Quphoria/Electronics-Project/5- Circuit Design/Pictures/IMG_9014.JPG

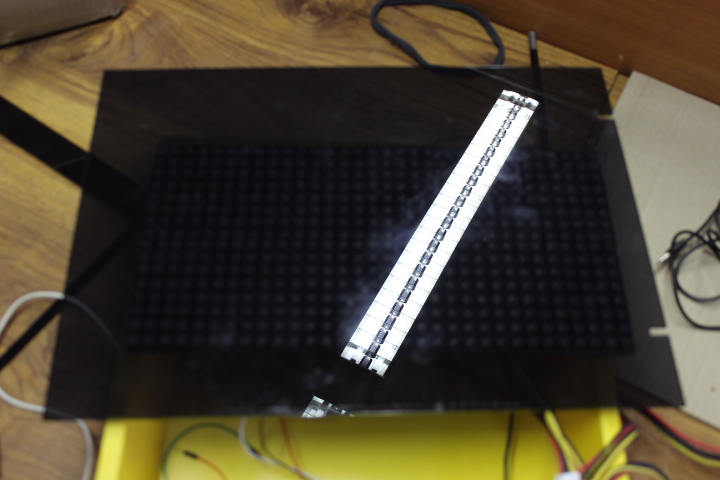
5- Circuit Design/Pictures/IMG_9014.JPG
