Quphoria/Electronics-Project/README.md

# Electronics-Project
Repo of my Project for my GCSE Electronics

The examiners will only see the powerpoint as that is what you submit along with the finished product
