Quphoria/Electronics-Project/5- Circuit Design/Electronics Project Connectors.docx

# Connectors

## Panel Mount

- IEC Power Connector
- DMX Input 3 Pin
- DMX Output 3 Pin

## PCB

- HT3.96mm 3P Glediator Port (5v, Rx, GND)
- 5v USB output for charging devices
- Audio Input 3.5mm Stereo Jack
- Audio Output 3.5mm Stereo Jack
- 3 Pole Mode Selector Switch
- SD Card Slot
