Quphoria/Electronics-Project/Slide Structure.docx

- Title Page - EXAM INFO
- Agenda
- Chosen Brief
- Research/ROI
- Functionalities
  - Overview
    - Functions
  - Control Interfaces
  - APIs
- Hardware
  - External
    - IO
  - Internal
    - PCB
      - Components
      - Circuit
      - IO
      - Programming Connectors
    - Components
    - Mounting Structures
- Software
  - Chosen Languages
  - External libraries
  - Firmware
    - Varieties
  - Software
    - APIs
- Documentation
  - IKEA Manual

Slide Structure
