Quphoria/Electronics-Project/0- Research/Other Electronics Stuff.docx

Other Electronics Stuff

WS2812b led panels, cheapest option available, easy to drive only 1 io pin required (in addition to power and ground) as they are chainable

32x16 led panel size as it is large enough to display enough detail without looking too blocky
