Quphoria/Electronics-Project/2- 3D Modelling/doc03636820170926103018.pdf

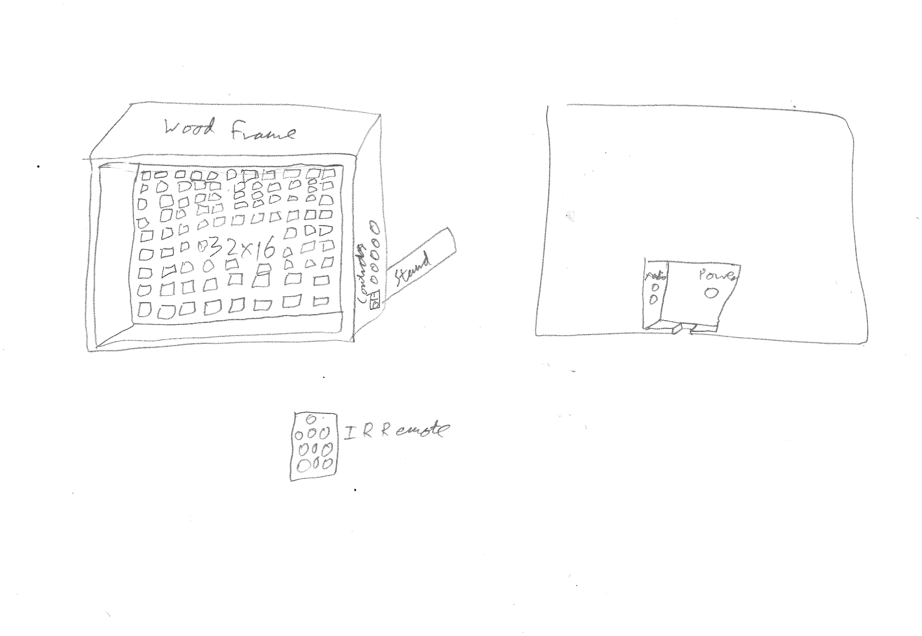
[picture p3: page 1]
