Quphoria/Electronics-Project/0- Research/5v-to-9v-converter.png

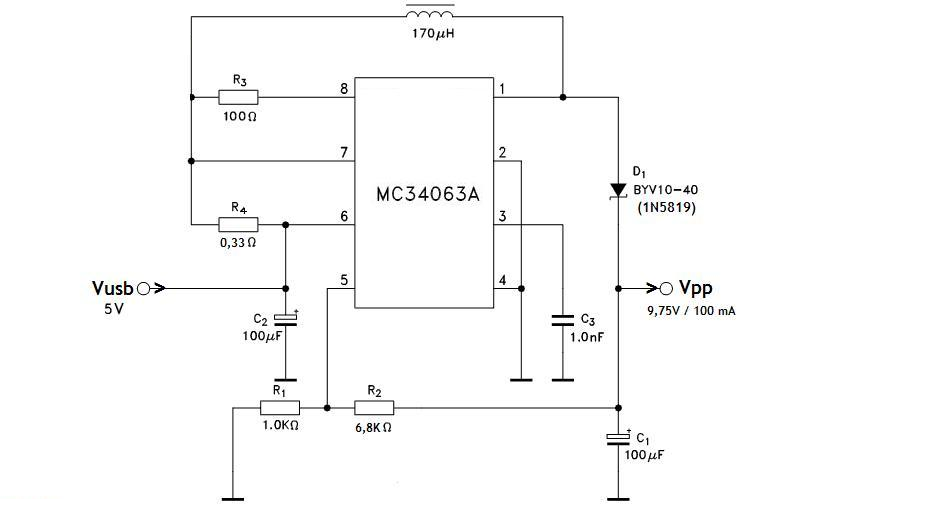
0- Research/5v-to-9v-converter.png
