Quphoria/Electronics-Project/0- Research/ADC mic pre-amp.png

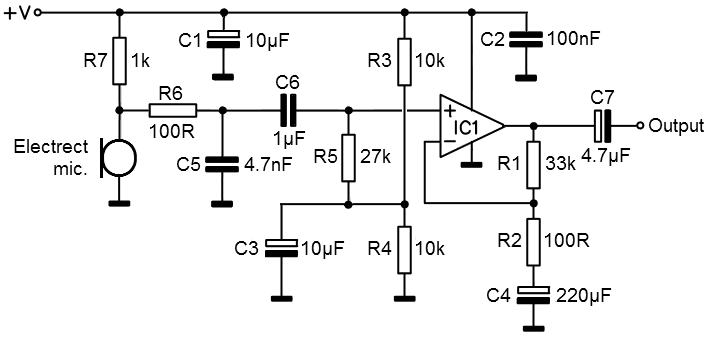
0- Research/ADC mic pre-amp.png
