Quphoria/Electronics-Project/0- Research/ALC.jpg

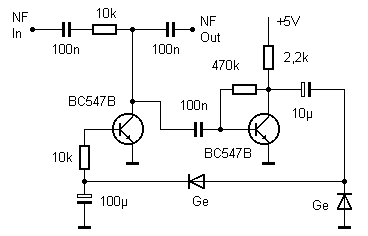
0- Research/ALC.jpg
