Quphoria/Electronics-Project/0- Research/arduino-control-relay-schematic.png

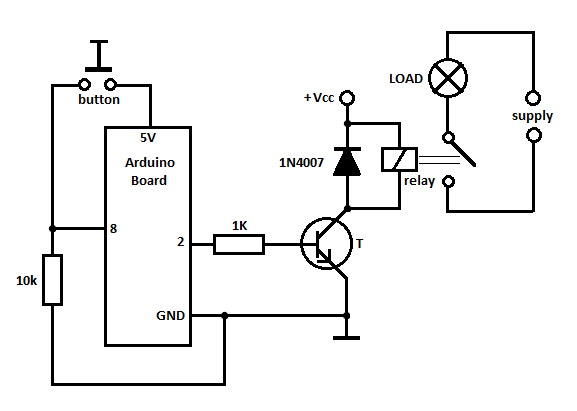
0- Research/arduino-control-relay-schematic.png
