Quphoria/Electronics-Project/0- Research/atmega1284_mighty_pinout.png

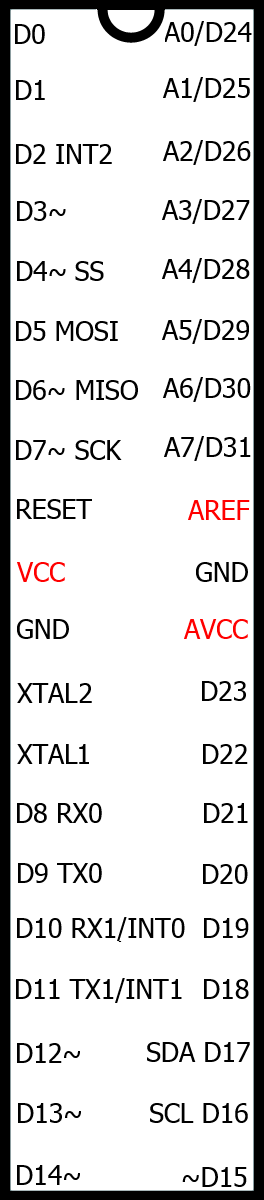
0- Research/atmega1284_mighty_pinout.png
