Quphoria/Electronics-Project/0- Research/atmega1284pins.gif

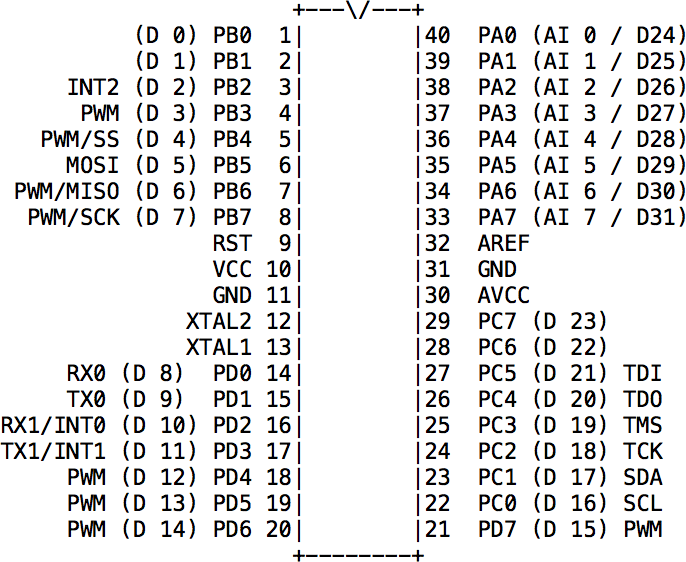
0- Research/atmega1284pins.gif
