Quphoria/Electronics-Project/0- Research/audio-input-amplifier-better.png

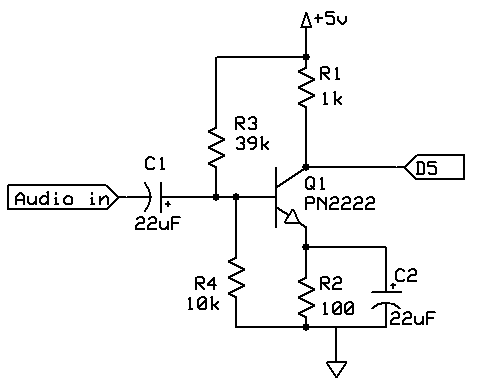
0- Research/audio-input-amplifier-better.png
