Quphoria/Electronics-Project/0- Research/audio_premini_opamp-rev01.png

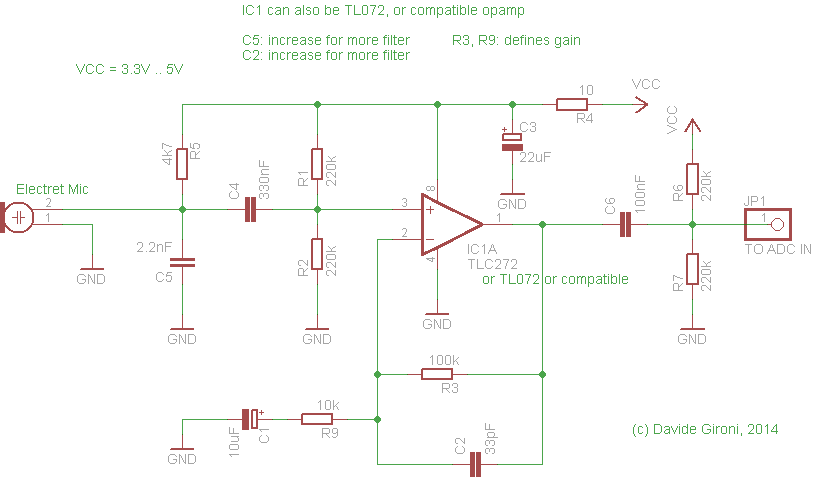
0- Research/audio_premini_opamp-rev01.png
