Quphoria/Electronics-Project/0- Research/buffer-envelope.jpg

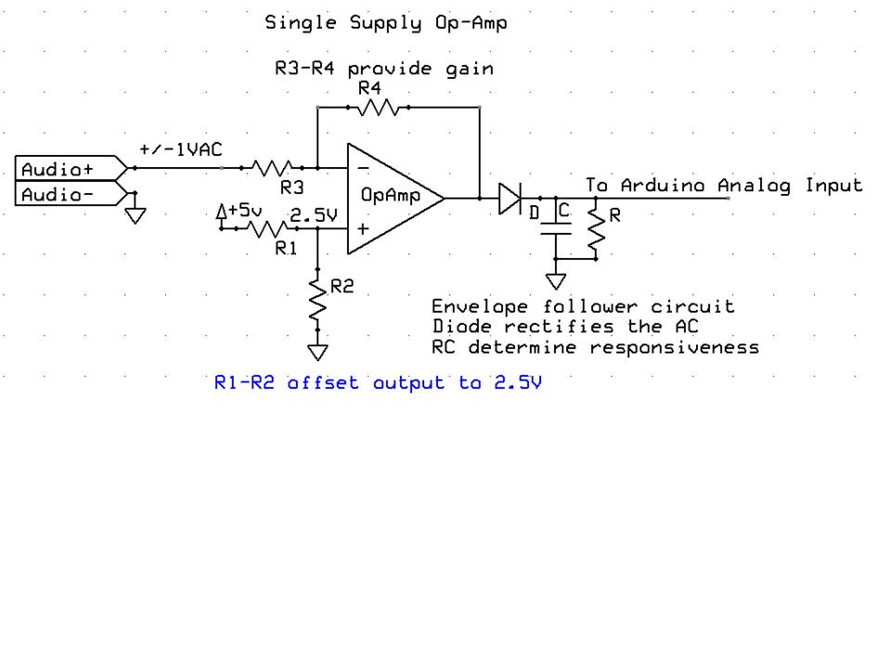
0- Research/buffer-envelope.jpg
