Quphoria/Electronics-Project/0- Research/Electret mic preamp.PNG

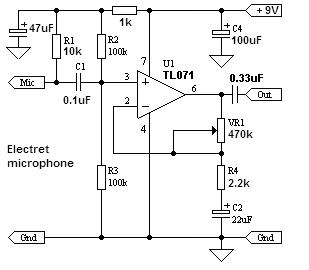
0- Research/Electret mic preamp.PNG
