Quphoria/Electronics-Project/0- Research/Mono-to-stereo.gif

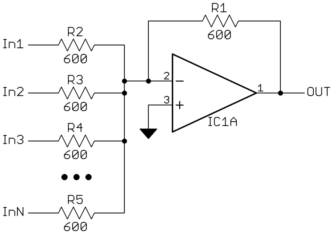
0- Research/Mono-to-stereo.gif
