Quphoria/Electronics-Project/0- Research/preamp_circuit.png

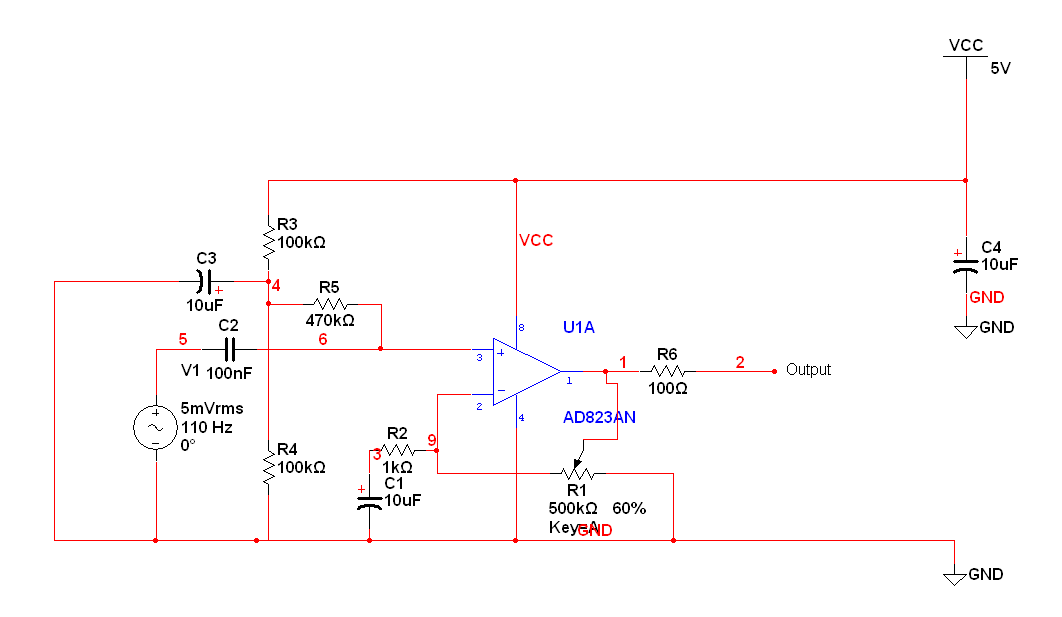
0- Research/preamp_circuit.png
