Quphoria/Electronics-Project/0- Research/ScreenShot_20180316131631.png

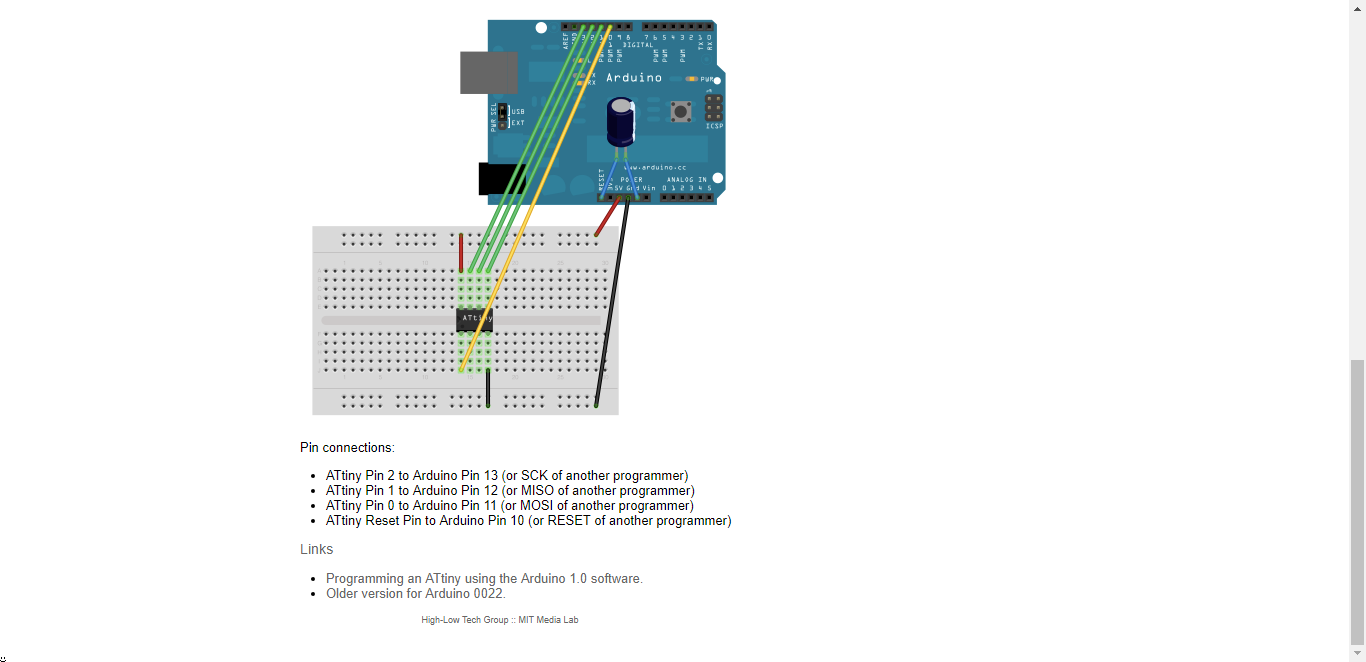
0- Research/ScreenShot_20180316131631.png
