Quphoria/Electronics-Project/0- Research/zofzJ.png

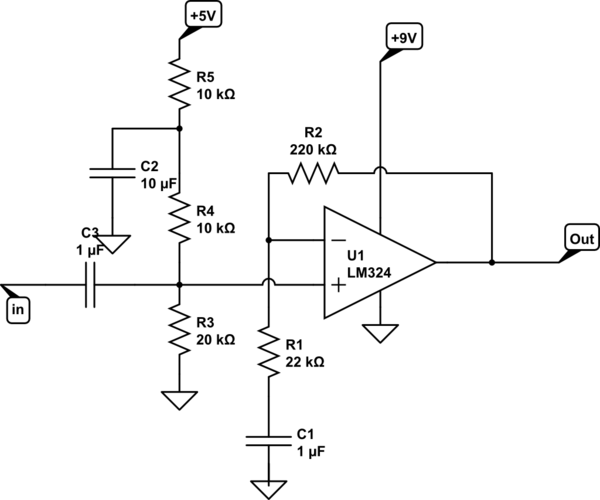
0- Research/zofzJ.png
