Quphoria/Electronics-Project/2- 3D Modelling/Pictures/20180205_141921.jpg

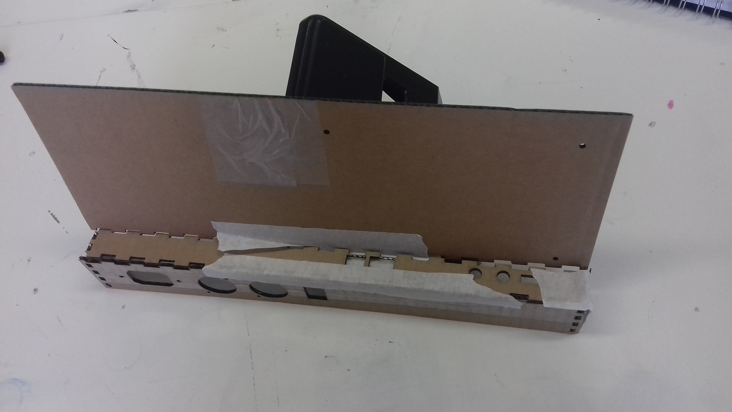
2- 3D Modelling/Pictures/20180205_141921.jpg
