Quphoria/Electronics-Project/3- Renders/V47/Design v47 _ Back Panel.png

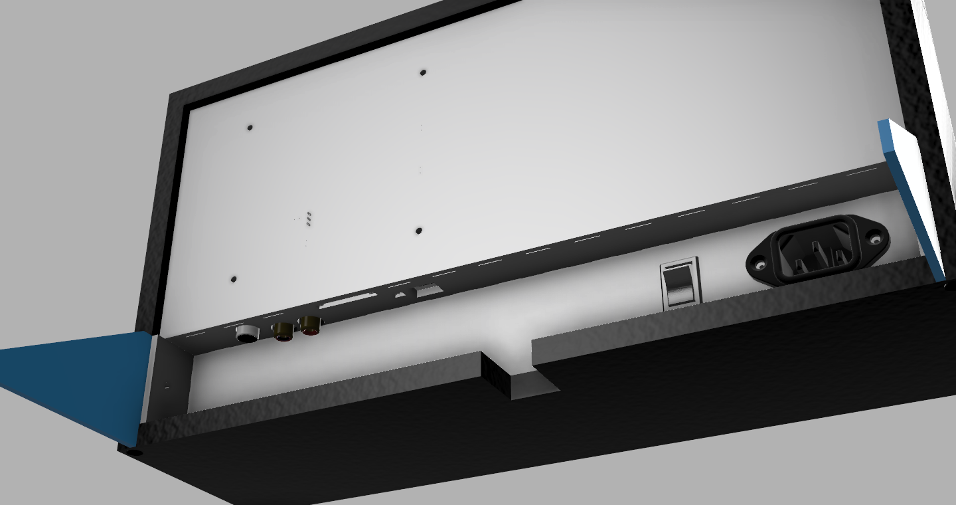
3- Renders/V47/Design v47 _ Back Panel.png
