Quphoria/Electronics-Project/3- Renders/V47/Design v47 _ IO.png

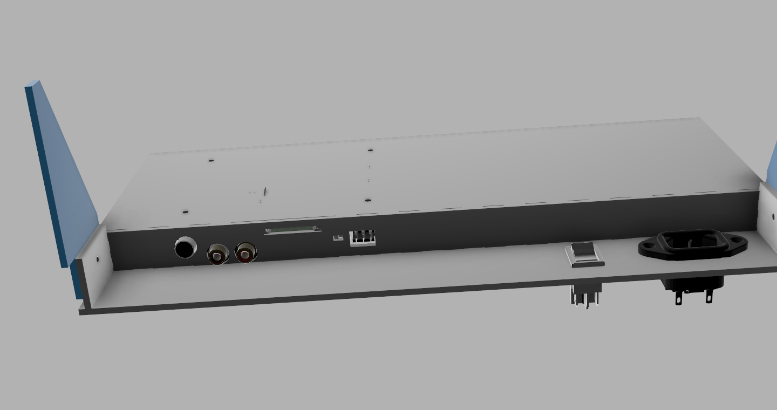
3- Renders/V47/Design v47 _ IO.png
