Quphoria/Electronics-Project/3- Renders/V47/Design v47 _ Side Inside.png

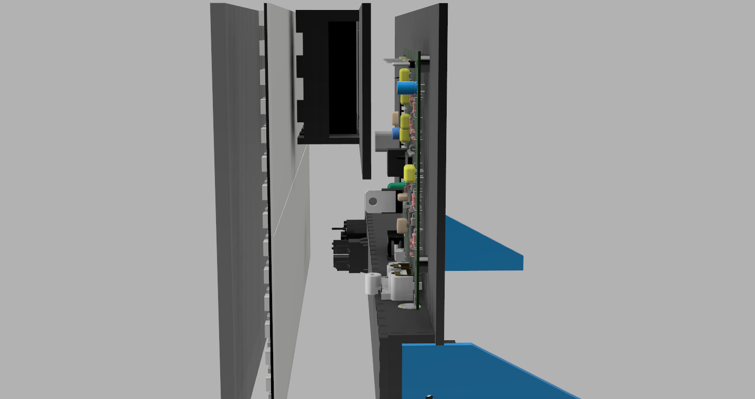
3- Renders/V47/Design v47 _ Side Inside.png
