Quphoria/Electronics-Project/4- 2D Exports/Photos (2)/20171108_210314.jpg

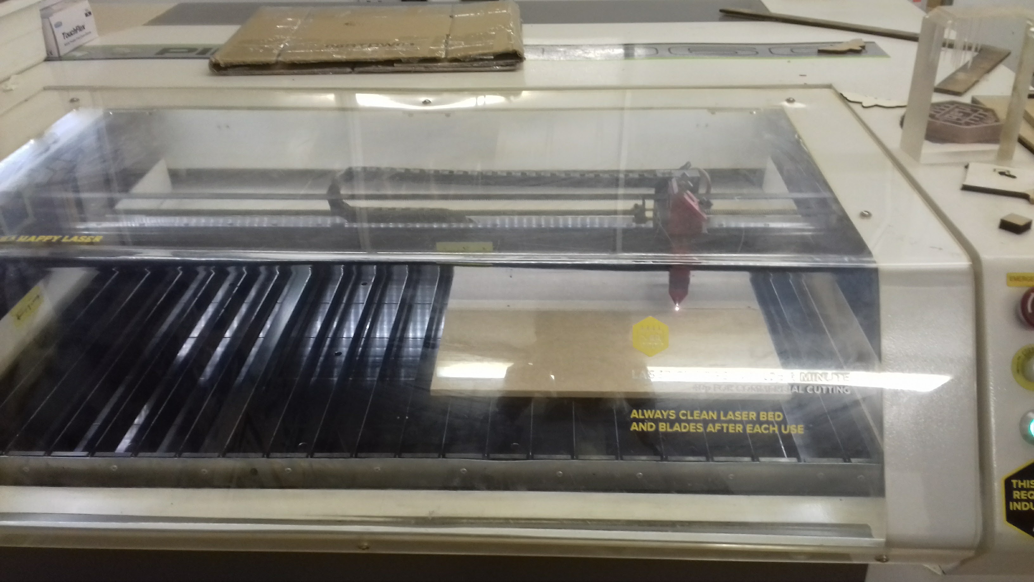
4- 2D Exports/Photos (2)/20171108_210314.jpg
