Quphoria/Electronics-Project/4- 2D Exports/Photos (2)/20171109_074142.jpg

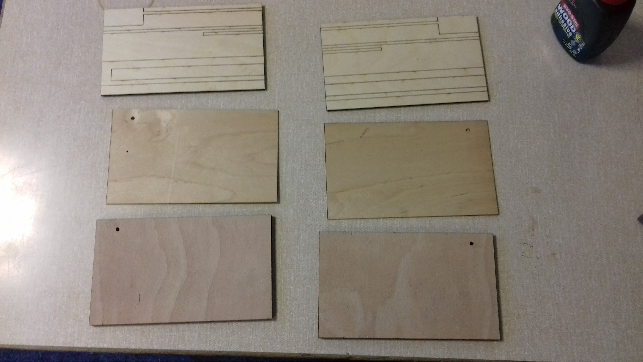
4- 2D Exports/Photos (2)/20171109_074142.jpg
