Quphoria/Electronics-Project/4- 2D Exports/Photos (2)/20171109_153801.jpg

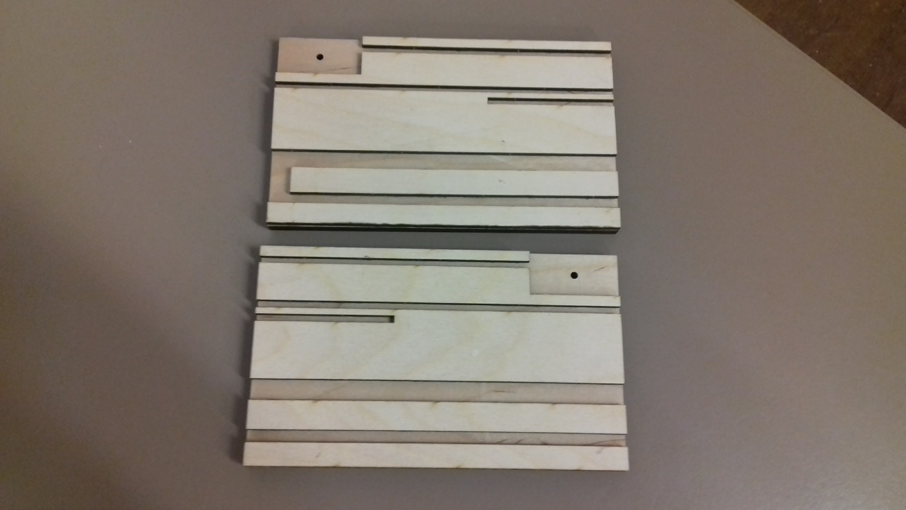
4- 2D Exports/Photos (2)/20171109_153801.jpg
