Quphoria/Electronics-Project/4- 2D Exports/Photos (2)/20171112_120552.jpg

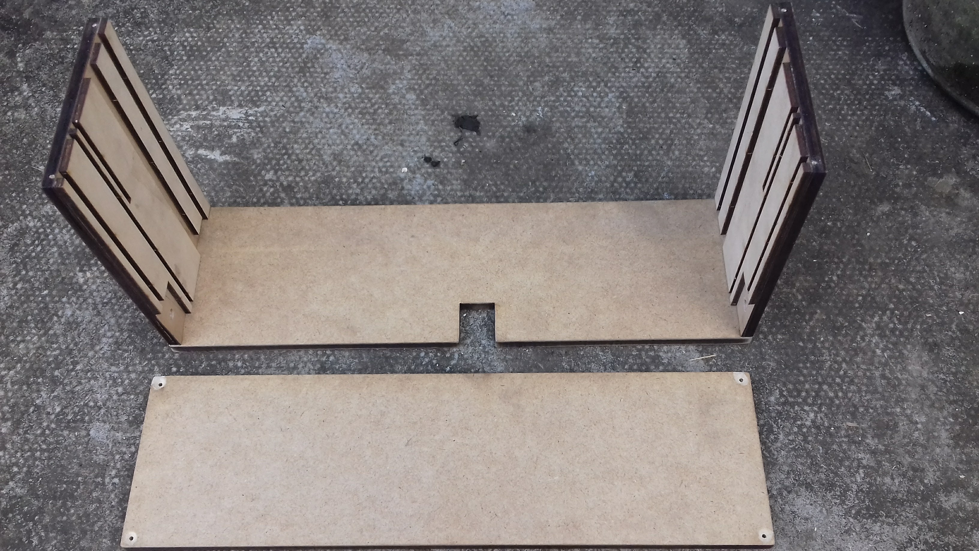
4- 2D Exports/Photos (2)/20171112_120552.jpg
