Quphoria/Electronics-Project/4- 2D Exports/Photos (2)/20180123_092703.jpg

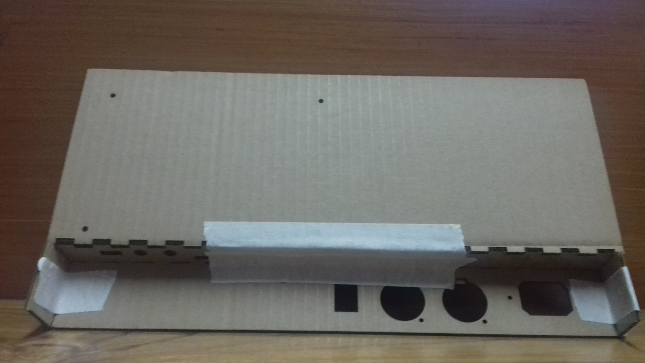
4- 2D Exports/Photos (2)/20180123_092703.jpg
