Quphoria/Electronics-Project/4- 2D Exports/Photos (2)/20180227_095030.jpg

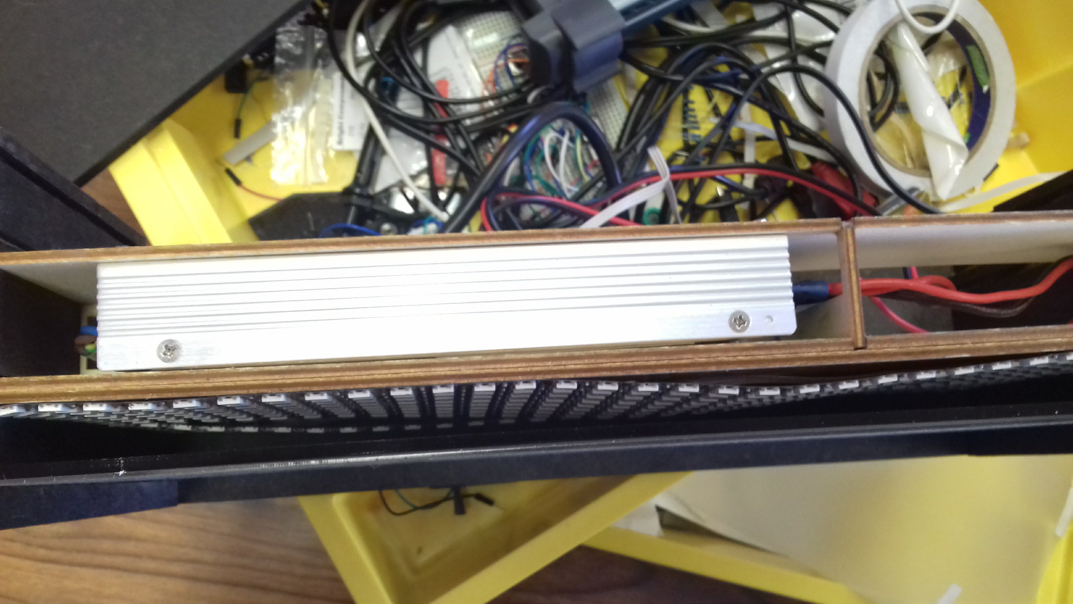
4- 2D Exports/Photos (2)/20180227_095030.jpg
