Quphoria/Electronics-Project/4- 2D Exports/Photos (2)/20180228_175823.jpg

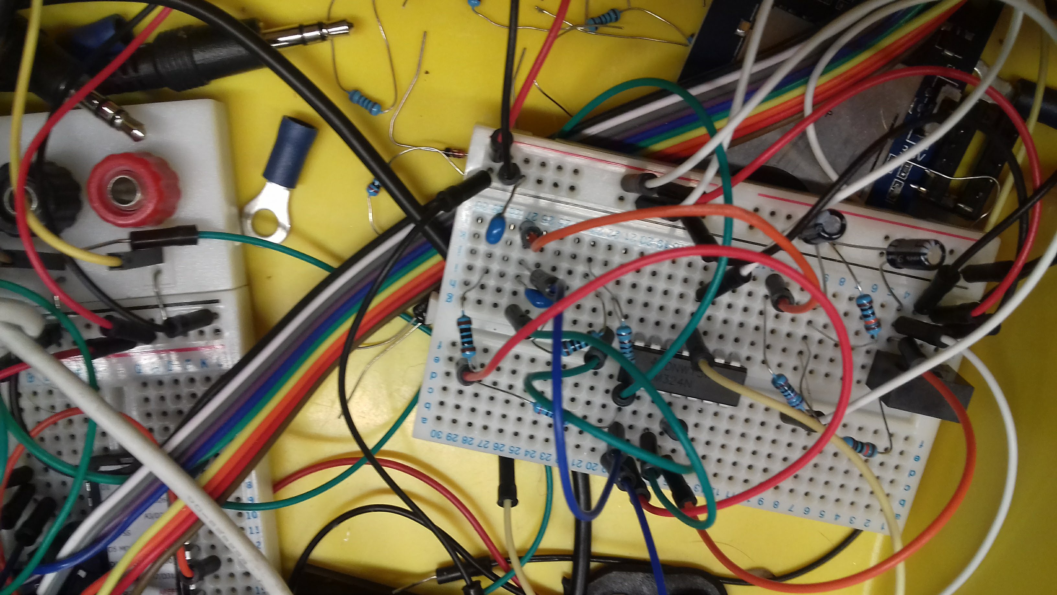
4- 2D Exports/Photos (2)/20180228_175823.jpg
