Quphoria/Electronics-Project/4- 2D Exports/Photos (2)/20180306_091829(0).jpg

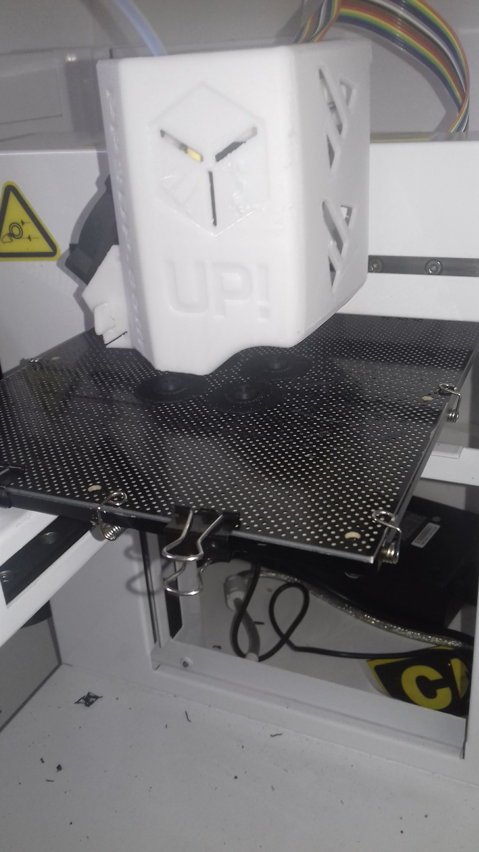
4- 2D Exports/Photos (2)/20180306_091829(0).jpg
