Quphoria/Electronics-Project/4- 2D Exports/Photos (2)/20180312_135606.jpg

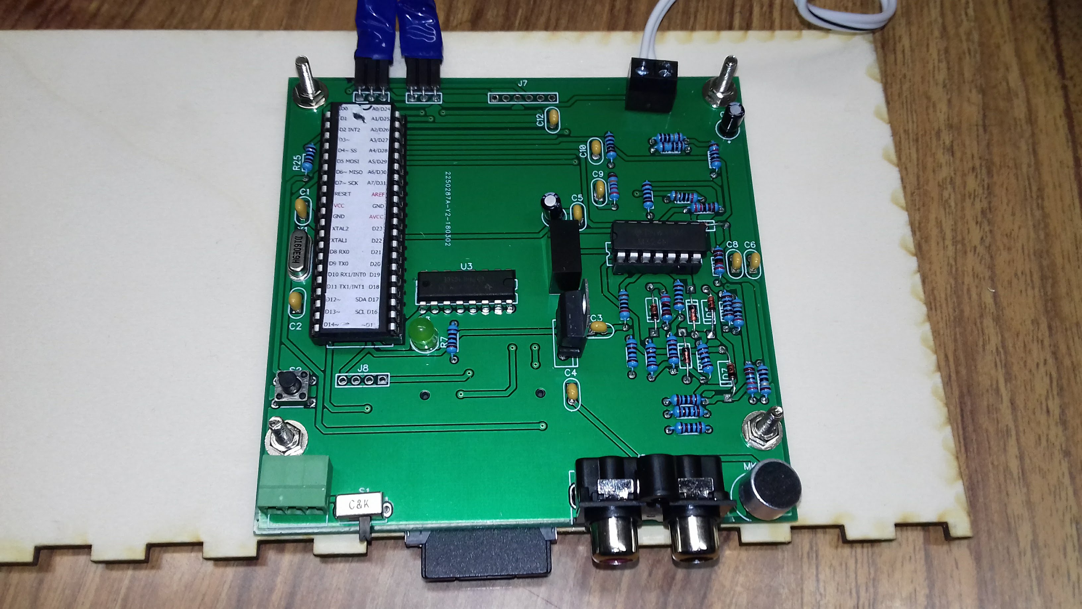
4- 2D Exports/Photos (2)/20180312_135606.jpg
