Quphoria/Electronics-Project/4- 2D Exports/Photos (2)/20180314_144740.jpg

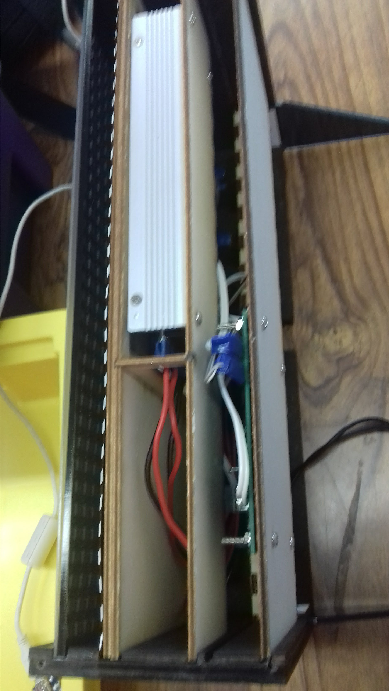
4- 2D Exports/Photos (2)/20180314_144740.jpg
