Quphoria/Electronics-Project/4- 2D Exports/Photos (2)/20180321_145808.jpg

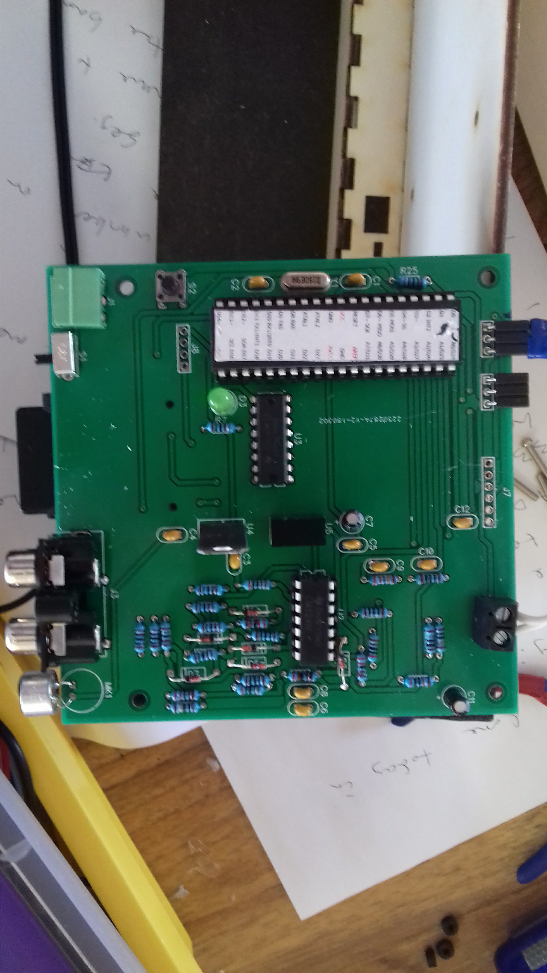
4- 2D Exports/Photos (2)/20180321_145808.jpg
