Quphoria/Electronics-Project/4- 2D Exports/Photos (2)/20180321_153848.jpg

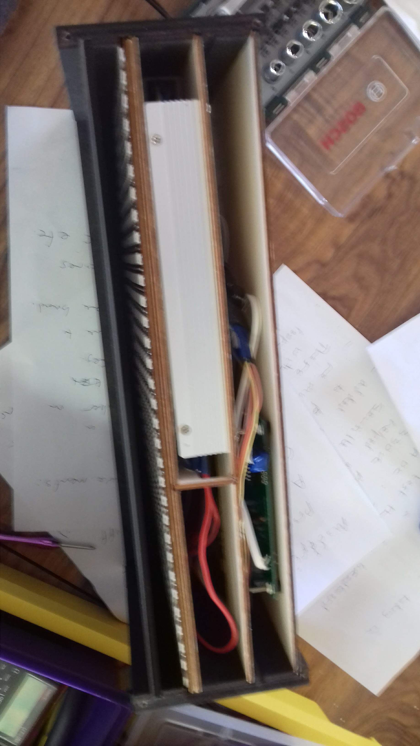
4- 2D Exports/Photos (2)/20180321_153848.jpg
