Quphoria/Electronics-Project/4- 2D Exports/Photos (2)/20180322_100650.jpg

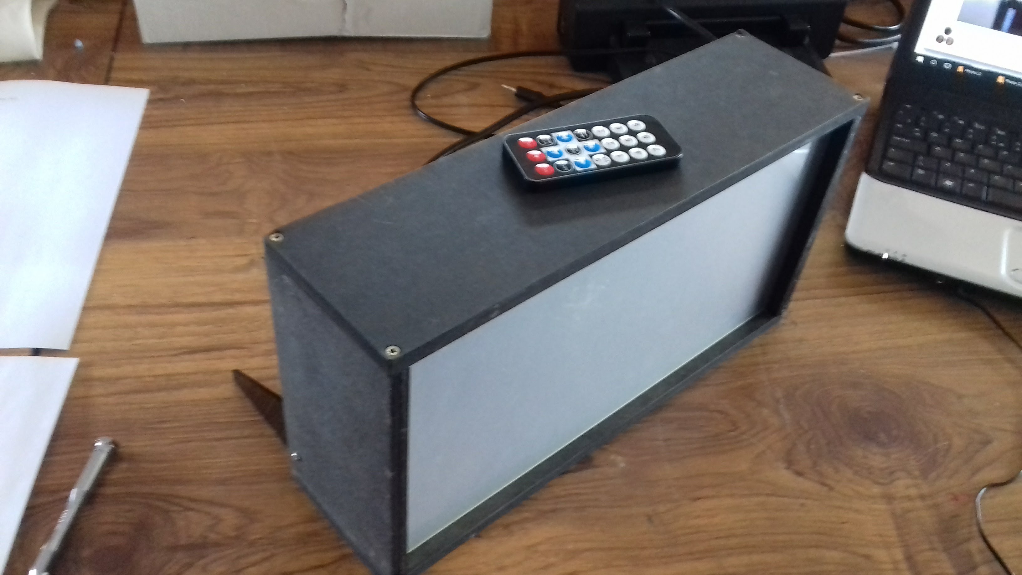
4- 2D Exports/Photos (2)/20180322_100650.jpg
