Quphoria/Electronics-Project/5- Circuit Design/Pictures/20171003_100548.jpg

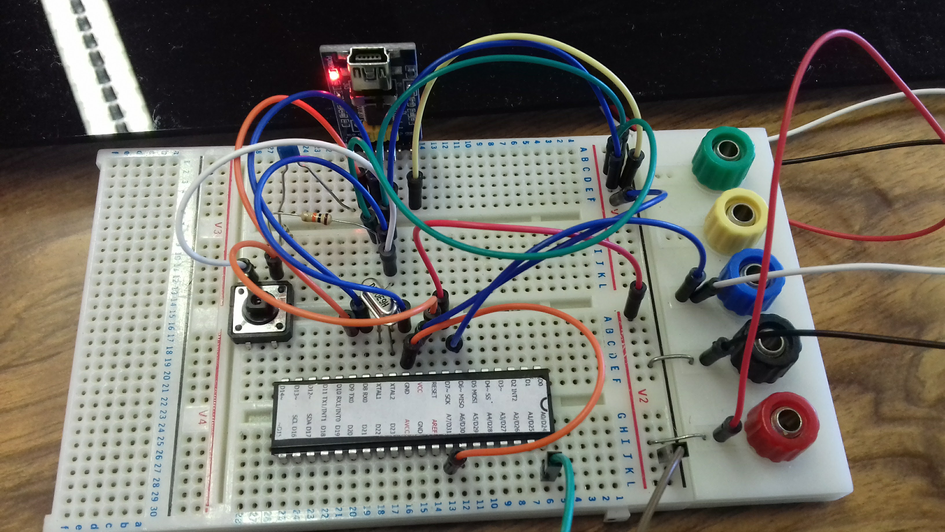
5- Circuit Design/Pictures/20171003_100548.jpg
