Quphoria/Electronics-Project/5- Circuit Design/Pictures/20171003_100621.jpg

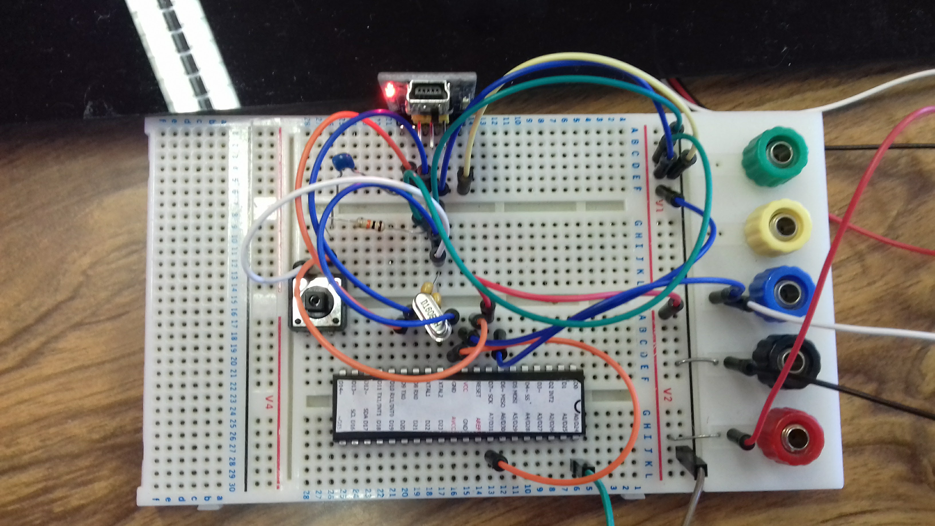
5- Circuit Design/Pictures/20171003_100621.jpg
