Quphoria/Electronics-Project/5- Circuit Design/Pictures/IMG_9013.JPG

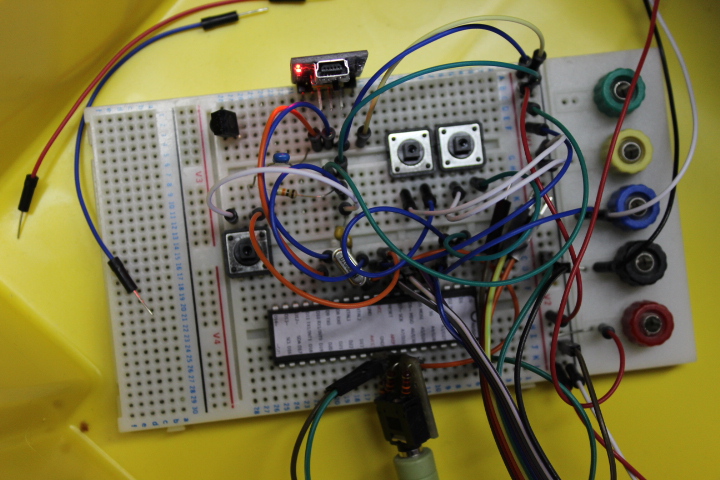
5- Circuit Design/Pictures/IMG_9013.JPG
