Quphoria/Electronics-Project/5- Circuit Design/Pictures/IMG_9015.JPG

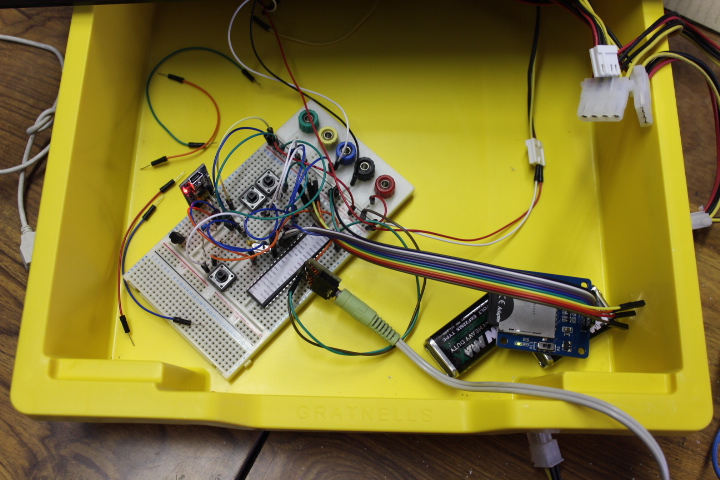
5- Circuit Design/Pictures/IMG_9015.JPG
