Quphoria/Electronics-Project/5- Circuit Design/Pictures/IMG_9018.JPG

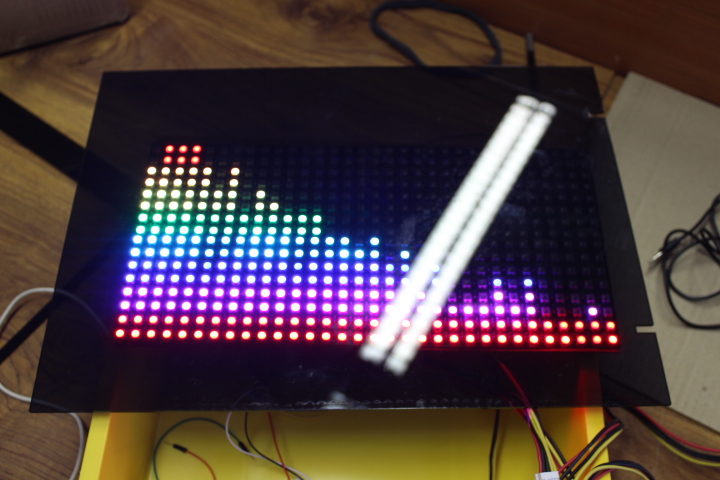
5- Circuit Design/Pictures/IMG_9018.JPG
