Quphoria/Electronics-Project/5- Circuit Design/Pictures/IMG_9019.JPG

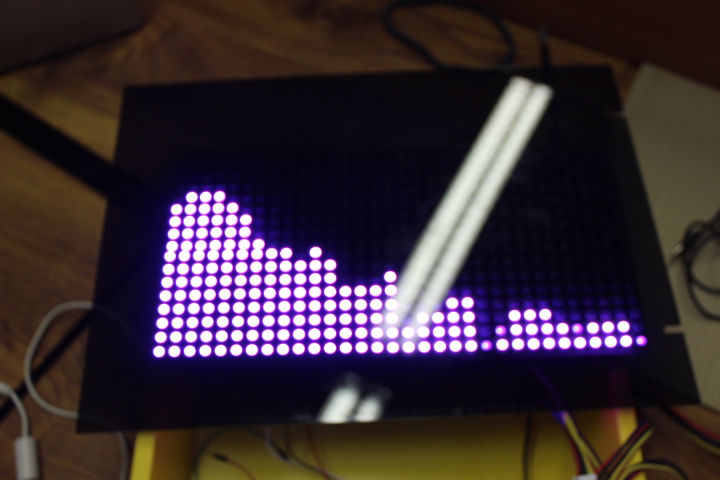
5- Circuit Design/Pictures/IMG_9019.JPG
