Quphoria/Electronics-Project/5- Circuit Design/Pictures/IMG_9020.JPG

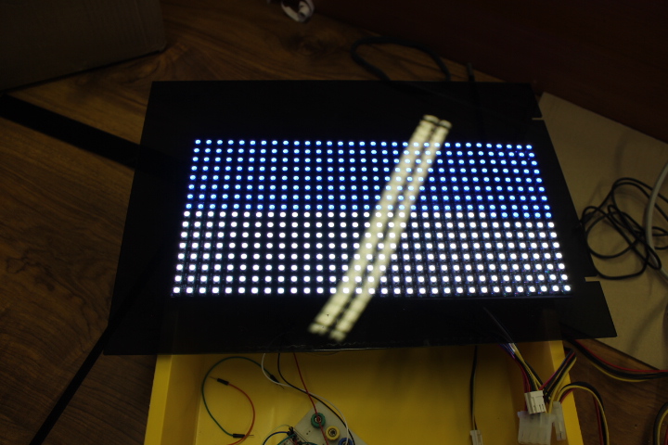
5- Circuit Design/Pictures/IMG_9020.JPG
