Quphoria/Electronics-Project/5- Circuit Design/Pictures/IMG_9021.JPG

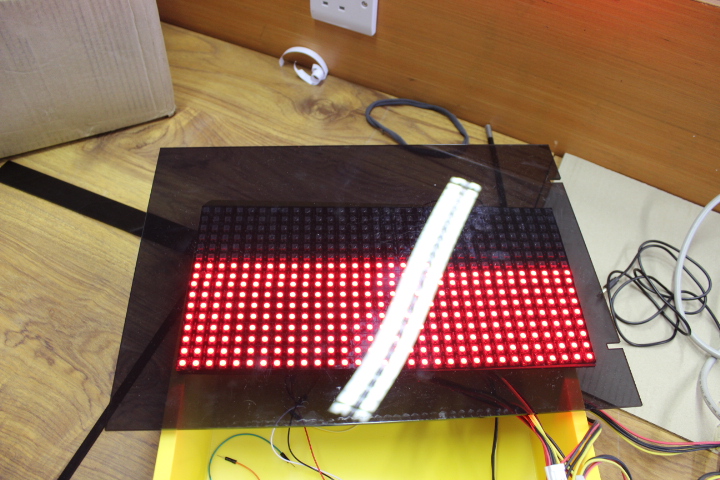
5- Circuit Design/Pictures/IMG_9021.JPG
