Quphoria/Electronics-Project/5- Circuit Design/Pictures/IMG_9022.JPG

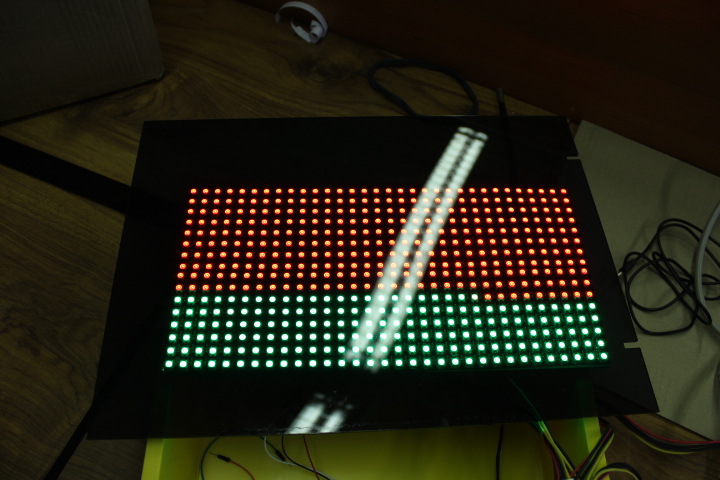
5- Circuit Design/Pictures/IMG_9022.JPG
