Quphoria/Electronics-Project/5- Circuit Design/Pictures/IR_Board_Schem.png

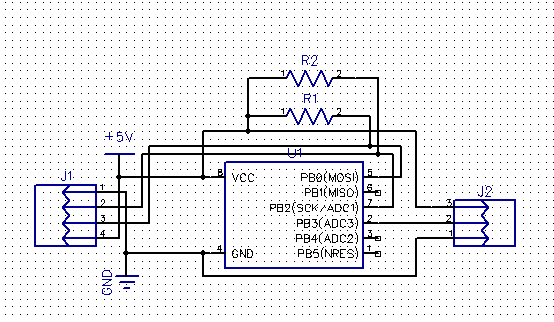
5- Circuit Design/Pictures/IR_Board_Schem.png
