Quphoria/Electronics-Project/5- Circuit Design/Pictures/PCBBottom.png

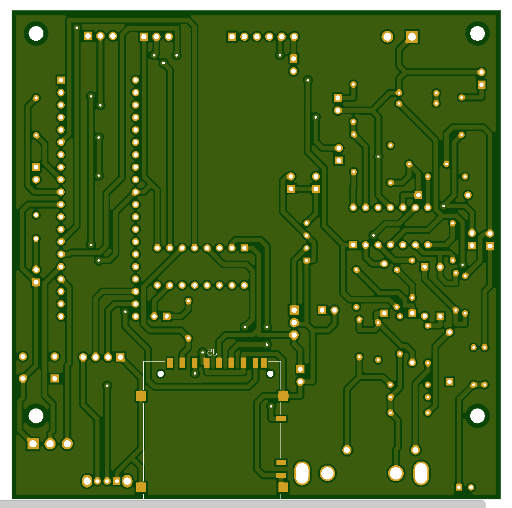
5- Circuit Design/Pictures/PCBBottom.png
