Quphoria/Electronics-Project/5- Circuit Design/Pictures/PCBTop.png

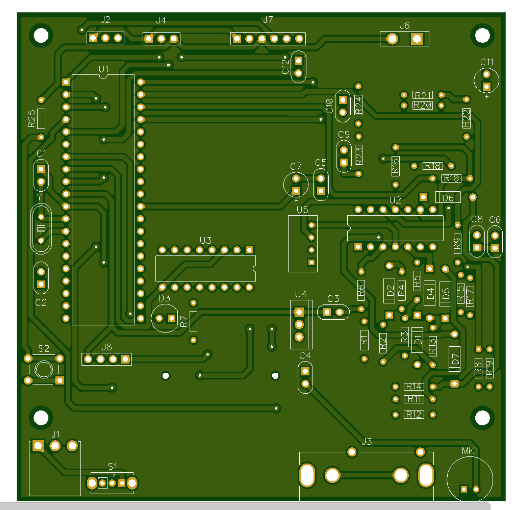
5- Circuit Design/Pictures/PCBTop.png
