Quphoria/Electronics-Project/5- Circuit Design/Pictures/Schematic.png

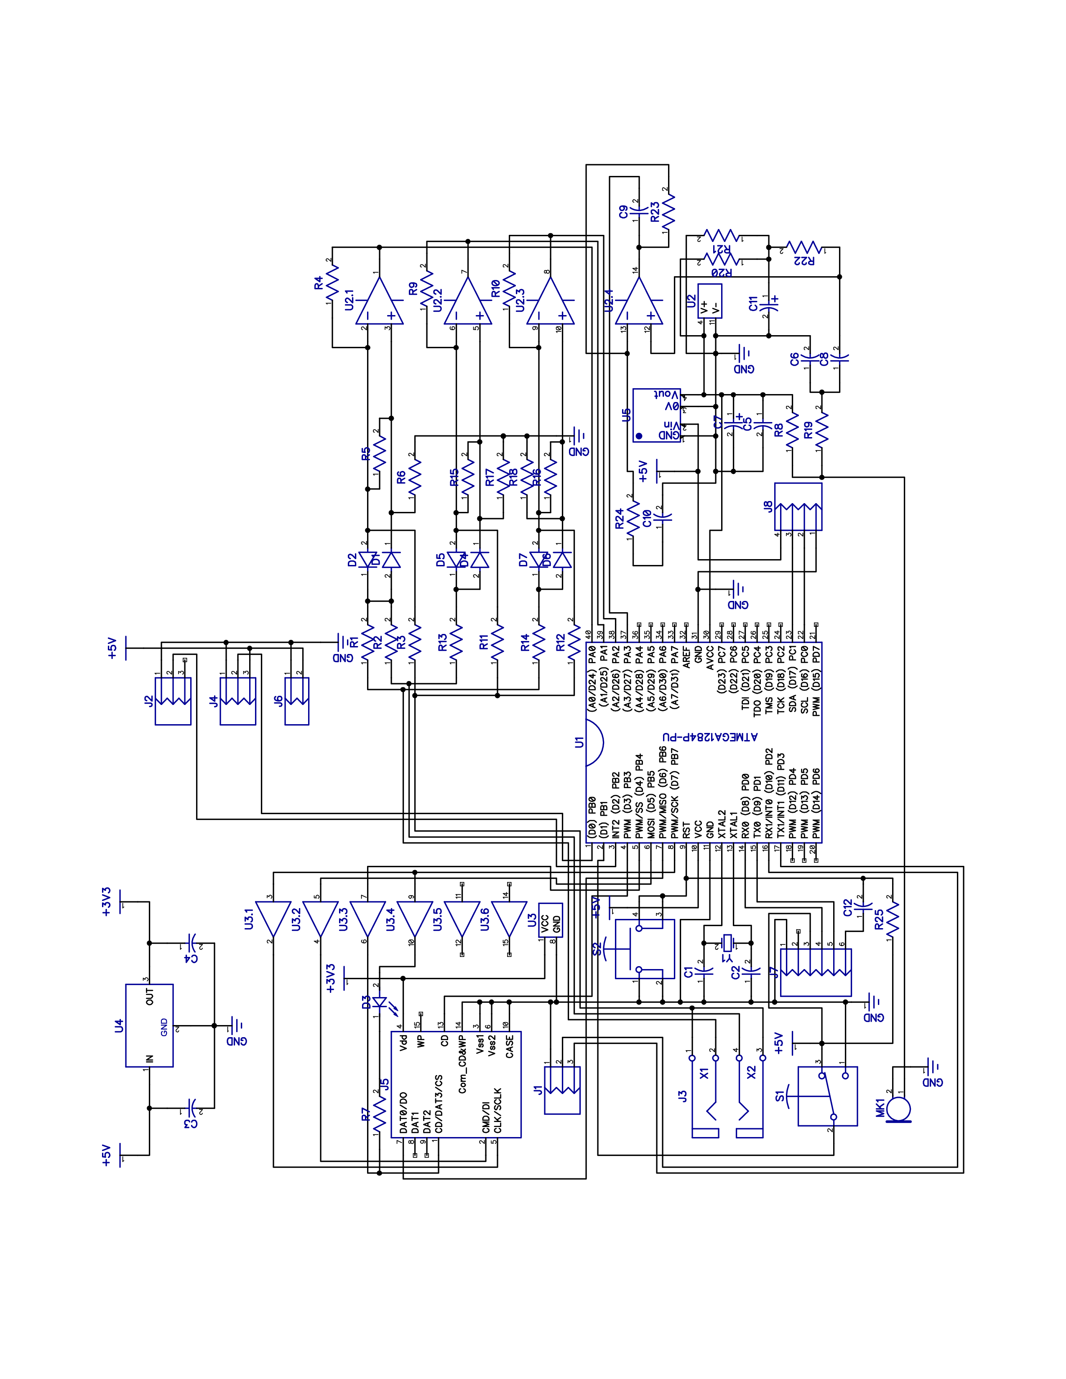
5- Circuit Design/Pictures/Schematic.png
