Quphoria/Electronics-Project/5- Circuit Design/Pictures/ScreenShot_20180125225506.png

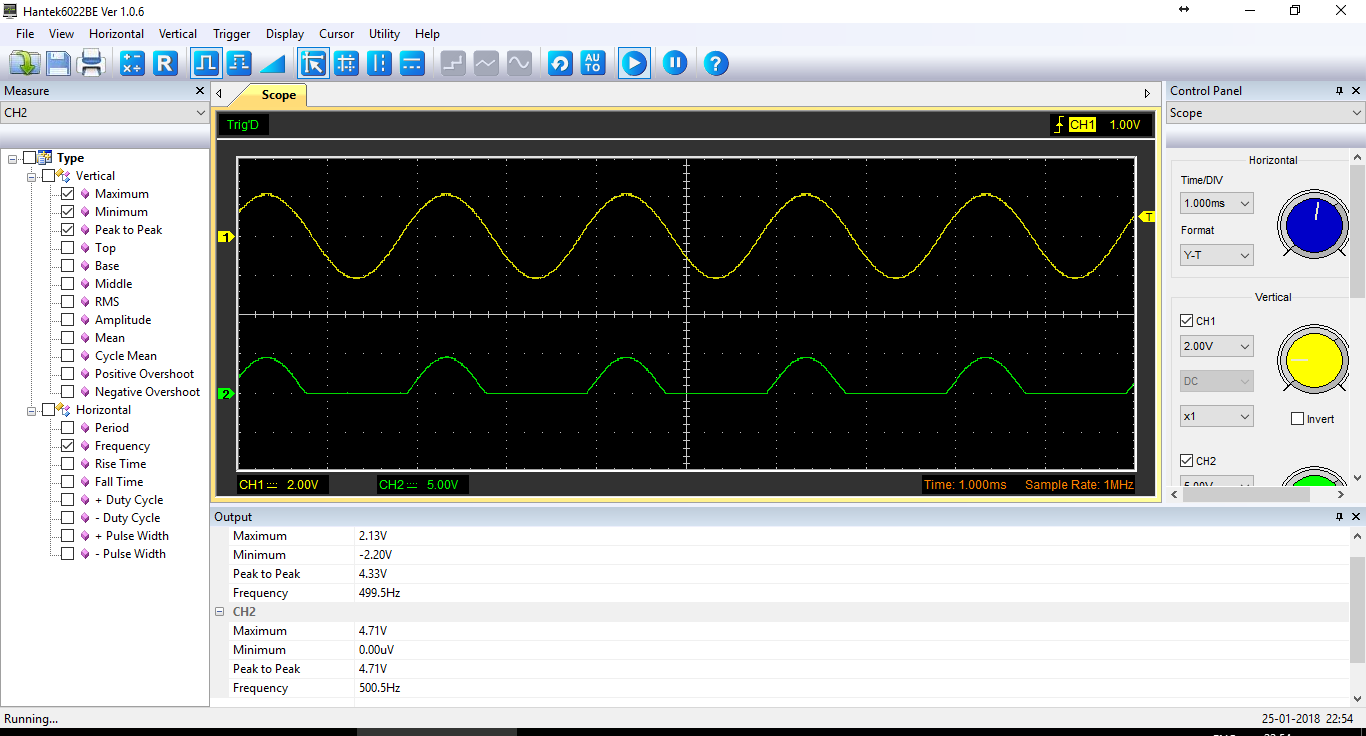
5- Circuit Design/Pictures/ScreenShot_20180125225506.png
