Quphoria/Electronics-Project/5- Circuit Design/Pictures/ScreenShot_20180126074123.png

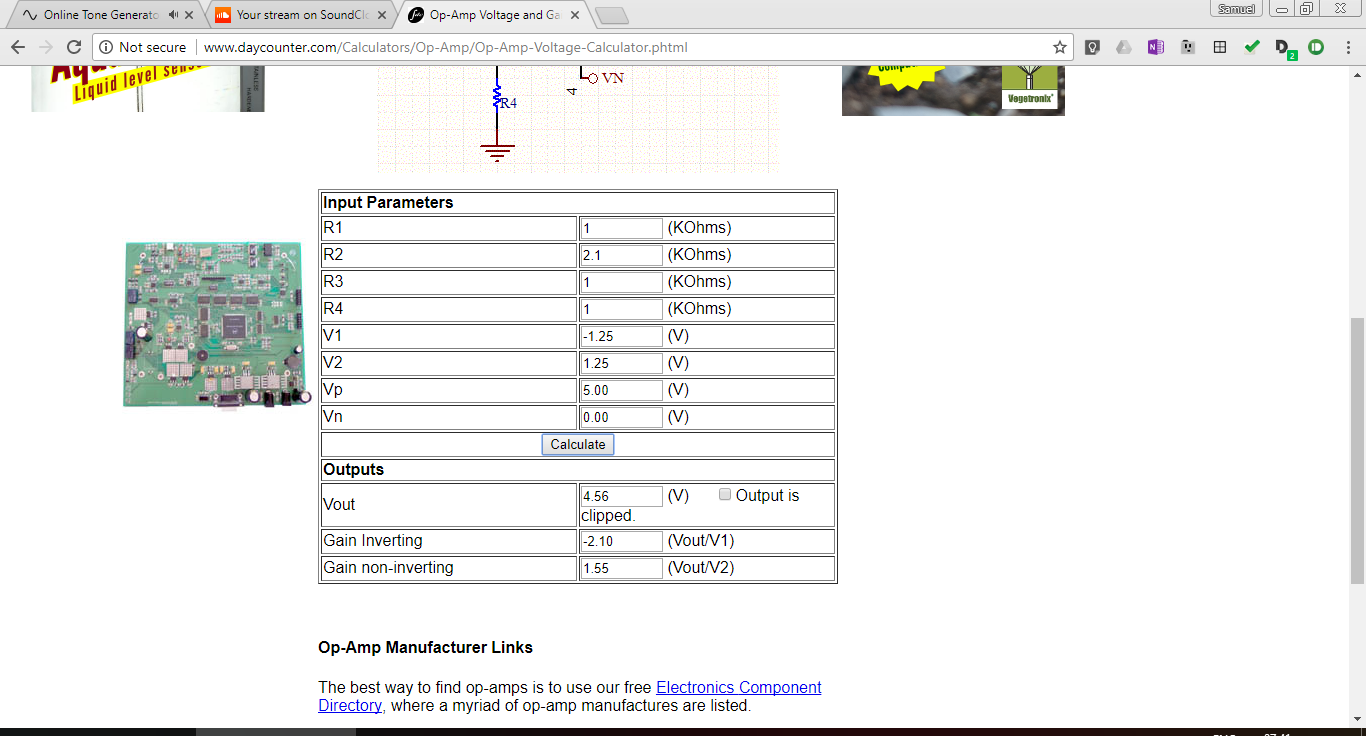
5- Circuit Design/Pictures/ScreenShot_20180126074123.png
