Quphoria/Electronics-Project/5- Circuit Design/Pictures/ScreenShot_20180301112355 - Mic.png

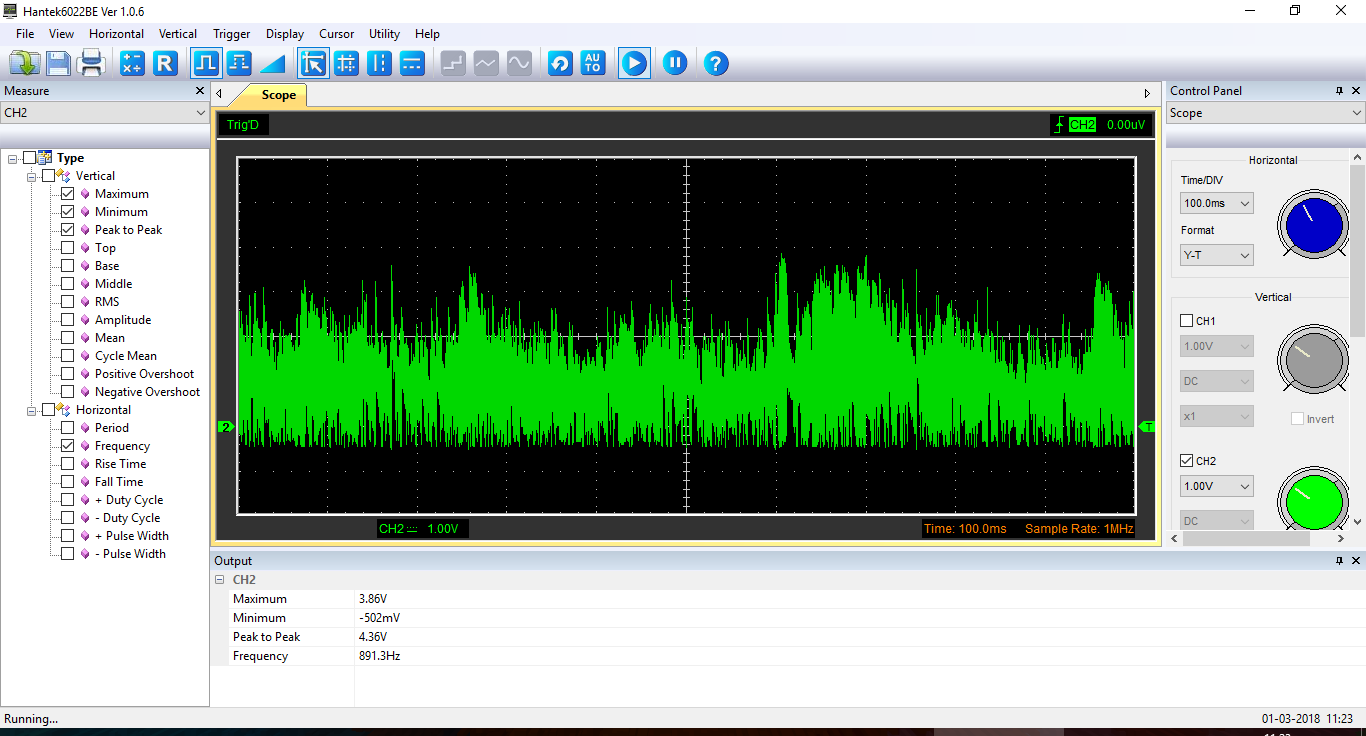
5- Circuit Design/Pictures/ScreenShot_20180301112355 - Mic.png
