Quphoria/Electronics-Project/5- Circuit Design/Pictures/ScreenShot_20180303102331 _ 3D PCB Back.png

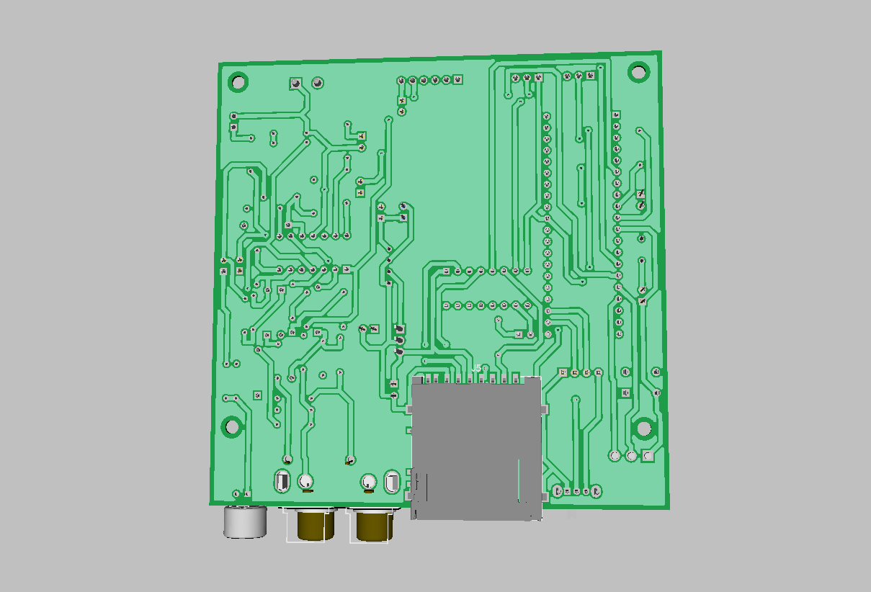
5- Circuit Design/Pictures/ScreenShot_20180303102331 _ 3D PCB Back.png
