Quphoria/Electronics-Project/5- Circuit Design/Pictures/ScreenShot_20180303102408 _ 3D PCB Front.png

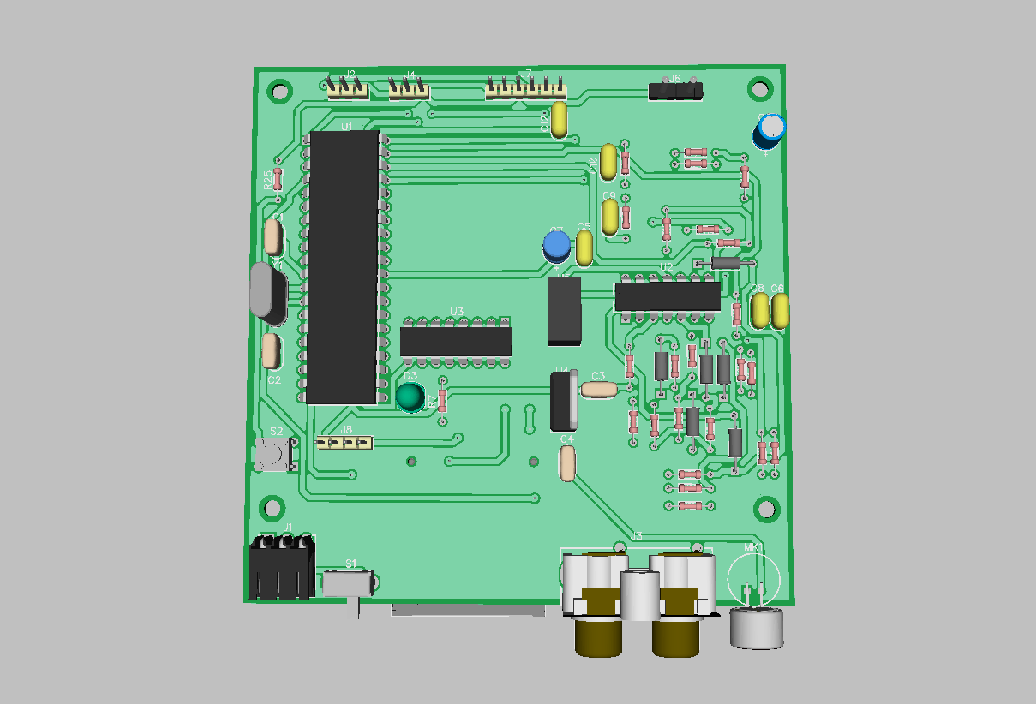
5- Circuit Design/Pictures/ScreenShot_20180303102408 _ 3D PCB Front.png
