Quphoria/Electronics-Project/5- Circuit Design/Pictures/ScreenShot_20180303102440 _ 3D PCB Side.png

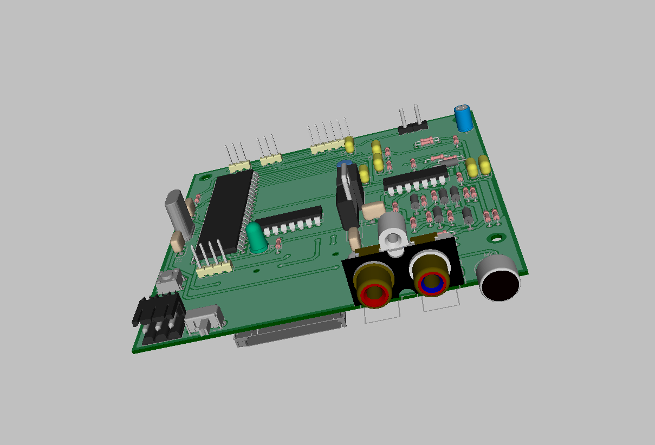
5- Circuit Design/Pictures/ScreenShot_20180303102440 _ 3D PCB Side.png
