Quphoria/Electronics-Project/5- Circuit Design/Pictures/ScreenShot_20180303102508 _ 3D PCB Side 2.png

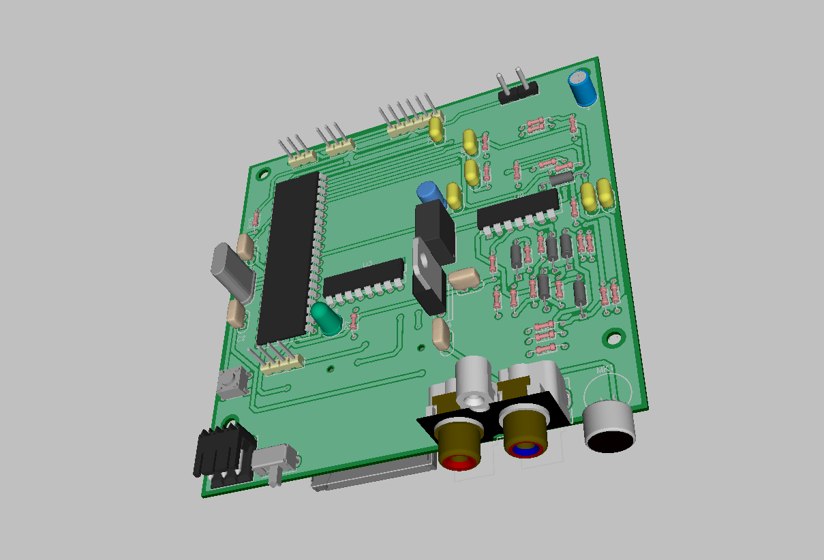
5- Circuit Design/Pictures/ScreenShot_20180303102508 _ 3D PCB Side 2.png
