Quphoria/Electronics-Project/5- Circuit Design/Pictures/ScreenShot_20180303102555 _ PCB Status 77.png

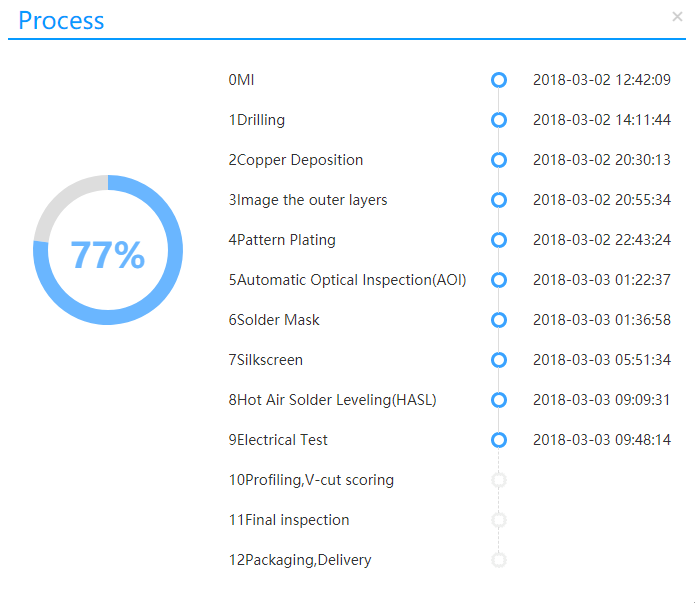
5- Circuit Design/Pictures/ScreenShot_20180303102555 _ PCB Status 77.png
