Quphoria/Electronics-Project/6- Programming/0- Image Converter/SCAN0001.JPG

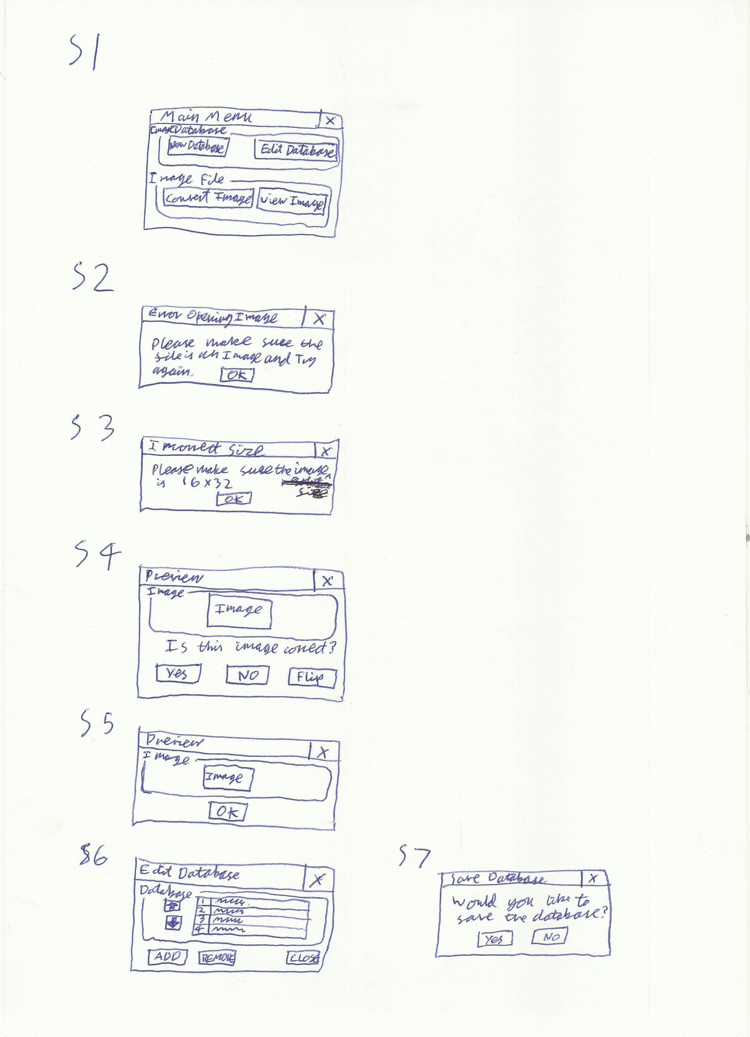
6- Programming/0- Image Converter/SCAN0001.JPG
