Quphoria/Electronics-Project/6- Programming/0- Image Converter/Screenshots/ScreenShot_20180325222139.png

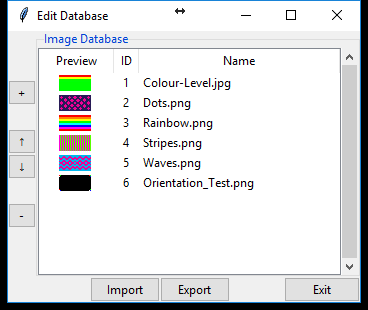
6- Programming/0- Image Converter/Screenshots/ScreenShot_20180325222139.png
