Quphoria/Electronics-Project/6- Programming/ScreenShot_20180302112759 _ Program Start.png

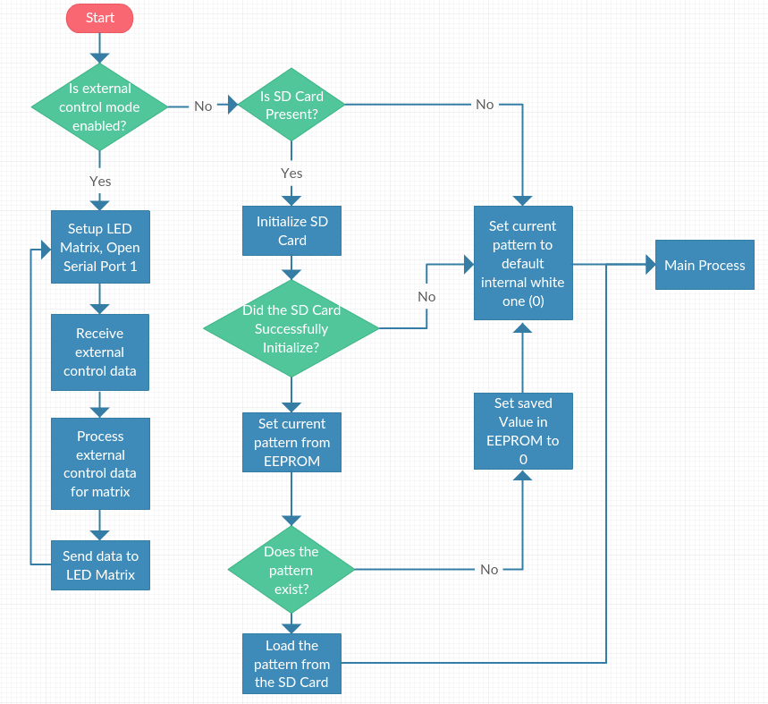
6- Programming/ScreenShot_20180302112759 _ Program Start.png
