Quphoria/Electronics-Project/6- Programming/ScreenShot_20180302112841 _ Main Process.png

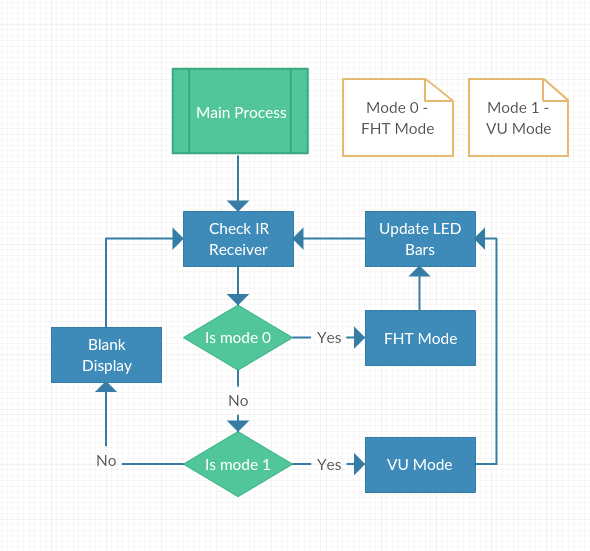
6- Programming/ScreenShot_20180302112841 _ Main Process.png
