Quphoria/Electronics-Project/6- Programming/ScreenShot_20180302112857 _ Display Functions.png

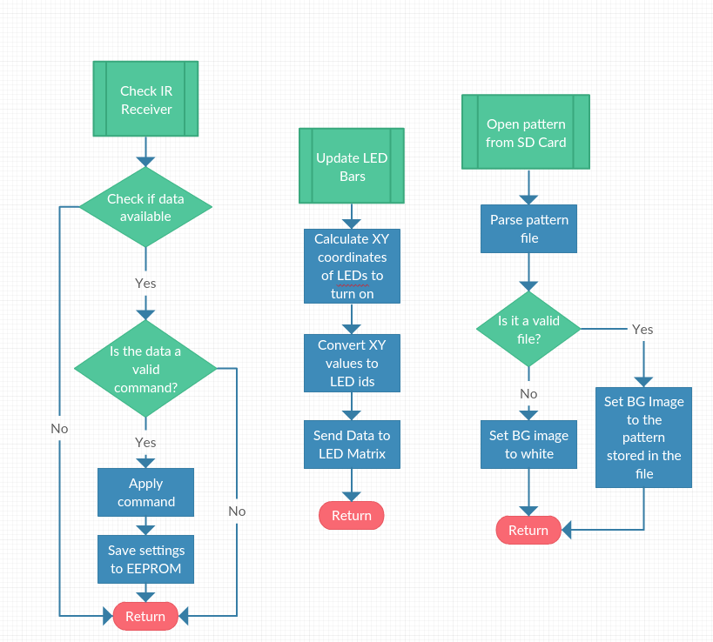
6- Programming/ScreenShot_20180302112857 _ Display Functions.png
