Quphoria/Electronics-Project/6- Programming/ScreenShot_20180302112916 _ Process Functions.png

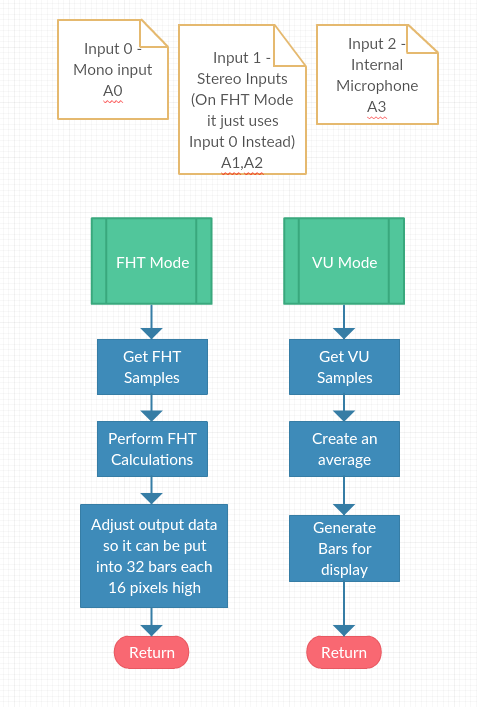
6- Programming/ScreenShot_20180302112916 _ Process Functions.png
