Quphoria/Electronics-Project/7- Analysis/Photos/20180322_161521.jpg

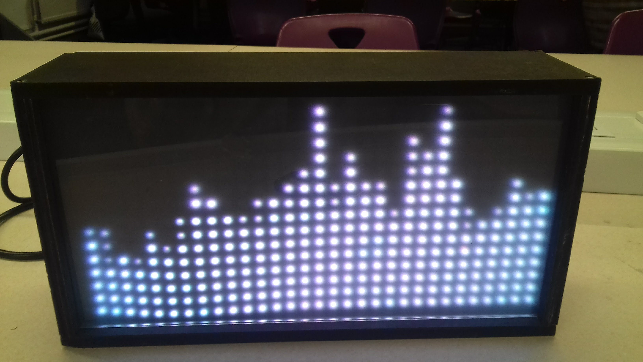
7- Analysis/Photos/20180322_161521.jpg
