Quphoria/Electronics-Project/7- Analysis/Photos/20180322_161544.jpg

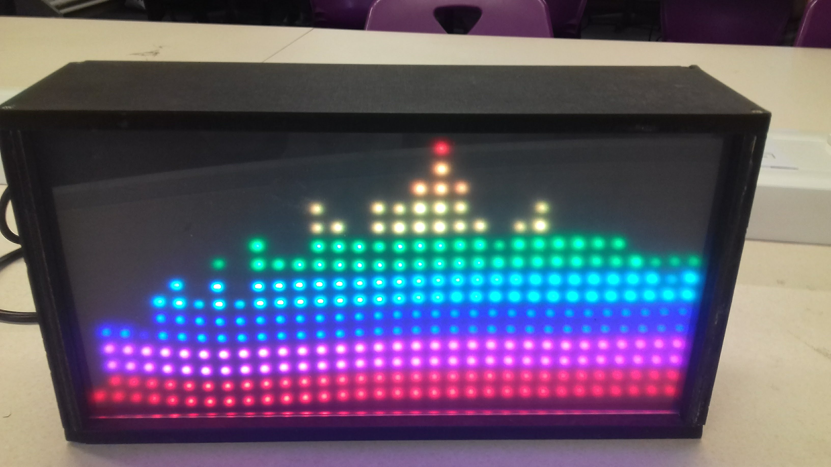
7- Analysis/Photos/20180322_161544.jpg
