Quphoria/Electronics-Project/7- Analysis/Photos/20180322_161549.jpg

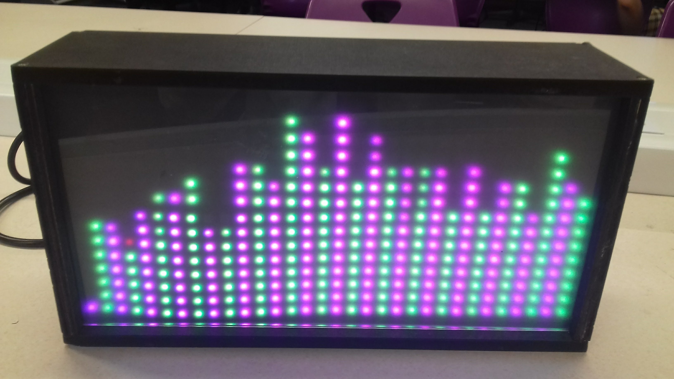
7- Analysis/Photos/20180322_161549.jpg
