Quphoria/Electronics-Project/4- 2D Exports/Back Power Supply Holder.dxf

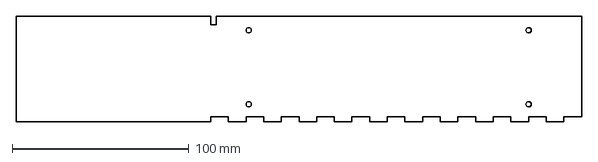
[picture p84: CAD file, 2019-01-07]
4- 2D Exports/Back Power Supply Holder.dxf
320.0 x 60.0 mm
