Quphoria/Electronics-Project/4- 2D Exports/Back cover inside.dxf

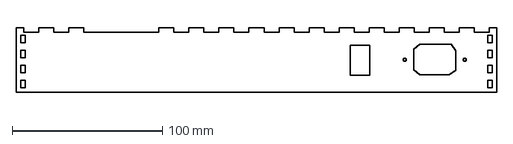
[picture p85: CAD file, 2019-01-07]
4- 2D Exports/Back cover inside.dxf
320.0 x 43.0 mm
