Quphoria/Electronics-Project/5- Circuit Design/3D Models/User Library-RCA-1.STEP

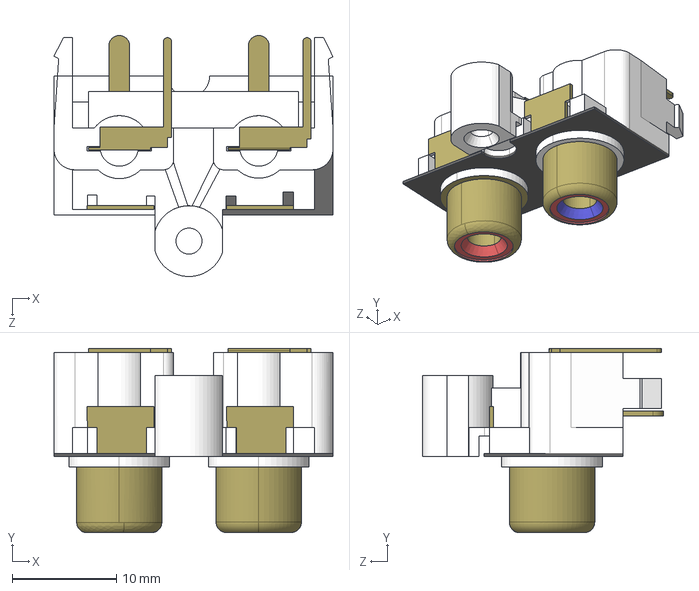
[picture p86: CAD file, 2019-01-07]
5- Circuit Design/3D Models/User Library-RCA-1.STEP
26.8 x 17.7 x 23.1 mm
