Quphoria/Electronics-Project/4- 2D Exports/PCB Spacer.stl

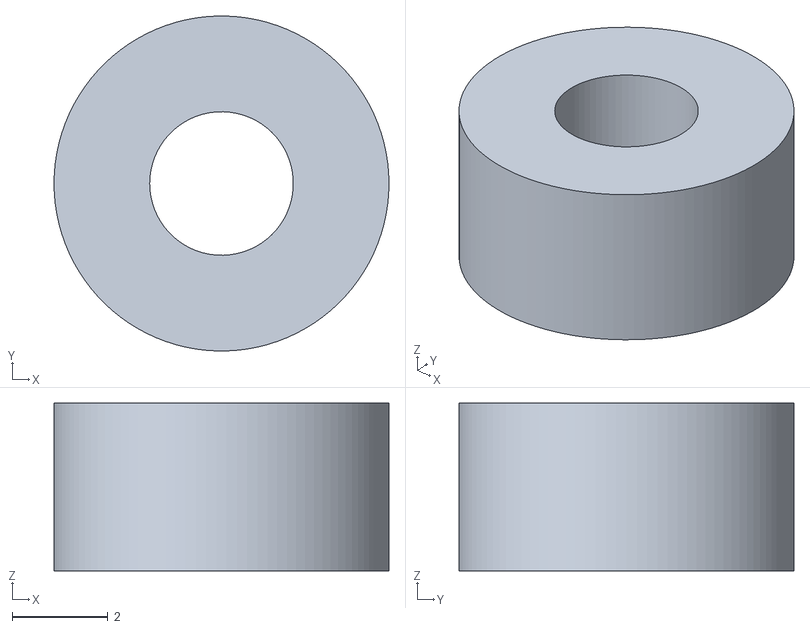
[picture p87: CAD file, 2019-01-07]
4- 2D Exports/PCB Spacer.stl
7.00 x 7.00 x 3.50
