Quphoria/Electronics-Project/5- Circuit Design/3D Models/c-292303-4-f-3d.stp

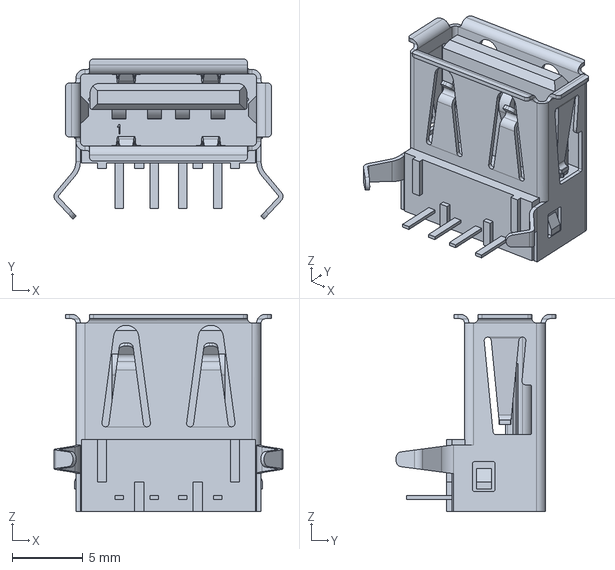
[picture p88: CAD file, 2017-10-03]
5- Circuit Design/3D Models/c-292303-4-f-3d.stp
16.2 x 11.4 x 14.0 mm
