Quphoria/Electronics-Project/4- 2D Exports/Back cover top.dxf

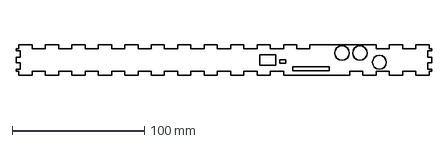
[picture p89: CAD file, 2019-01-07]
4- 2D Exports/Back cover top.dxf
314.0 x 23.0 mm
