Quphoria/Electronics-Project/5- Circuit Design/3D Models/sj1-3515.stp

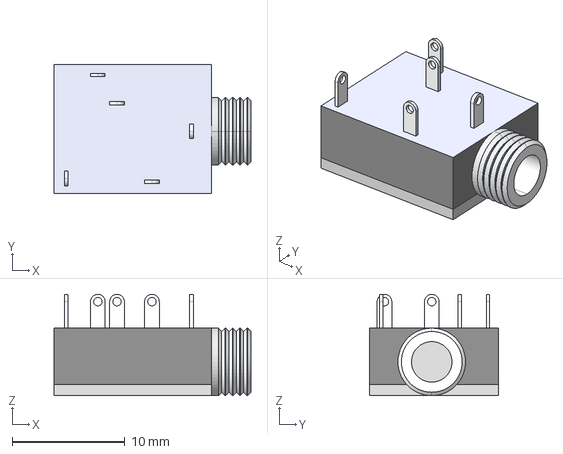
[picture p90: CAD file, 2017-10-03]
5- Circuit Design/3D Models/sj1-3515.stp
17.5 x 11.5 x 9.00 mm
