Quphoria/Electronics-Project/4- 2D Exports/Back cover.dxf

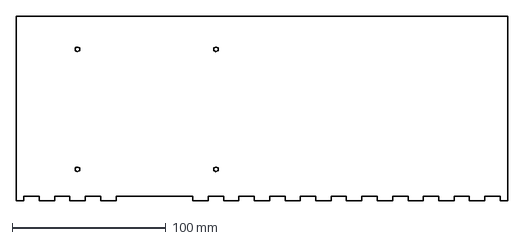
[picture p91: CAD file, 2019-01-07]
4- 2D Exports/Back cover.dxf
320.0 x 120.0 mm
