Quphoria/Electronics-Project/5- Circuit Design/3D Models/c-1825118-01-a-3d.stp

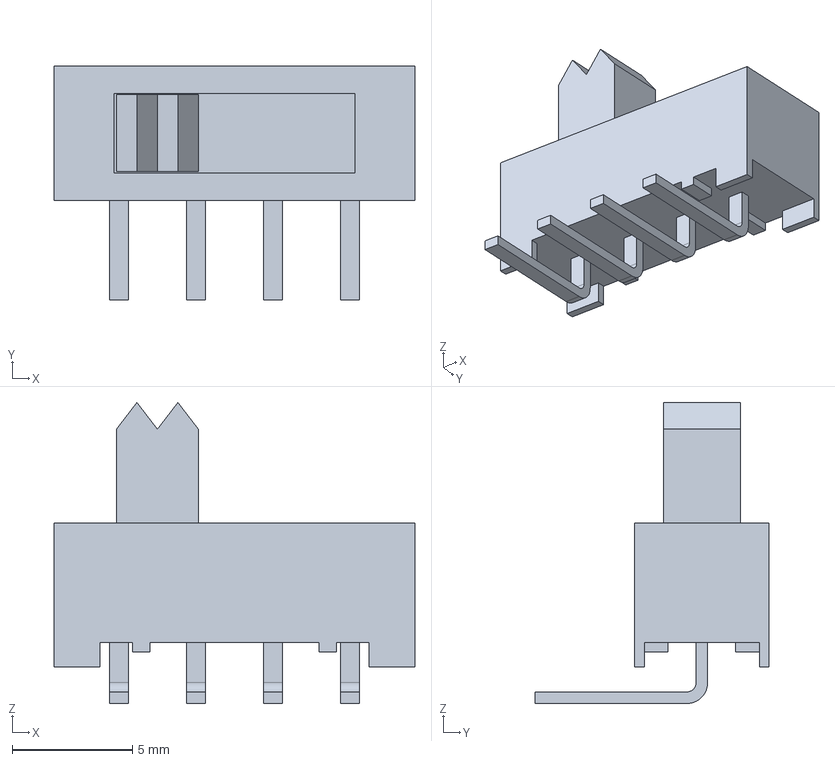
[picture p92: CAD file, 2017-10-03]
5- Circuit Design/3D Models/c-1825118-01-a-3d.stp
15.0 x 9.73 x 12.5 mm
