Quphoria/Electronics-Project/5- Circuit Design/3D Models/DM1AA-SF-PEJ.stp

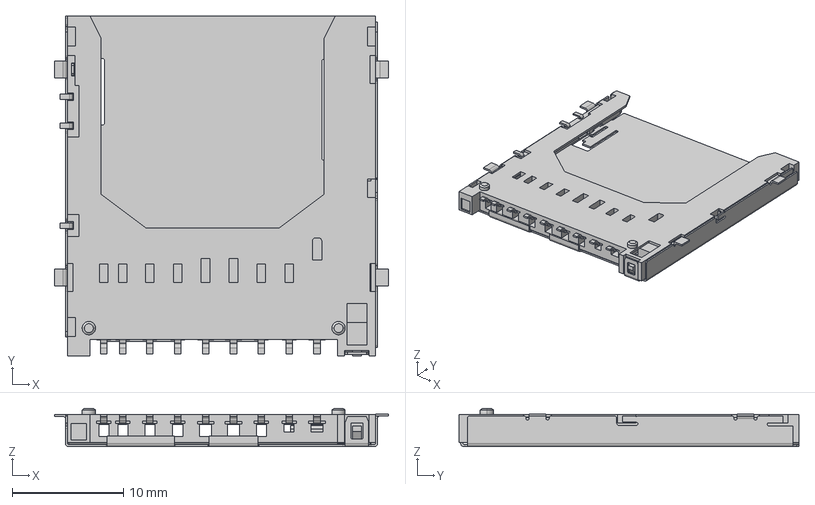
[picture p94: CAD file, 2017-10-03]
5- Circuit Design/3D Models/DM1AA-SF-PEJ.stp
30.0 x 30.5 x 3.45 mm
