Quphoria/Electronics-Project/4- 2D Exports/10MM MDF CUT.dxf

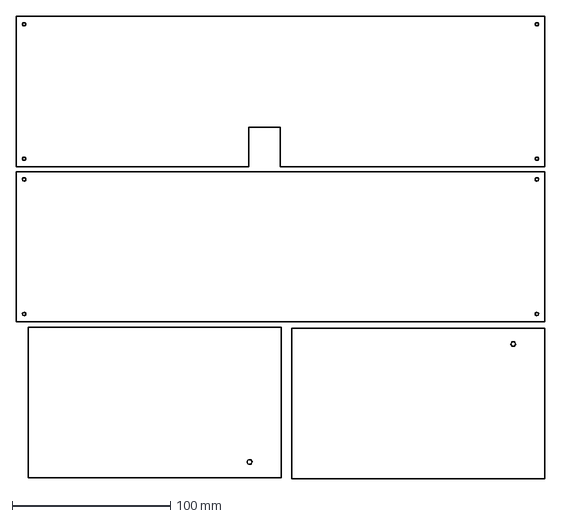
[picture p95: CAD file, 2017-11-06]
4- 2D Exports/10MM MDF CUT.dxf
334.0 x 292.0 mm
