Quphoria/Electronics-Project/4- 2D Exports/Top Cover.dxf

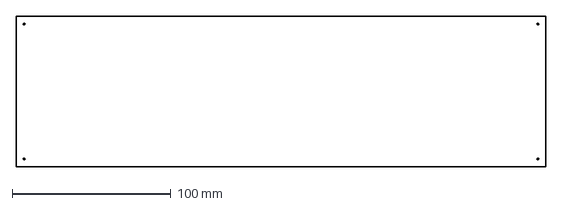
[picture p96: CAD file, 2017-11-06]
4- 2D Exports/Top Cover.dxf
334.0 x 95.0 mm
