Quphoria/Electronics-Project/4- 2D Exports/Bottom Power Supply Holder.dxf

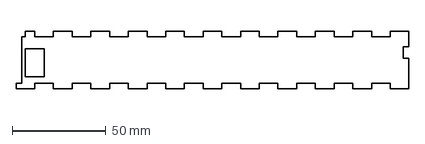
[picture p97: CAD file, 2017-11-06]
4- 2D Exports/Bottom Power Supply Holder.dxf
210.0 x 31.0 mm
