Quphoria/Electronics-Project/4- 2D Exports/Rear LED Cover Panel.dxf

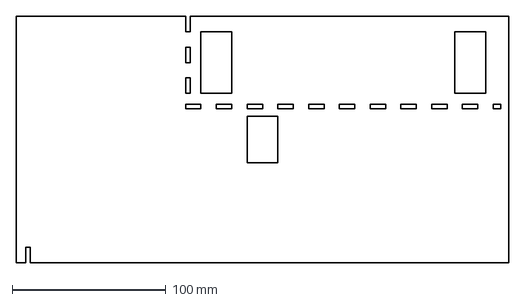
[picture p98: CAD file, 2017-10-30]
4- 2D Exports/Rear LED Cover Panel.dxf
320.0 x 160.0 mm
