Quphoria/Electronics-Project/4- 2D Exports/Front LED Cover Panel.dxf

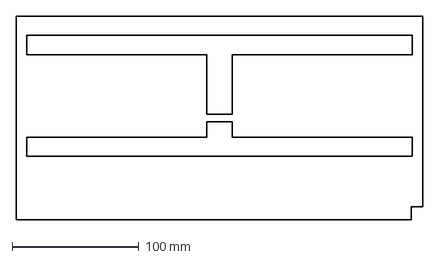
[picture p99: CAD file, 2017-10-04]
4- 2D Exports/Front LED Cover Panel.dxf
320.0 x 160.0 mm
