Quphoria/Electronics-Project/4- 2D Exports/Rear Back Panel.dxf

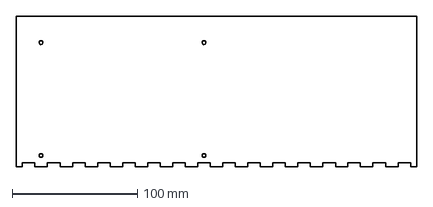
[picture p100: CAD file, 2017-10-03]
4- 2D Exports/Rear Back Panel.dxf
320.0 x 120.0 mm
