Quphoria/Electronics-Project/4- 2D Exports/Rear Stand Cover.dxf

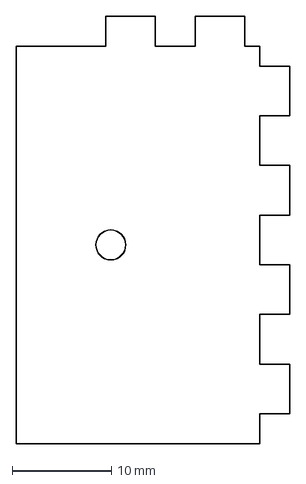
[picture p101: CAD file, 2017-10-03]
4- 2D Exports/Rear Stand Cover.dxf
27.5 x 43.0 mm
