Quphoria/Electronics-Project/4- 2D Exports/Side Power Supply Holder.dxf

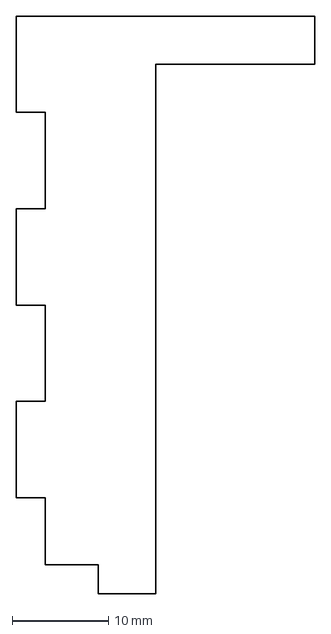
[picture p102: CAD file, 2017-10-03]
4- 2D Exports/Side Power Supply Holder.dxf
31.0 x 60.0 mm
