Quphoria/Electronics-Project/4- 2D Exports/Rear Stand.dxf

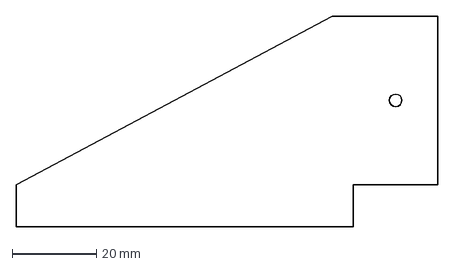
[picture p103: CAD file, 2017-10-03]
4- 2D Exports/Rear Stand.dxf
100.0 x 50.0 mm
