Quphoria/Electronics-Project/4- 2D Exports/Rear PCB IO Panel.dxf

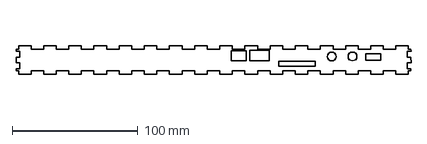
[picture p104: CAD file, 2017-10-03]
4- 2D Exports/Rear PCB IO Panel.dxf
314.0 x 23.0 mm
