Quphoria/Electronics-Project/4- 2D Exports/Left Side Cover.dxf

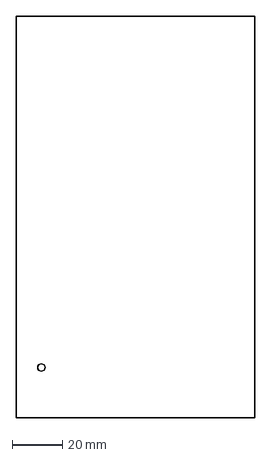
[picture p106: CAD file, 2017-10-03]
4- 2D Exports/Left Side Cover.dxf
95.0 x 160.0 mm
