Quphoria/Electronics-Project/4- 2D Exports/Rear IO Panel.dxf

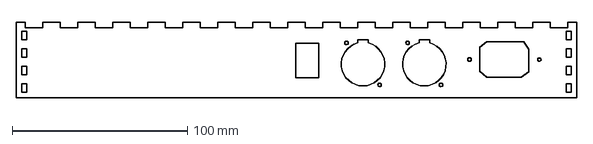
[picture p107: CAD file, 2017-10-03]
4- 2D Exports/Rear IO Panel.dxf
320.0 x 43.0 mm
