Quphoria/Electronics-Project/4- 2D Exports/Screen Protector.dxf

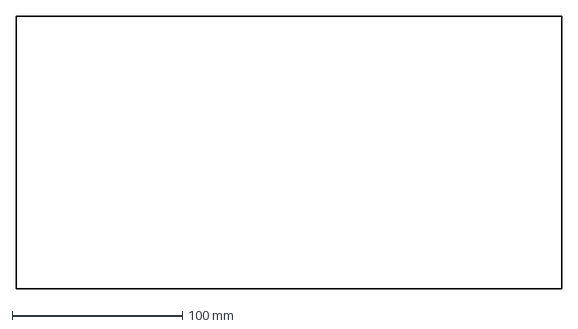
[picture p108: CAD file, 2017-10-03]
4- 2D Exports/Screen Protector.dxf
320.0 x 160.0 mm
