Quphoria/Electronics-Project/(list of files, cad)

Other CAD files:
2- 3D Modelling/Previous Designs/design.dwg
5- Circuit Design/3D Models/OS102011MA1QN1.stp
