Quphoria/Electronics-Project/1- Survey/Survey Results_V2.0.xlsx

Sheet: Multiple Choice
What is your age?
Under 10 | 1
10-17 | 50
18-24 | 3
25-34 | 4
35-54 | 8
55+ | 7
What is your gender?
Male | 34
Female | 39
Which of the following would describe your familiarity with audio spectrum analysers
I have not heard of this product | 50
I have heard of this product | 19
I have researched into this type of product | 2
I have tested a product similar to this | 1
I regularly use a product like this | 1
If you already own, or regularly use this product, then pleast state how long for.
Less than 1 month | 0
1 - 6 months | 1
6 months to 1 year | 0
1 - 2 years | 1
Over 2 years | 3
N/A | 68
How often would you use this type of product?
Daily | 3
At least once a week | 8
Several times a month | 2
Every 2 - 6 months | 3
Once a year | 4
N/A | 53
Which one would you most likely buy?
1 | 25
2 | 17
3 | 15
4 | 10
5 | 6

Sheet: Open ended
What do you like most about this product?
Size | 15
Multiple Colours | 28
Digital | 1
Price | 20
Finished Product | 12
Resolution | 9
Attractive | 18
Simplicity | 5
What don't you like about this product?
Expensive | 20
No Remote Control | 1
Sharp Edges | 2
Too strong colours | 1
Too big | 3
Could break easily | 2
Too simple/Boring | 4
Too small | 5
Not enough colours | 6
Not enough resolution | 2
If I was to make one what would you want it to have?
Cheap | 5
Multi Coloured | 36
Look nice | 8
Smooth Case | 6
Easy to Use | 6
Expensive Hardware | 1
Large | 4
Great Quality | 5
Portable | 3
Wooden Case | 10
Multiple Audio Inputs | 13
What would you expect to have to pay for this product?
 | £25.00
 | £15.00
 | £49.00
 | £22.50
 | £17.50
 | £20.00
 | £35.00
 | £19.00
 | £99.00
 | £20.00
 | £20.00
 | £30.00
 | £30.00
 | £45.00
 | £40.00
 | £35.00
 | £30.00
 | £11.30
 | £45.99
 | £7.50
 | £40.00
 | £20.00
 | £50.00
 | £75.00
 | £27.50
 | £23.00
 | £19.99
 | £15.00
 | £30.00
 | £50.00
 | £30.00
 | £29.99
 | £25.00
 | £60.00
 | £80.00
 | £50.00
 | £35.00
 | £45.99
 | £50.00
 | £40.00
 | £10.00
 | £15.00
 | £50.00
 | £39.99
 | £15.00
 | £15.99
 | £30.00
 | £12.00
 | £17.00
 | £15.00
 | £40.00
 | £16.00
 | £10.00
 | £60.00
 | £50.00
 | £100.00
Average | £34.09
