Quphoria/Electronics-Project/1- Survey/Survey Results_V1.0.xlsx

Sheet: Multiple Choice
What is your age?
Under 10 | 0
10-17 | 28
18-24 | 2
25-34 | 1
35-54 | 5
55+ | 3
What is your gender?
Male | 18
Female | 21
Which of the following would describe your familiarity with audio spectrum analysers
I have not heard of this product | 27
I have heard of this product | 11
I have researched into this type of product | 0
I have tested a product similar to this | 1
I regularly use a product like this | 0
If you already own, or regularly use this product, then please state how long for.
Less than 1 month | 0
1 - 6 months | 0
6 months to 1 year | 0
1 - 2 years | 0
Over 2 years | 1
N/A | 38
How often would you use this type of product?
Daily | 2
At lease once a week | 4
Several times a month | 0
Every 2 - 6 months | 1
Once a year | 2
N/A | 30
Which one would you most likely buy?
1 | 13
2 | 9
3 | 7
4 | 7
5 | 3

Sheet: Open ended
What do you like most about this product?
Size | 10
Multiple Colours | 16
Digital | 1
Price | 11
Finished Product | 10
Resolution | 5
Looks Cool | 9
Simplicity | 3
What don't you like about this product?
Expensive | 10
No Remote Control | 1
Sharp Edges | 1
Too strong colours | 1
Too big | 3
Could break easily | 2
Too simple/Boring | 3
Too small | 1
Not enough colours | 2
Not enough resolution | 1
If I was to make one what would you want it to have?
Cheap | 5
Multi Coloured | 19
Look nice | 4
Smooth Case | 1
Easy to Use | 3
Expensive Hardware | 1
Large | 2
Great Quality | 3
Portable | 2
What would you expect to have to pay for this product?
 | £25
 | £15
 | £49
 | £22.50
 | £17.5
 | £20
 | £35
 | £19
 | £99
 | £20
 | £20
 | £30
 | £30
 | £45
 | £40
 | £35
 | £30
 | £11.30
 | £45.99
 | £7.50
 | £40
 | £20
 | £50
 | £75
 | £27.50
 | £23
 | £19.99
 | £15
 | £30
Average | £31.63034483
