Quphoria/Electronics-Project/6- Programming/CYCLE Test Program.png

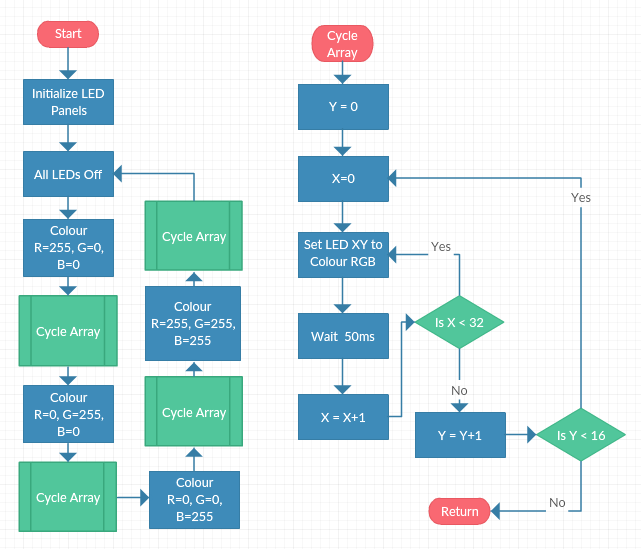
6- Programming/CYCLE Test Program.png
