Quphoria/Electronics-Project/5- Circuit Design/Pictures/Schematic.pdf

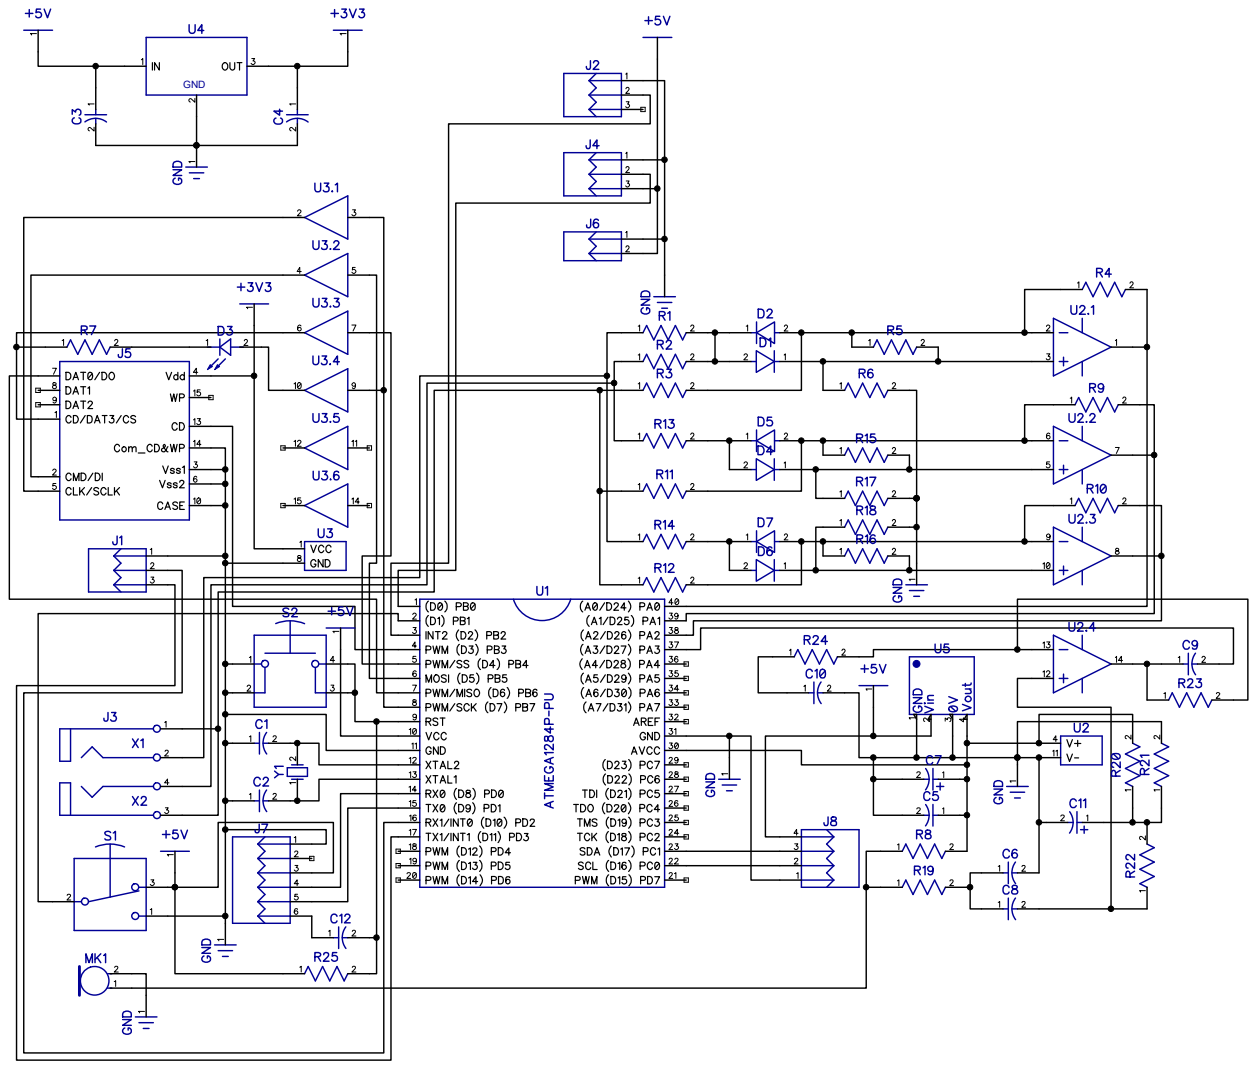
[picture p110: page 1]
GND
