Quphoria/Electronics-Project/4- 2D Exports/Drawings/Back Power Supply Holder.pdf

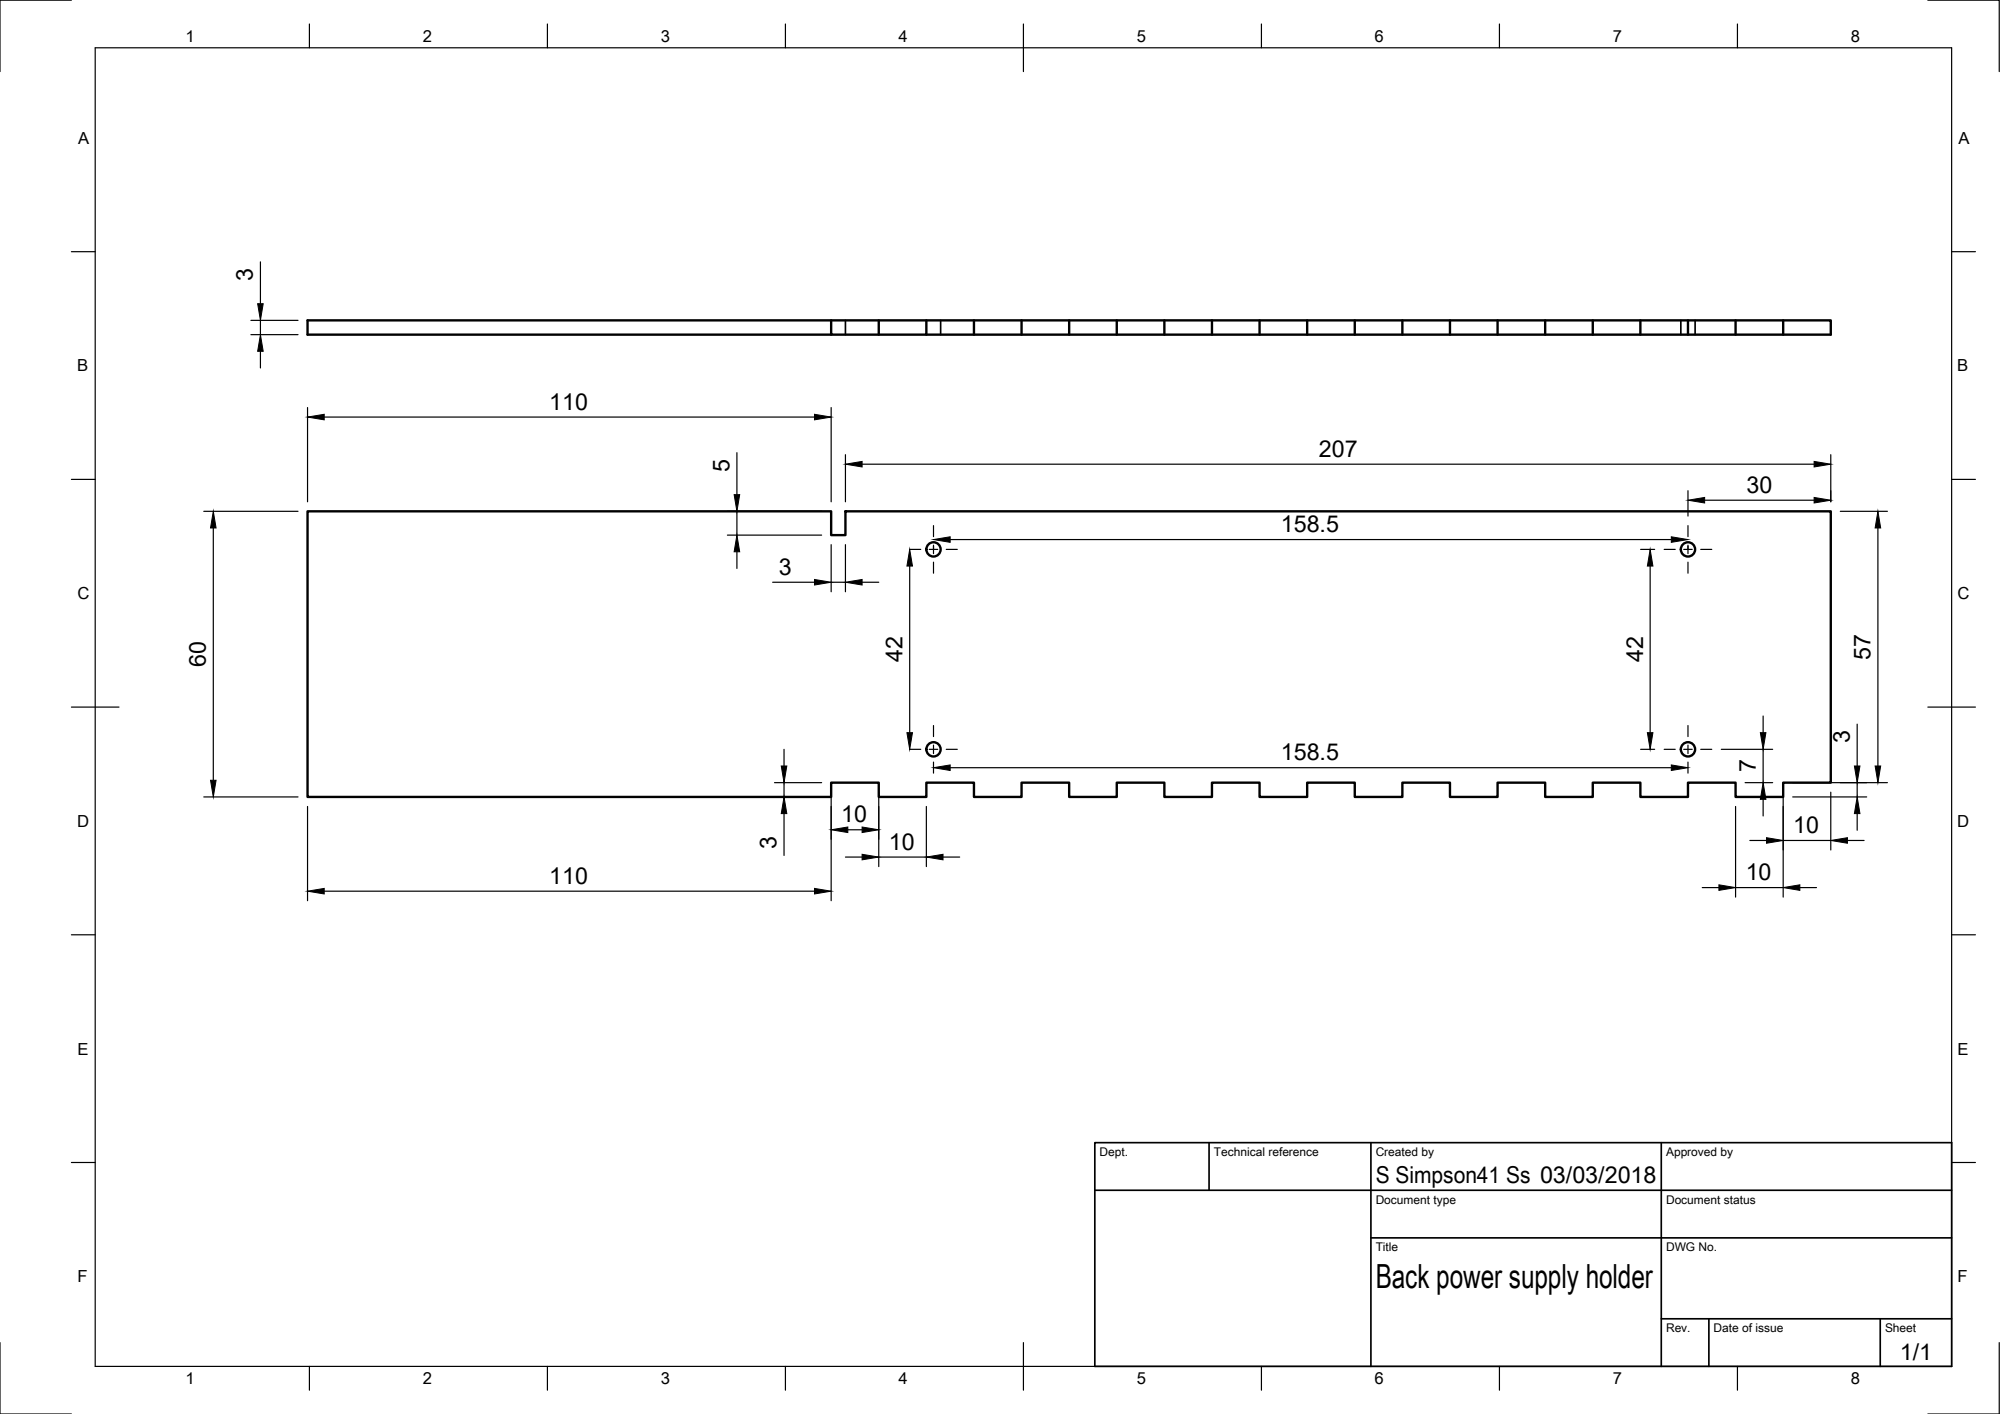
[picture p111: page 1]

Dept. | Technical reference | Created by S Simpson41 Ss 03/03/2018 | Approved by

Document type | Document status

Title Back power supply holder | DWG No.

Rev. | Date of issue | Sheet 1/1
