Quphoria/Electronics-Project/4- 2D Exports/Drawings/Bottom Power Supply Holder.pdf

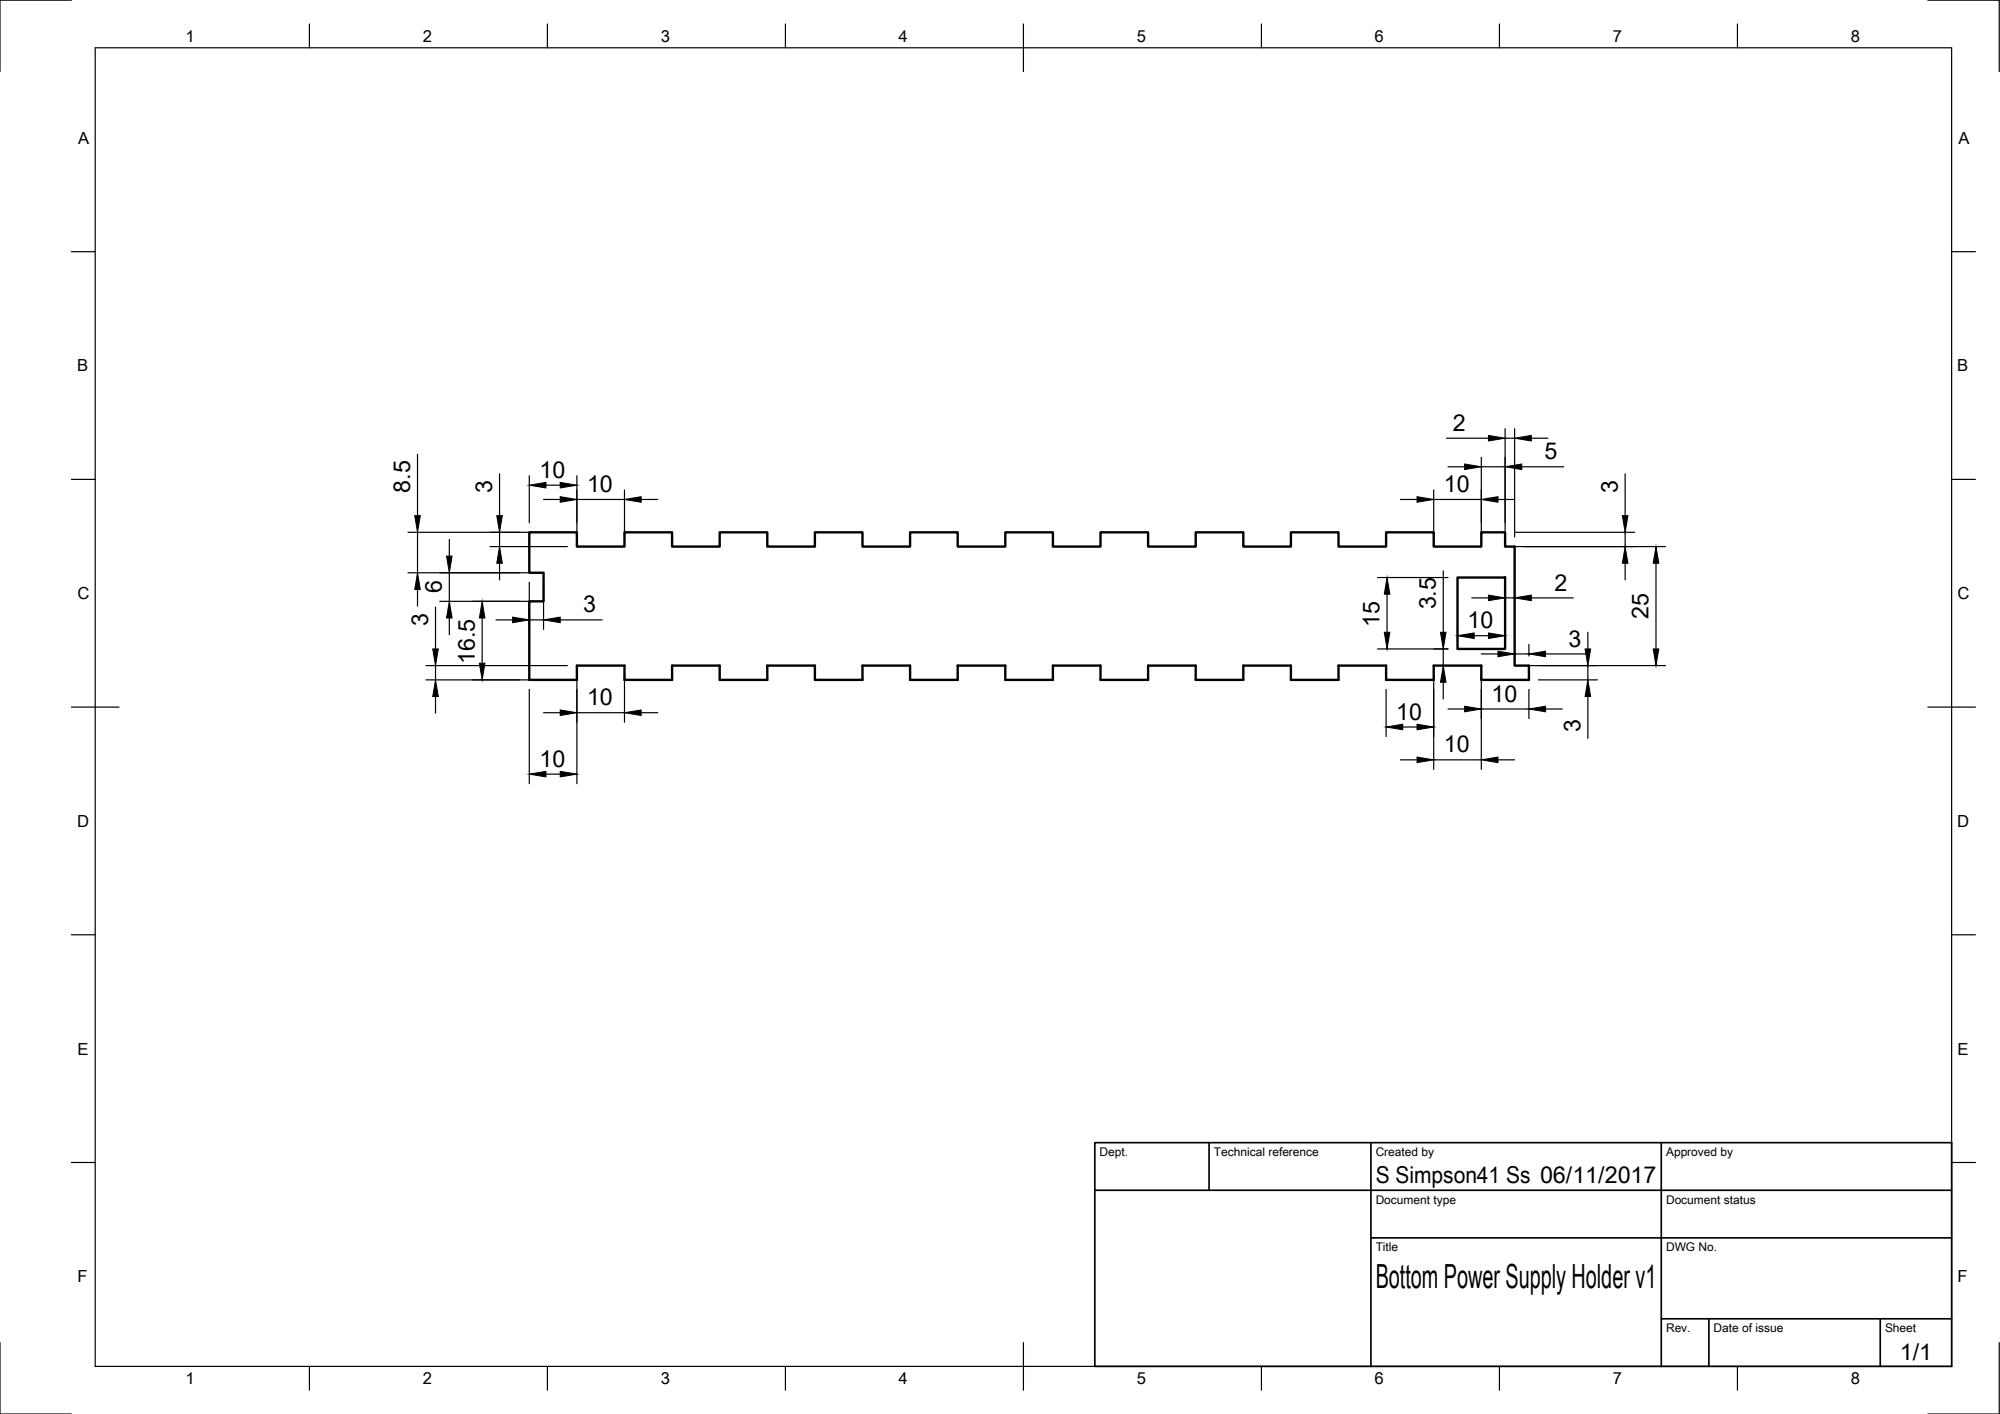
[picture p113: page 1]
S Simpson41 Ss 3.5

Dept. | Technical reference | Created by 06/11/2017 | Approved by

Document type | Document status

Title Bottom Power Supply Holder v1 | DWG No.

Rev. | Date of issue | Sheet 1/1
