Quphoria/Electronics-Project/4- 2D Exports/Drawings/Rear LED Cover Panel.pdf

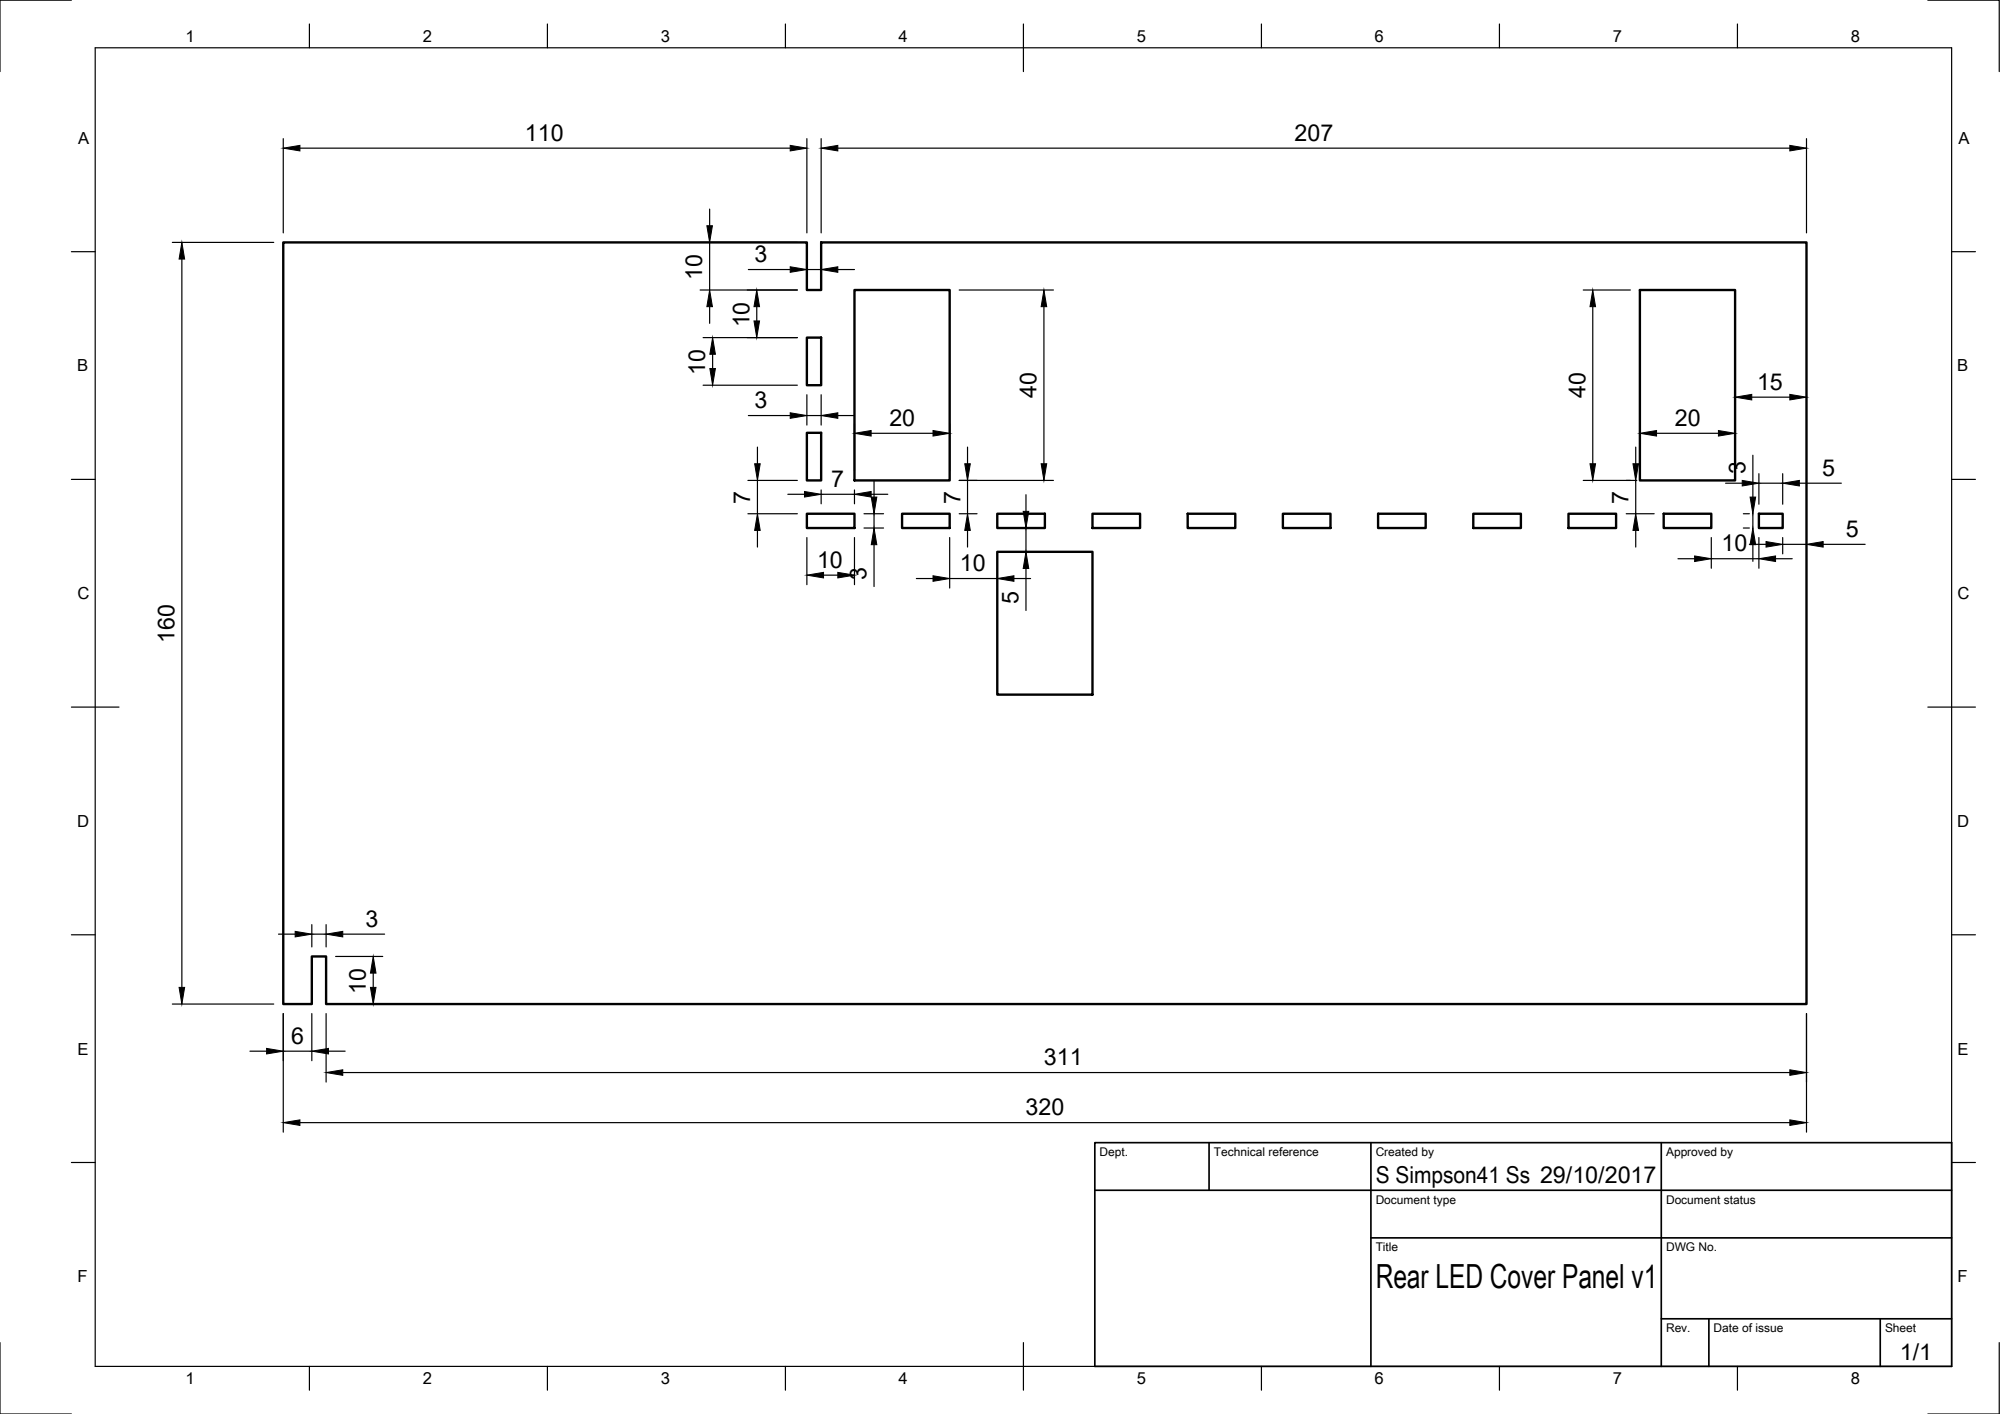
[picture p114: page 1]

Dept. | Technical reference | Created by S Simpson41 Ss 29/10/2017 | Approved by

Document type | Document status

Title Rear LED Cover Panel v1 | DWG No.

Rev. | Date of issue | Sheet 1/1
