Quphoria/Electronics-Project/4- 2D Exports/Drawings/Front LED Cover Panel.pdf

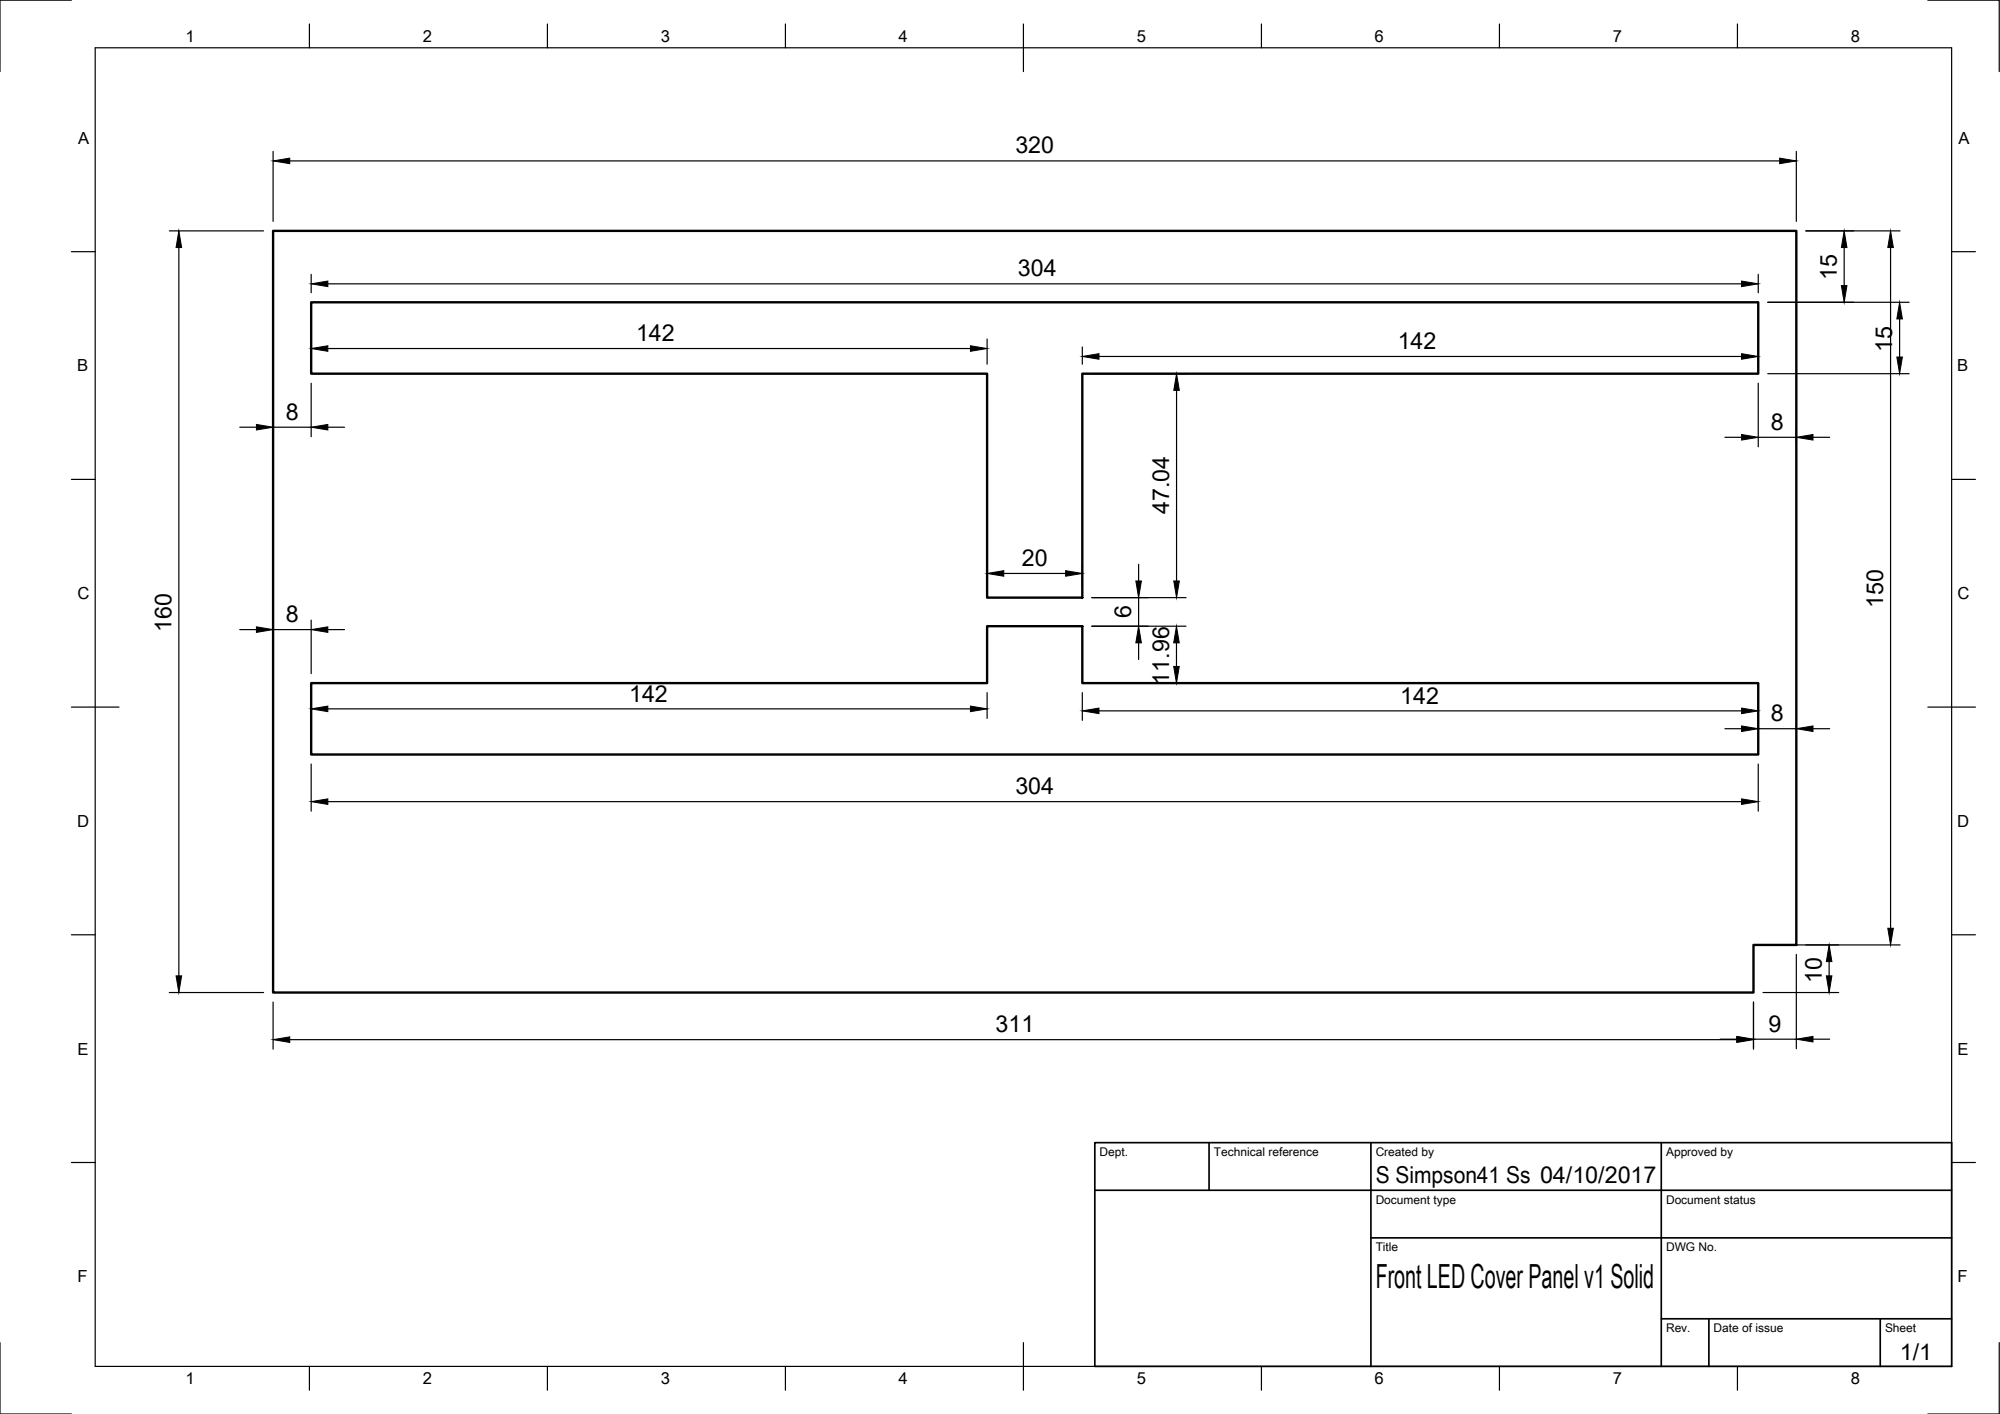
[picture p115: page 1]

Dept. | Technical reference | Created by S Simpson41 Ss 04/10/2017 | Approved by

Document type | Document status

Title Front LED Cover Panel v1 Solid | DWG No.

Rev. | Date of issue | Sheet 1/1
