Quphoria/Electronics-Project/4- 2D Exports/Drawings/Side Power Supply Holder.pdf

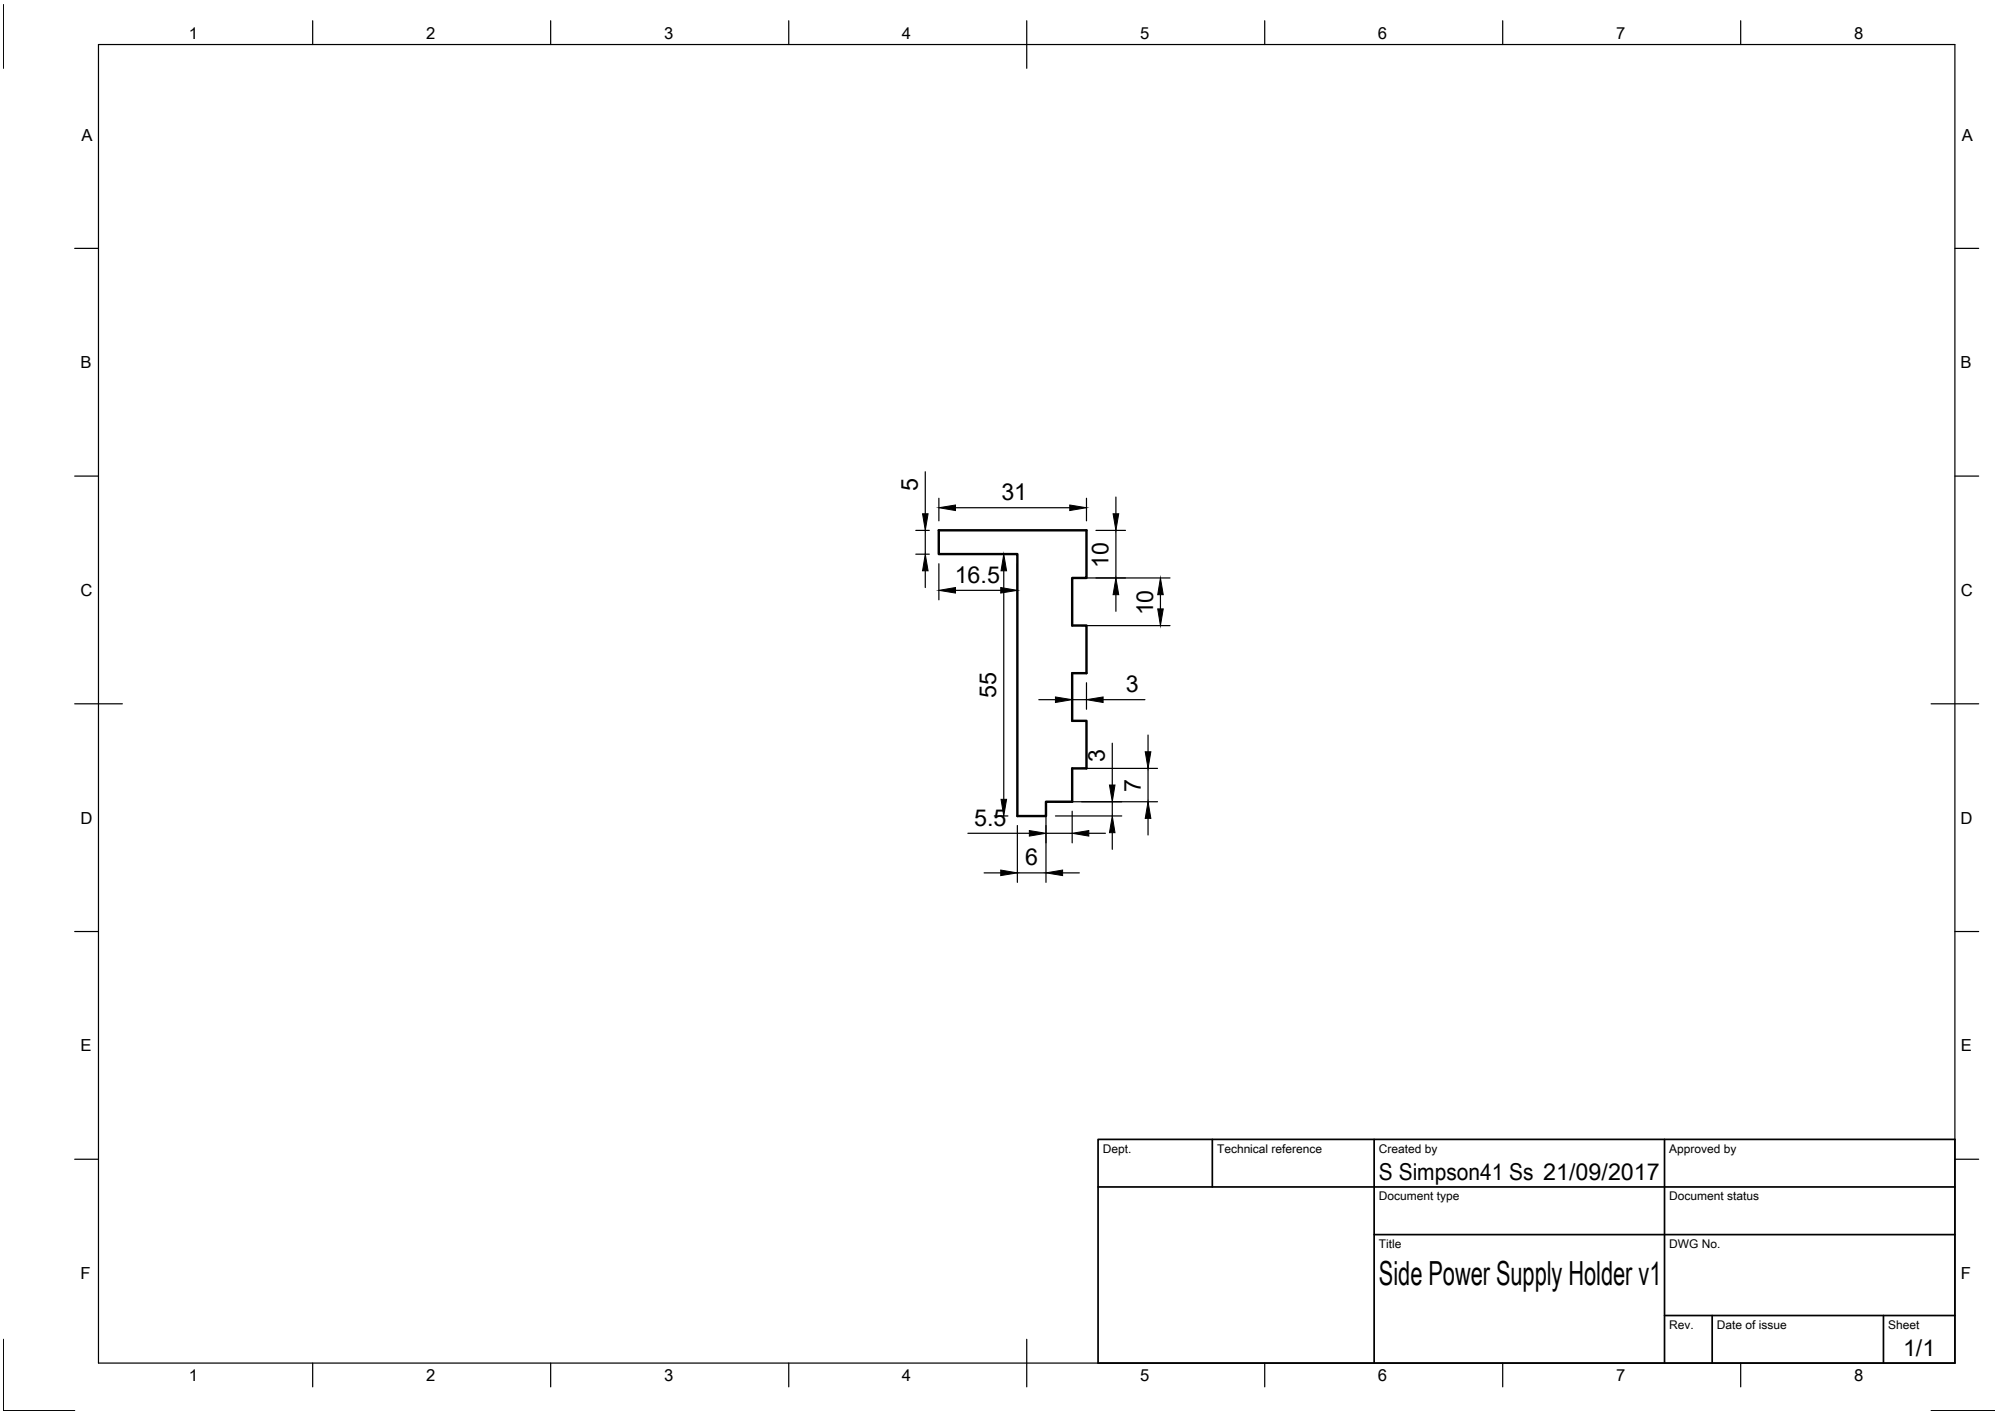
[picture p117: page 1]
S Simpson41 Ss 55

Dept. | Technical reference | Created by 21/09/2017 | Approved by

Document type | Document status

Title Side Power Supply Holder v1 | DWG No.

Rev. | Date of issue | Sheet 1/1
