Quphoria/Electronics-Project/4- 2D Exports/Drawings/Back cover IO.pdf

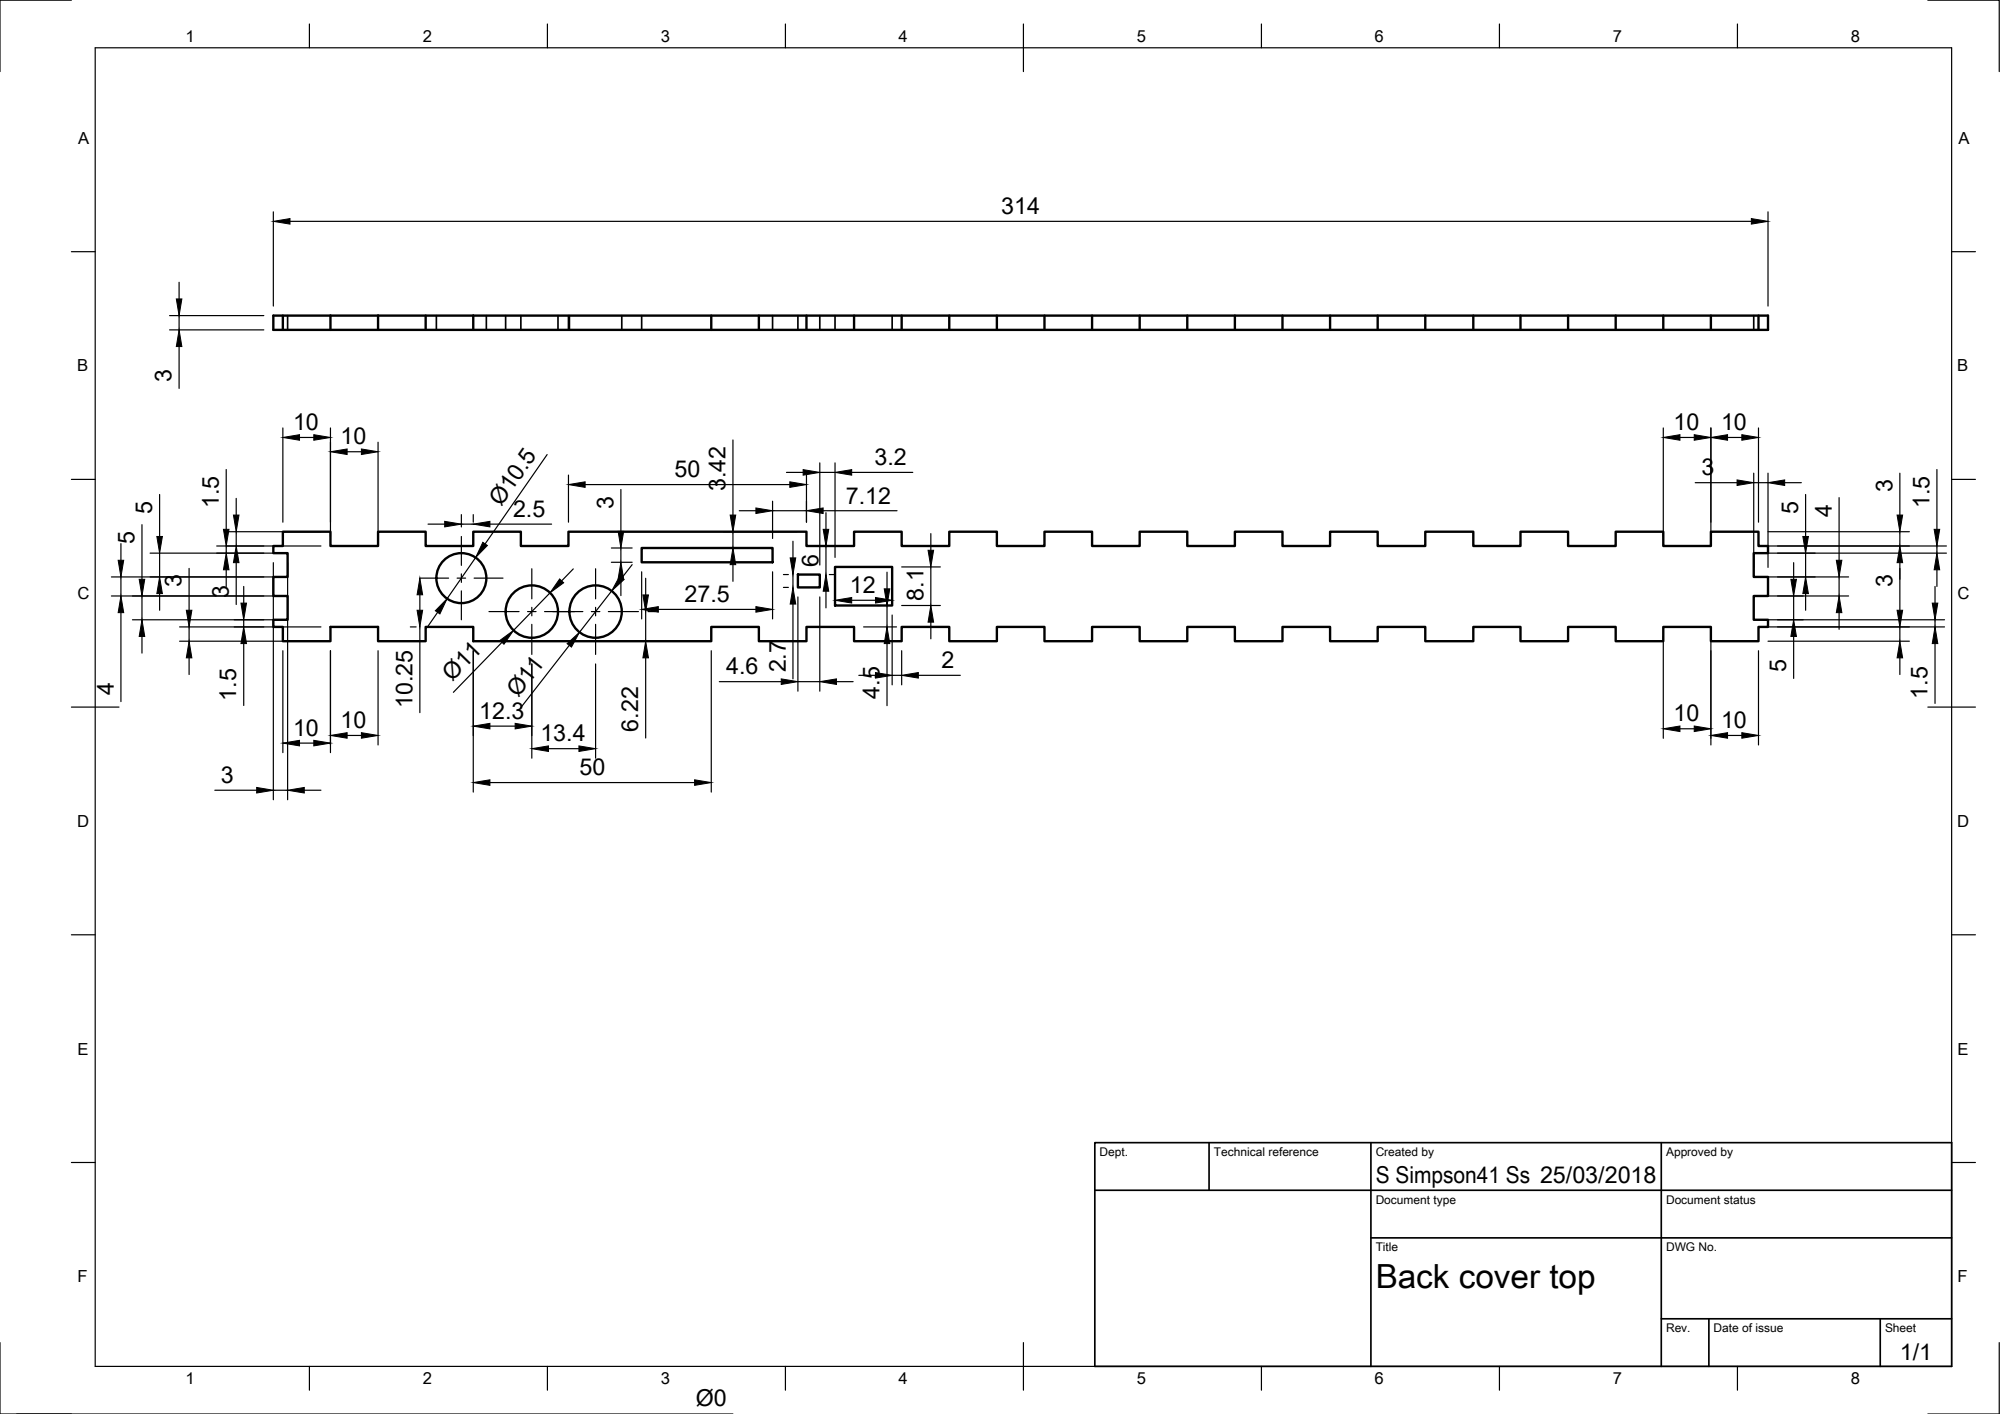
[picture p119: page 1]

Dept. | Technical reference | Created by S Simpson41 Ss 25/03/2018 | Approved by

Document type | Document status

Title Back cover top | DWG No.

Rev. | Date of issue | Sheet 1/1
