Quphoria/Electronics-Project/4- 2D Exports/Drawings/Back cover.pdf

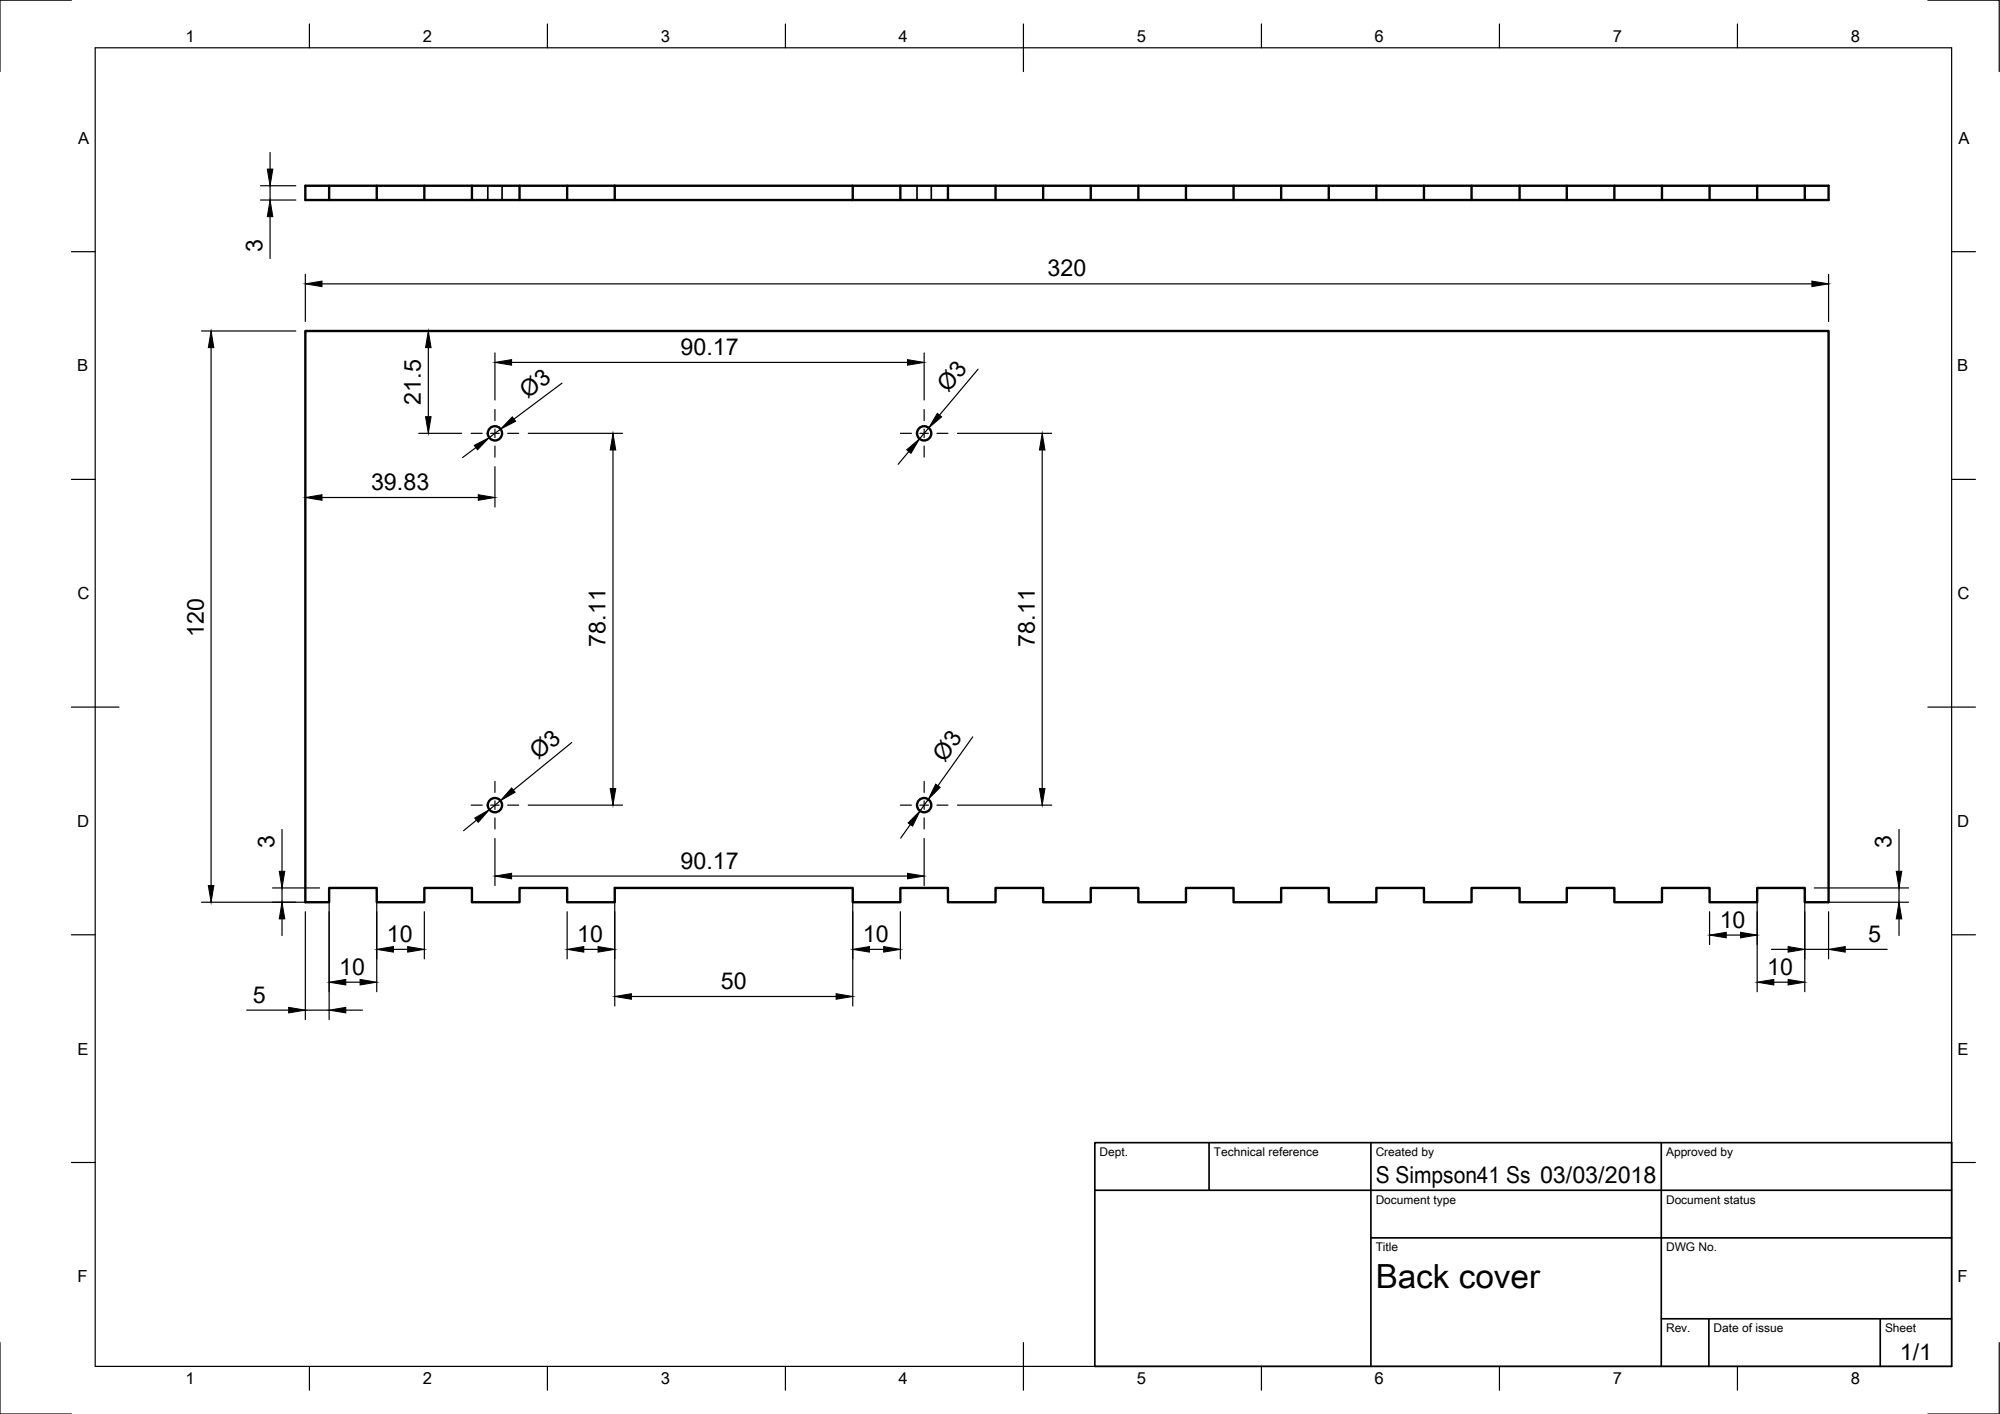
[picture p120: page 1]

Dept. | Technical reference | Created by S Simpson41 Ss 03/03/2018 | Approved by

Document type | Document status

Title Back cover | DWG No.

Rev. | Date of issue | Sheet 1/1
