Quphoria/Electronics-Project/4- 2D Exports/Drawings/Right Side Cover.pdf

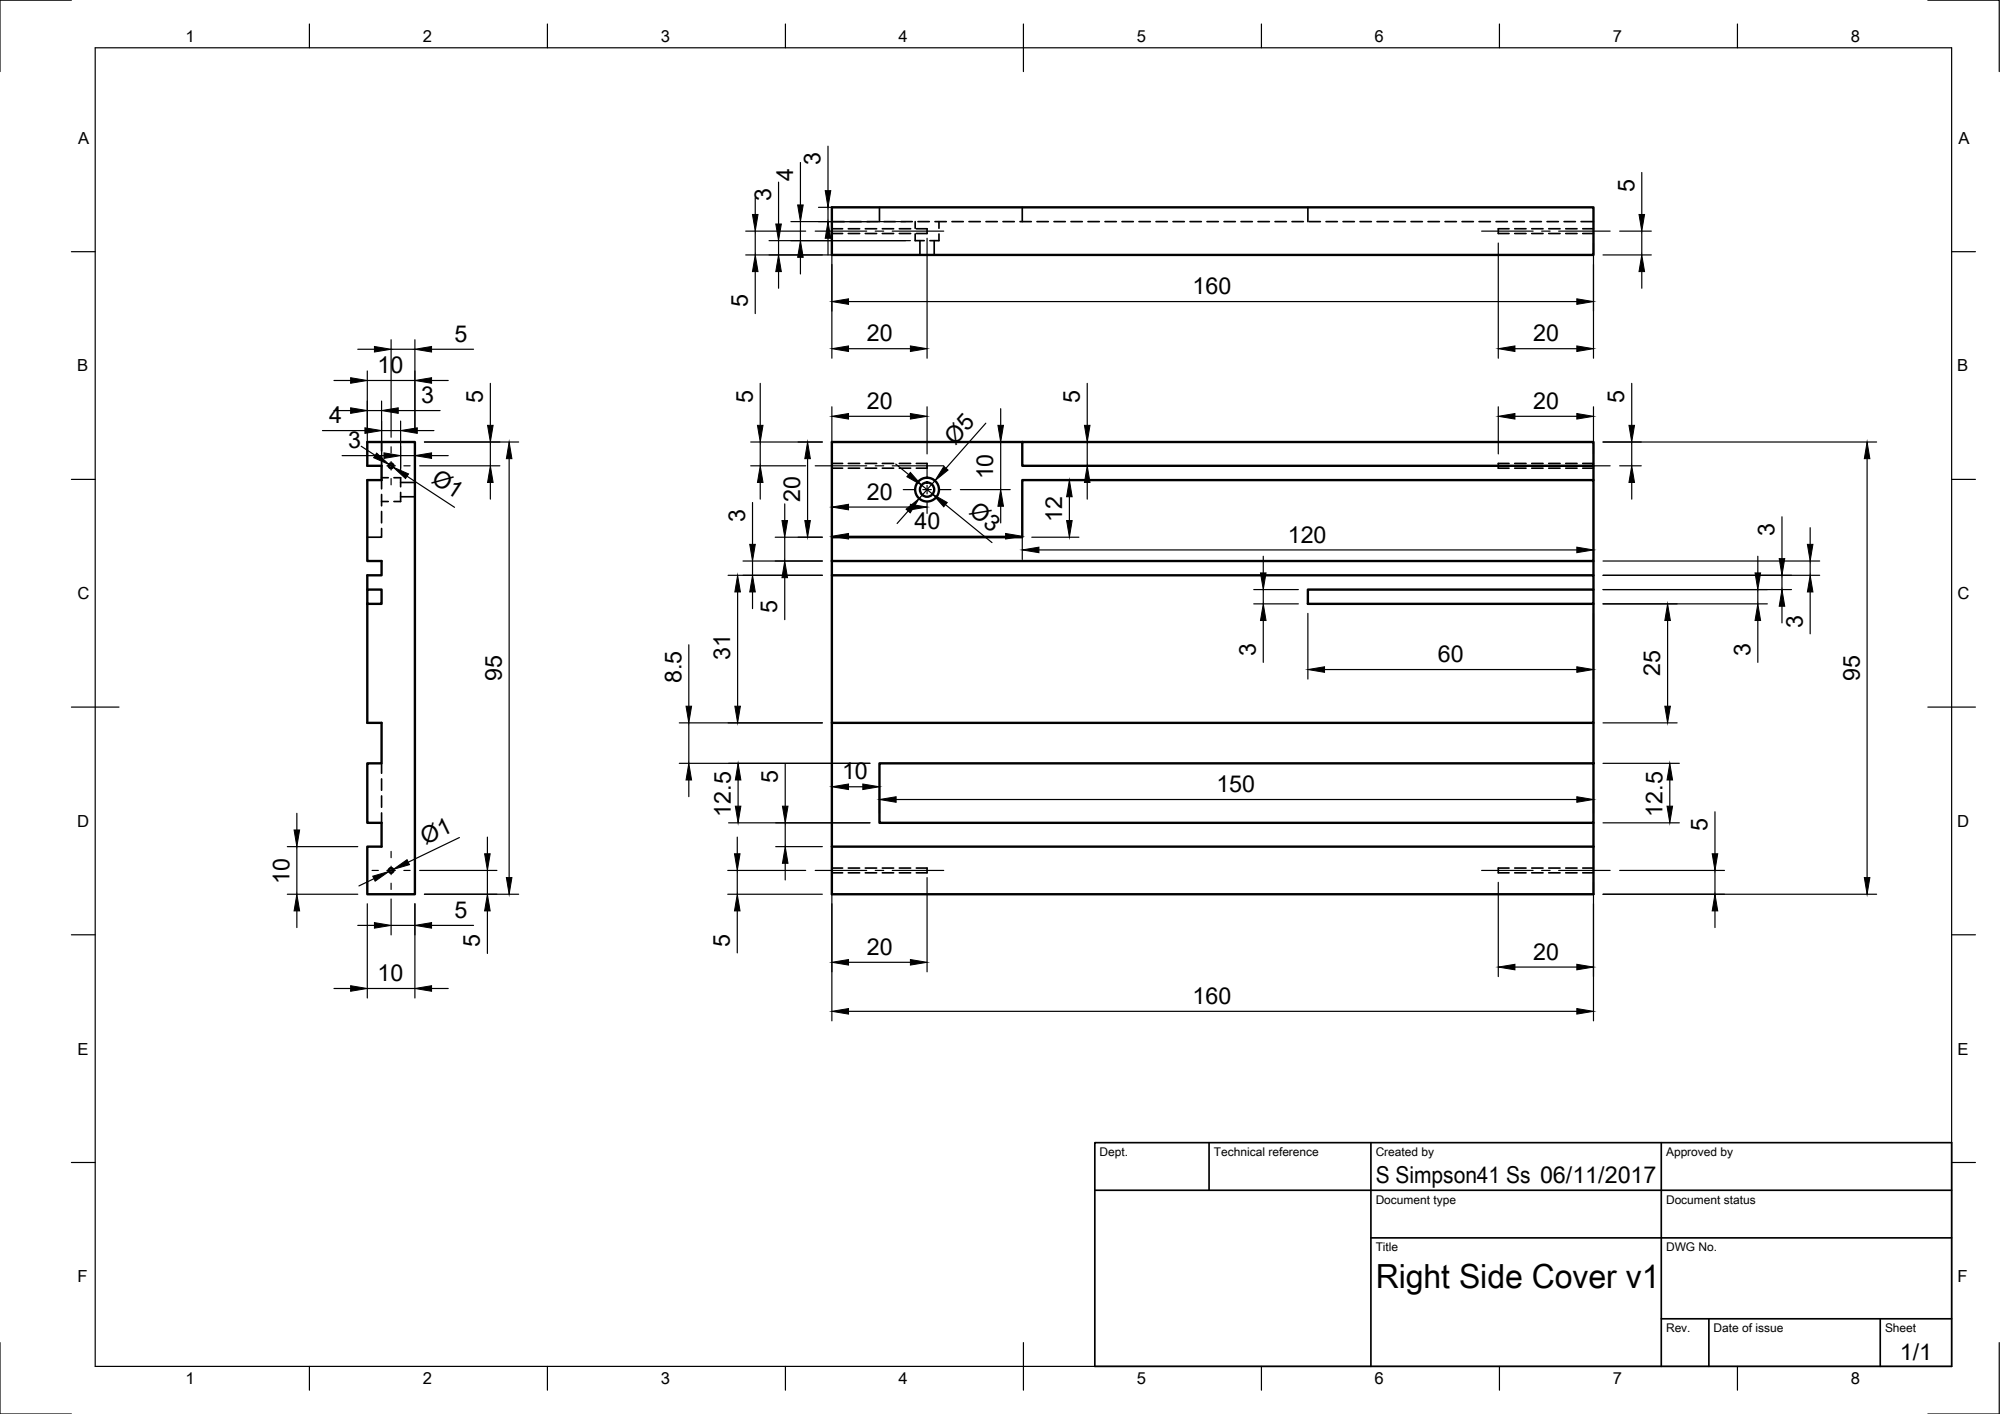
[picture p122: page 1]
S Simpson41 Ss 95

Dept. | Technical reference | Created by 06/11/2017 | Approved by

Document type | Document status

Title Right Side Cover v1 | DWG No.

Rev. | Date of issue | Sheet 1/1
