Quphoria/Electronics-Project/4- 2D Exports/Drawings/Rear Back Panel.pdf

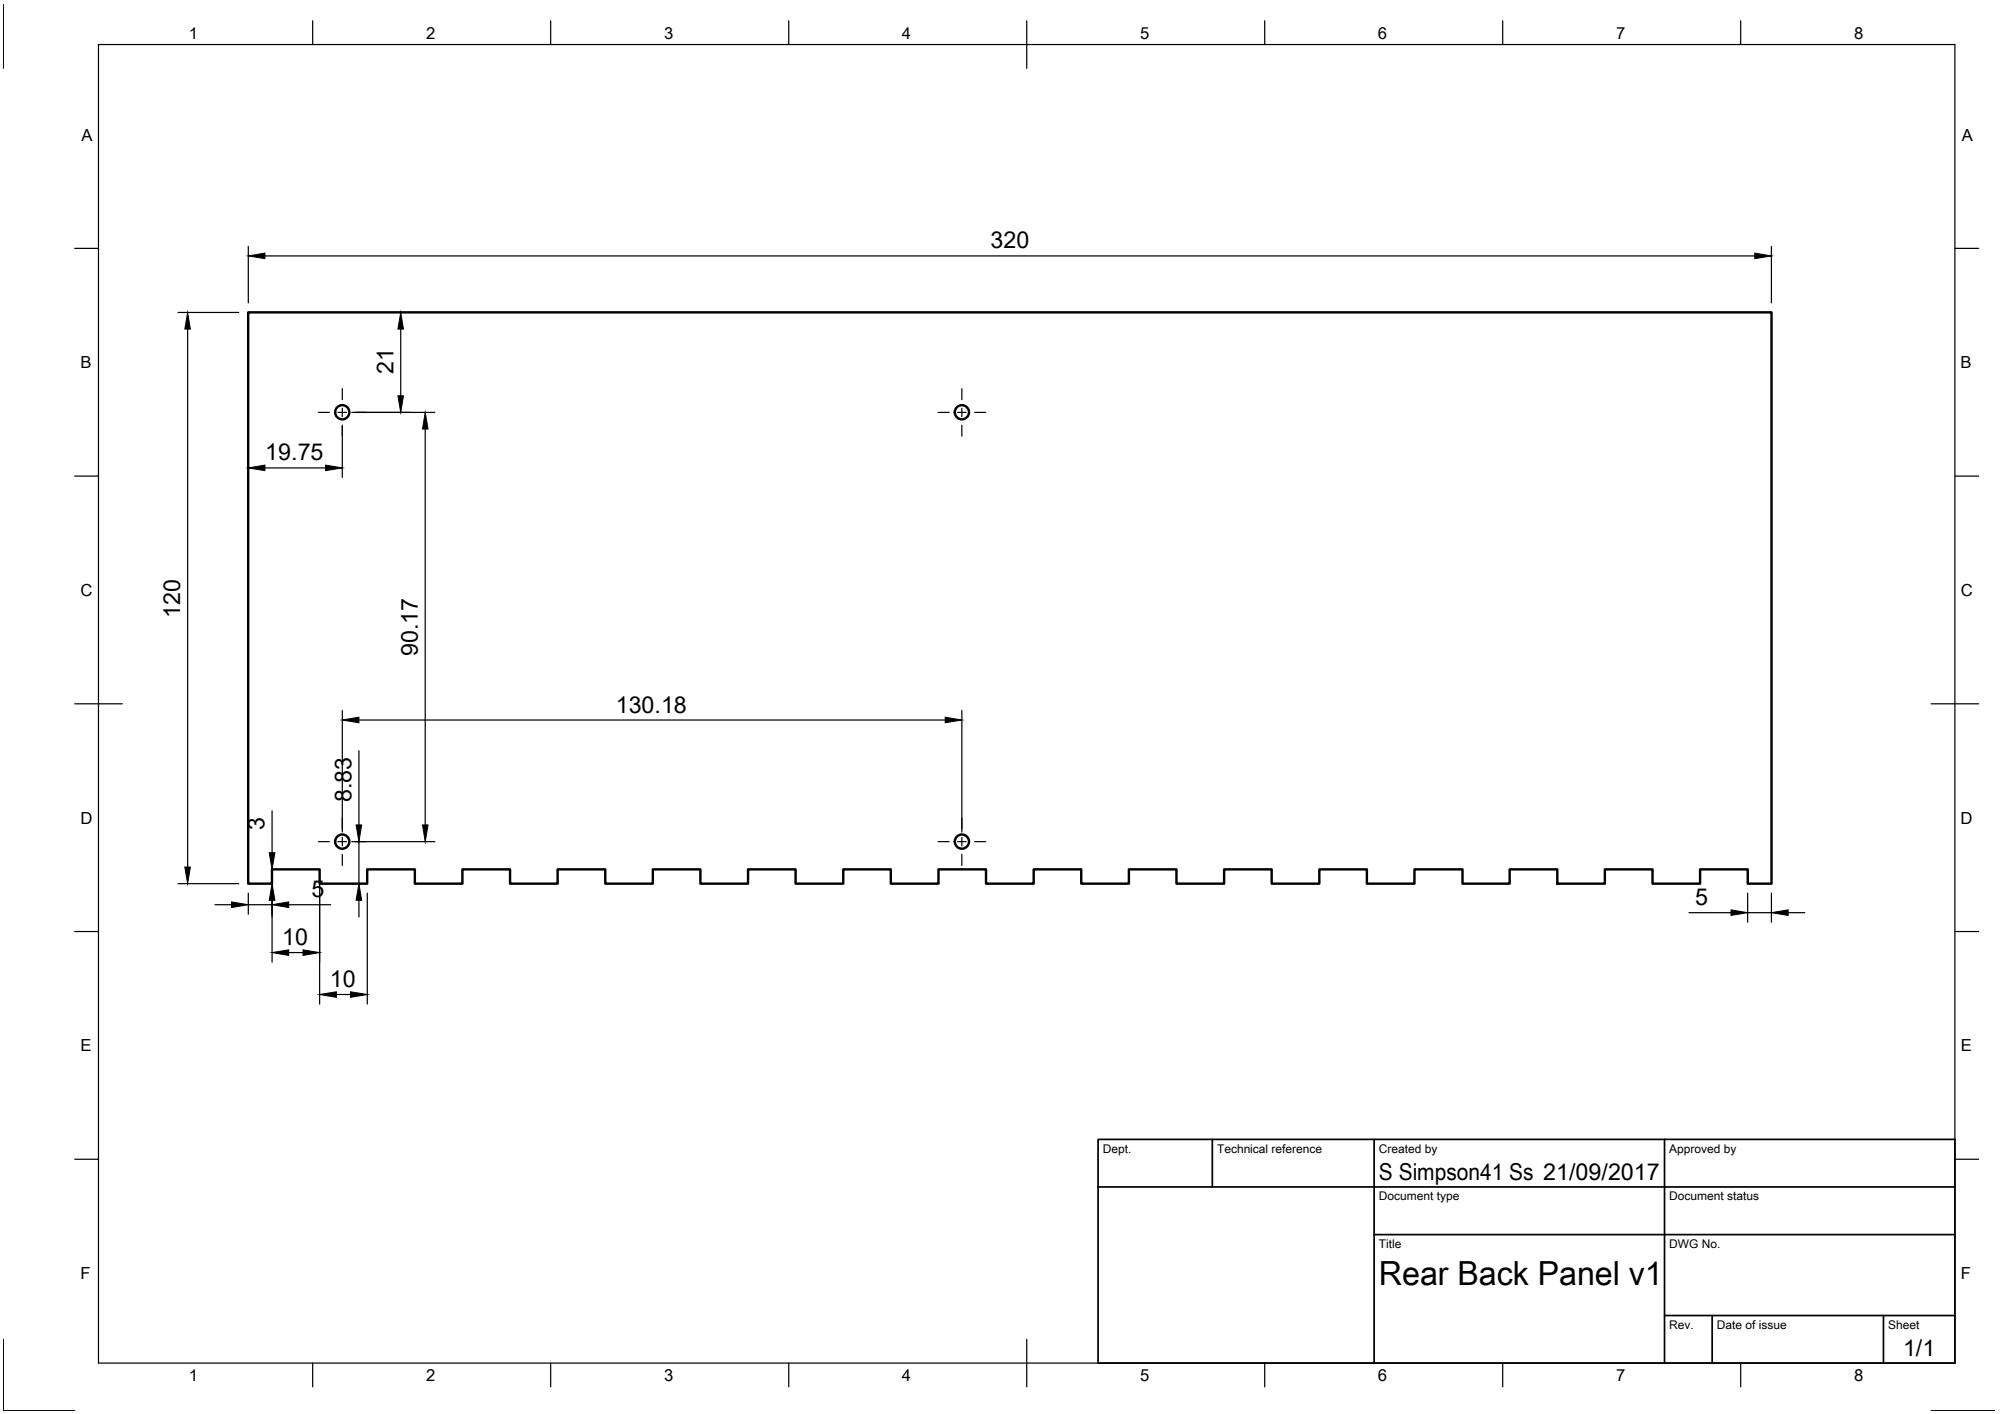
[picture p124: page 1]
S Simpson41 Ss 120

Dept. | Technical reference | Created by 21/09/2017 | Approved by

Document type | Document status

Title Rear Back Panel v1 | DWG No.

Rev. | Date of issue | Sheet 1/1
