Quphoria/Electronics-Project/4- 2D Exports/Drawings/Rear IO Panel.pdf

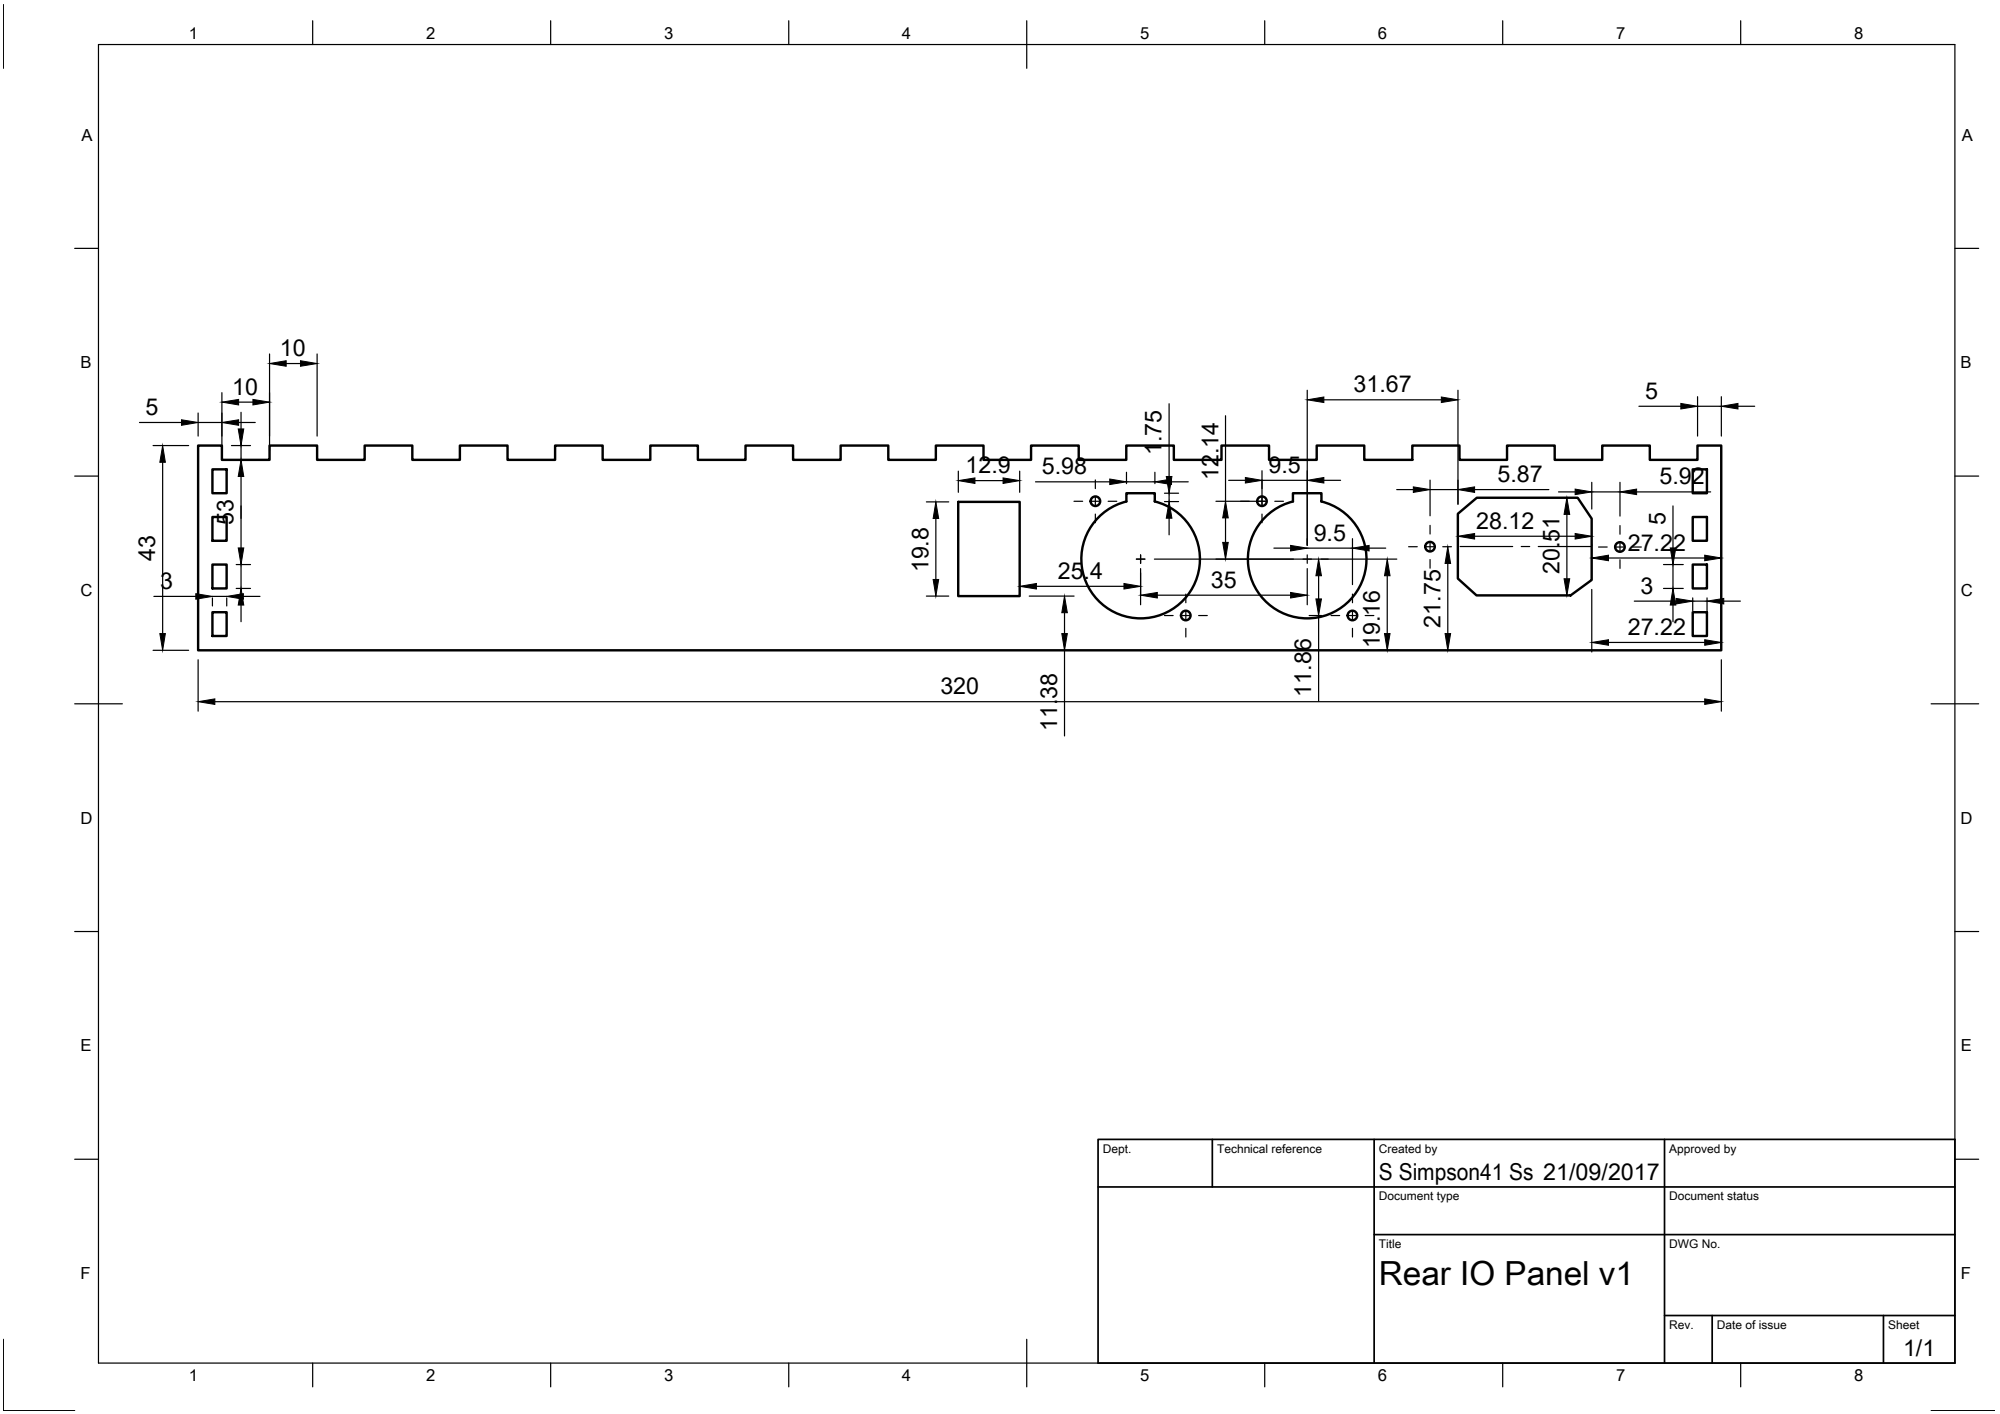
[picture p125: page 1]
S Simpson41 Ss 43

Dept. | Technical reference | Created by 21/09/2017 | Approved by

Document type | Document status

Title Rear IO Panel v1 | DWG No.

Rev. | Date of issue | Sheet 1/1
