Quphoria/Electronics-Project/4- 2D Exports/Drawings/Rear Stand.pdf

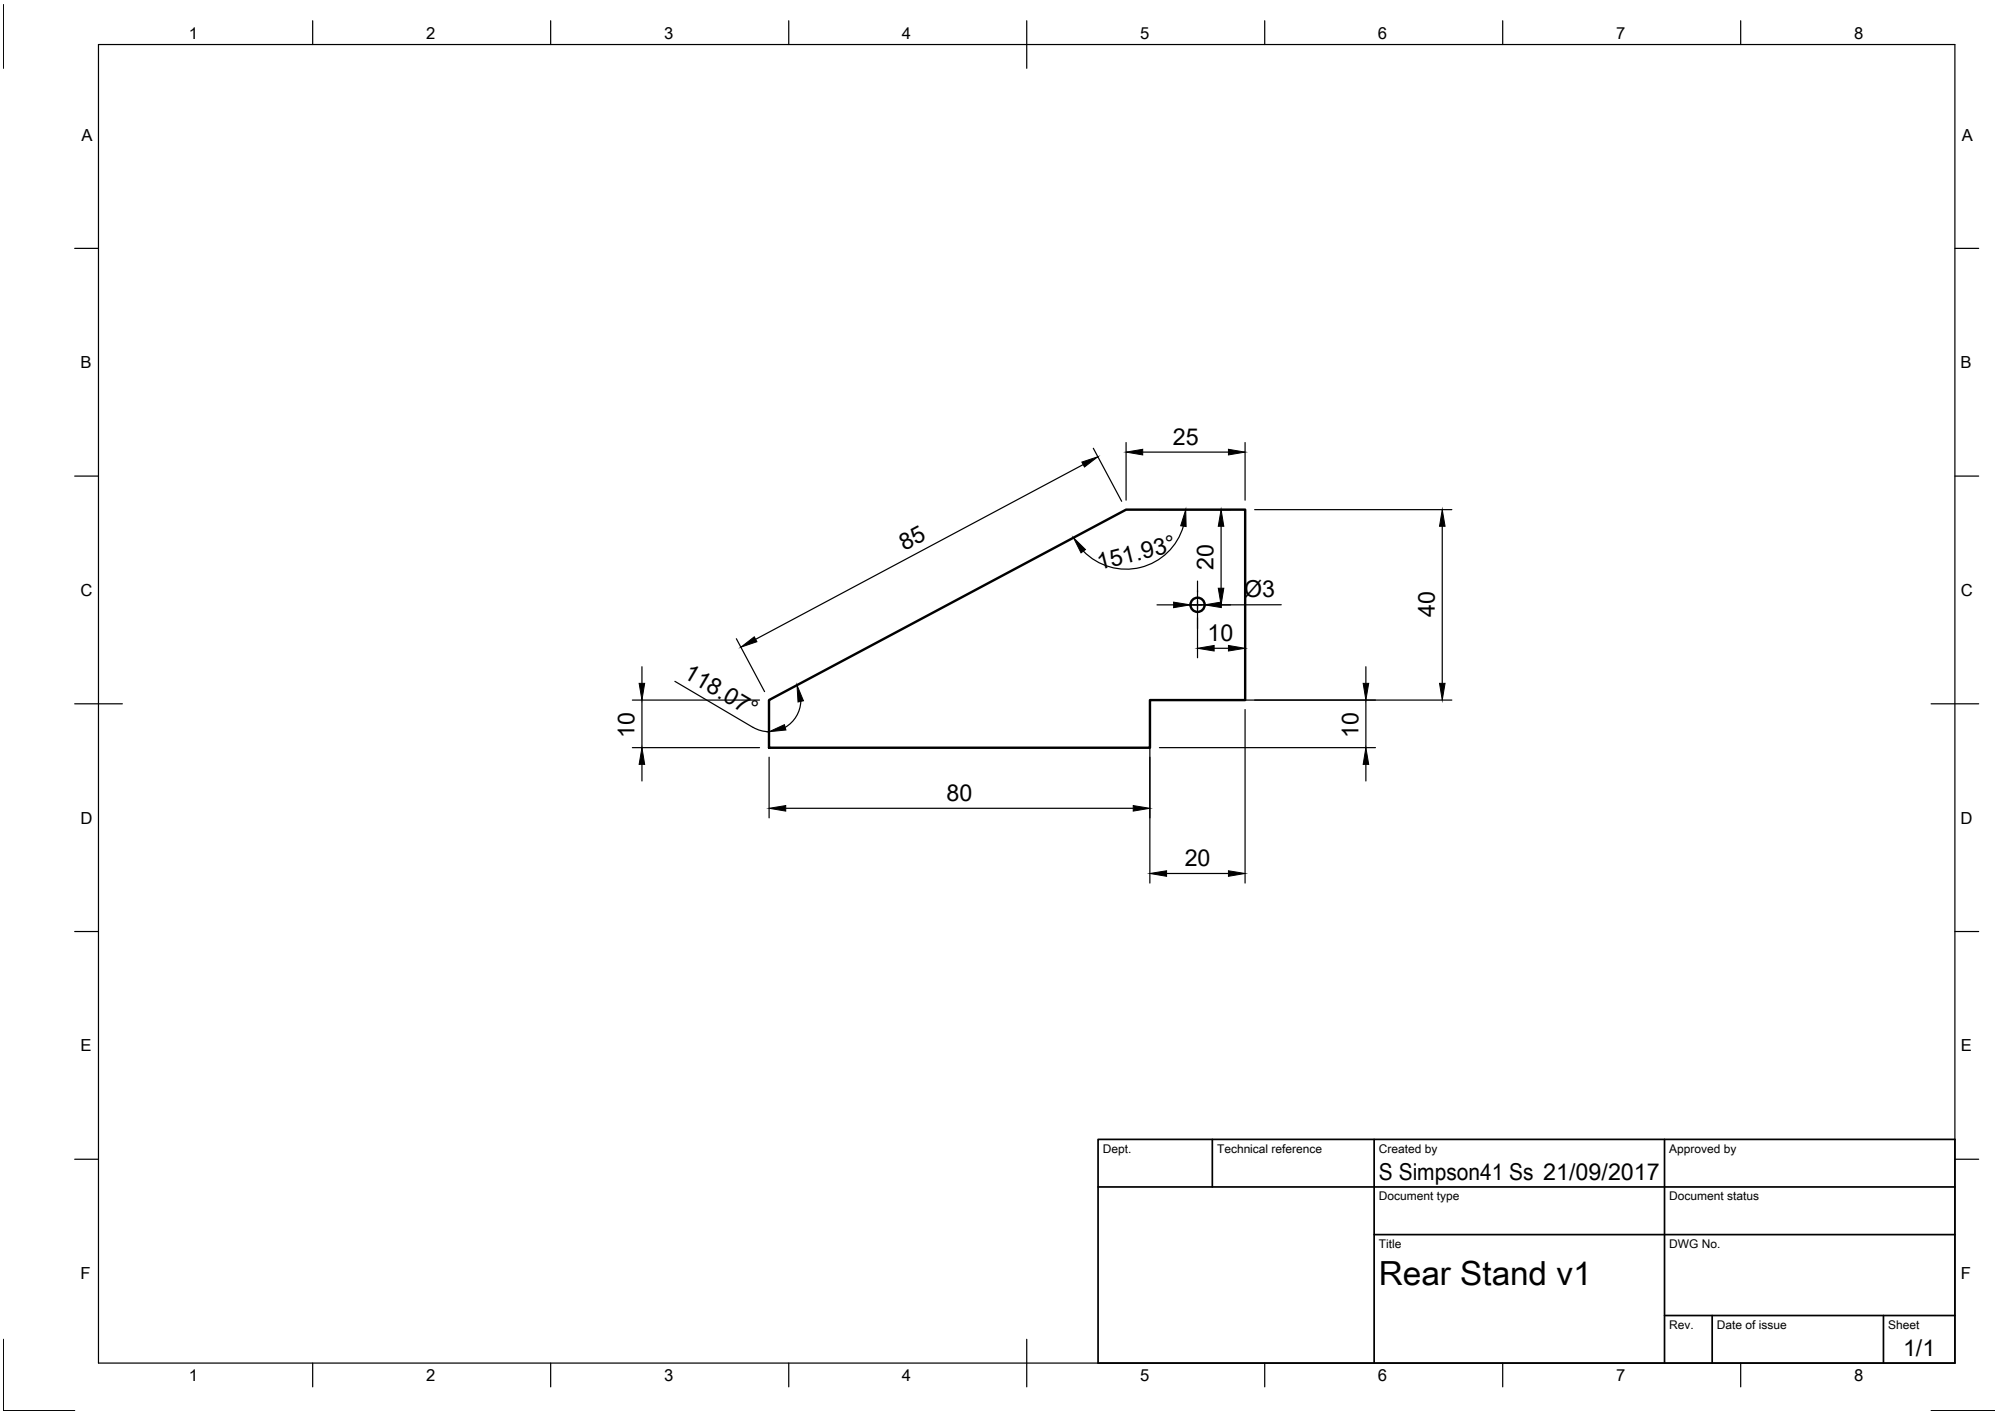
[picture p127: page 1]

Dept. | Technical reference | Created by S Simpson41 Ss 21/09/2017 | Approved by

Document type | Document status

Title Rear Stand v1 | DWG No.

Rev. | Date of issue | Sheet 1/1
