Quphoria/Electronics-Project/(list of files, drawings)

Other design files:
5- Circuit Design/Electronics Project Basic PCB 2.0 - test.dip
5- Circuit Design/Electronics Project Basic PCB 2.0.dip
5- Circuit Design/Electronics Project Basic PCB.dip
5- Circuit Design/Electronics Project Basic Schematic 2.0.dch
5- Circuit Design/Electronics Project Basic Schematic 2.0[Conflict].dch
5- Circuit Design/Electronics Project Basic Schematic.dch
5- Circuit Design/IR_Board.dch
5- Circuit Design/IR_Board.dip
