Quphoria/Electronics-Project/(commit log)

2017-10-03 Initialised Repository
    [Back Power Supply Holder.dxf, Bottom Cover.dxf, Bottom Power Supply Holder.dxf, DM1AA-SF-PEJ.stp, Electronics Project Basic PCB.dip, Electronics Project Basic Schematic.dch, Front LED Cover Panel.dxf, Grid Formula.xlsx]
2017-10-03 Moved around files in root dir
    [Grid Formula.xlsx]
2017-10-03 Added PCB Spacer stl
    [PCB Spacer.stl]
2017-10-03 Finished possible components and added possible circuits
2017-10-04 Made alterations to the IR Receiver casing holes due to parts 1mm thick and recreated relevant drawings, vector files and renders.
    [Front LED Cover Panel.dxf, Rear LED Cover Panel.dxf]
2017-10-10 Added notes on first stage of prototyping
2017-10-28 Many Changes have been made
    [Production Costs.xlsx]
2017-10-30 Updated Component Designs for power supply bracket
    [Back Power Supply Holder.dxf, Bottom Power Supply Holder.dxf, Rear LED Cover Panel.dxf]
2017-11-06 Updated Designs for power supply bracket due to 0.019mm offset and added new internal pictures
    [10MM MDF CUT.dxf, Bottom Cover.dxf, Bottom Power Supply Holder.dxf, IR-Remote Mapping.xlsx, Top Cover.dxf]
2017-11-11 Created New Powerpoint with more professional theme
2019-01-07 Project Finished - Very Late Commit
    [Back Power Supply Holder.dxf, Back cover inside.dxf, Back cover top.dxf, Back cover.dxf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]
